Ahhj93/mini-apterros/README.md

# Mini-Apterros
> [!Note]
> Fusée expérimentale du projet Perseus du CNES

## Contributeurs
|  |  |  |  | 
| :---: | :---: | :---: | :---: | :---: |
| [@Ahhj93](https://github.com/Ahhj93) | [@sblikeice](https://github.com/sblikeice) | [@Margaux-Lapl](https://github.com/Margaux-Lapl) | [@julien0305](https://github.com/julien0305) | [@JoaoCerq](https://github.com/JoaoCerq) |
| Bryan-Sowanna ING | Sara BAILLEUL | Margaux LAPLANTE | Julien THOMAS | João Pedro DA SILVA CERQUIERA |
