Ahhj93/mini-apterros/references_composants.md

## Références des composants
* Turbine de poussée : JP Hobby 120 mm
* Brushless moteur : 1413-KV5000 (12 pâles 40 mm)
