Ahhj93/mini-apterros/docs/labview/actionneurs.pdf

Evaluation
Actionneurs.vi
E:\CNES\Documents\Stage été 2024\Stage été 2024\MiniApterros_V1.2.4(12-07)\Code principal\

Last modified on 05/07/2024 at 11:58
Printed on 20/10/2026 at 14:12

Page 1

error in (no error)

error out
Pmax Roulis

Stop

Actionneurs.vi

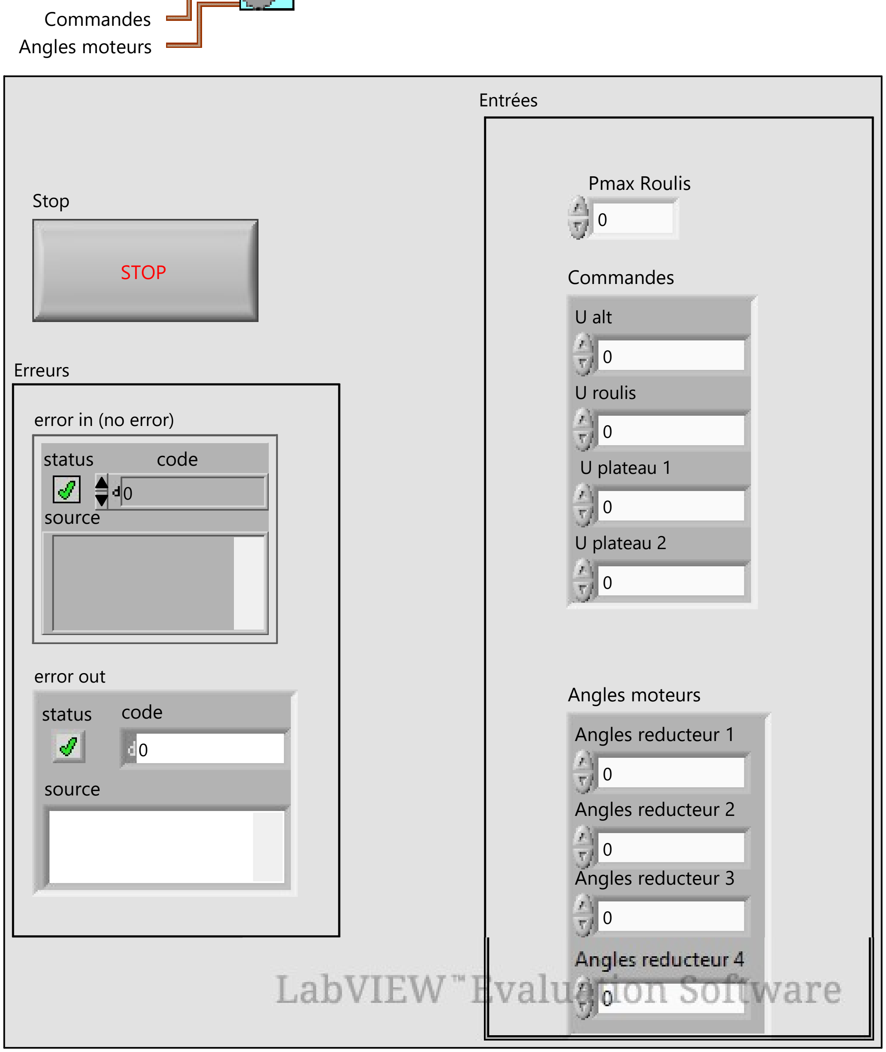
[picture p84: figure]
Angles moteurs; Commandes; STOP; Stop; status; code; source; error in (no error); error out; U alt; U roulis; U plateau 1; U plateau 2; Pmax Roulis; Erreurs; Entrées; Angles reducteur 1; Angles reducteur 2; Angles reducteur 3; Angles reducteur 4

Last modified on 05/07/2024 at 11:58 Printed on 20/10/2026 at 14:12

Page 2

Stop
error in (no error)
<B>error in</B> can accept error information wired from VIs previously called. Use this information to decide if any functionality should be bypassed in the event of errors from other VIs.

Right-click the <B>error in</B> control on the front panel and select <B>Explain Error</B> or <B>Explain Warning</B> from the shortcut menu for more information about the error.
status
<B>status</B> is TRUE (X) if an error occurred or FALSE (checkmark) to indicate a warning or that no error occurred.

Right-click the <B>error in</B> control on the front panel and select <B>Explain Error</B> or <B>Explain Warning</B> from the shortcut menu for more information about the error.
code
<B>code</B> is the error or warning code.

Right-click the <B>error in</B> control on the front panel and select <B>Explain Error</B> or <B>Explain Warning</B> from the shortcut menu for more information about the error. source
<B>source</B> describes the origin of the error or warning.

Right-click the <B>error in</B> control on the front panel and select <B>Explain Error</B> or <B>Explain Warning</B> from the shortcut menu for more information about the error. Commandes
U alt
U roulis
U plateau 1
U plateau 2
Pmax Roulis
Angles moteurs
Angles reducteur 1
Angles reducteur 2
Angles reducteur 3
Angles reducteur 4
error out
<B>error in</B> can accept error information wired from VIs previously called. Use this information to decide if any functionality should be bypassed in the event of errors from other VIs.

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

Last modified on 05/07/2024 at 11:58 Printed on 20/10/2026 at 14:12

Page 3

status
<B>status</B> is TRUE (X) if an error occurred or FALSE (checkmark) to indicate a warning or that no error occurred.

Right-click the <B>error in</B> control on the front panel and select <B>Explain Error</B> or <B>Explain Warning</B> from the shortcut menu for more information about the error.
code
<B>code</B> is the error or warning code.

Right-click the <B>error in</B> control on the front panel and select <B>Explain Error</B> or <B>Explain Warning</B> from the shortcut menu for more information about the error. source
<B>source</B> describes the origin of the error or warning.

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

Stop

error in (no error)

50

0,1

0,05

0,1

0,05

0

error out

0,05

0,05

Commandes

Angle plateau 2.vi

Angle plateau 1.vi

float64 w1=0.05*(1+alpha)+0.05*(1-alpha)*u; float64 w2=0.05*(1+alpha)-0.05*(1-alpha)*u;

w2

w1

alpha

u

Pmax Roulis

100

Angles moteurs

90

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

Page 4

Angle plateau 2.vi
E:\CNES\Documents\Stage été 2024\Stage été 2024\MiniApterros_V1.2.4(12-07)\Code principal\Angle plateau 2.vi
Angle plateau 1.vi
E:\CNES\Documents\Stage été 2024\Stage été 2024\MiniApterros_V1.2.4(12-07)\Code principal\Angle plateau 1.vi
"Actionneurs.vi History"
Current Revision: 121
