Ahhj93/mini-apterros/docs/labview/Angles plateau 1.pdf

Evaluation
Angle plateau 1.vi
E:\CNES\Stage été 2025 v2\Code principal\Angle plateau 1.vi Last modified on 28/03/2025 at 16:16
Printed on 20/10/2026 at 15:02

Page 1

error out

Angle mesuré

Consigne

Angle plateau 1.vi

0 | 0,02 | 0,04 | 0,06 | 0,08 | 0,1

0,02

Proportional Gain (K)

100

-100

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
Consigne

0 0,1 0,2 0,3 0,4 0,5 0,6 0,7 0,8 0,9 1

100

Integral Time (Ti)

0 | 0,02 | 0,04 | 0,06 | 0,08 | 0,1

0,02

Derivative Time (Td)

0

status code 100

-100

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
Angle mesuré

0

Amplitude de sortie

Proportional Gain (K)
<B>Proportional Gain (Kc)</B> represents the proportional gain of the controller.
Consigne
Integral Time (Ti)
<B>Integral Gain (Ki)</B> is the controller parameter that adjusts the effect of the error integral term E(s)/s on the controller output U(s).
Derivative Time (Td)
<B>Integral Gain (Ki)</B> is the controller parameter that adjusts the effect of the error integral term E(s)/s on the controller output U(s).
Angle mesuré
error out
<B>error out</B> passes error or warning information out of a VI to be used by other VIs.

Right-click the <B>error out</B> indicator on the front panel and select <B>Explain Error</B> or <B>Explain Warning</B> from the shortcut menu for more information about the error.
status
code

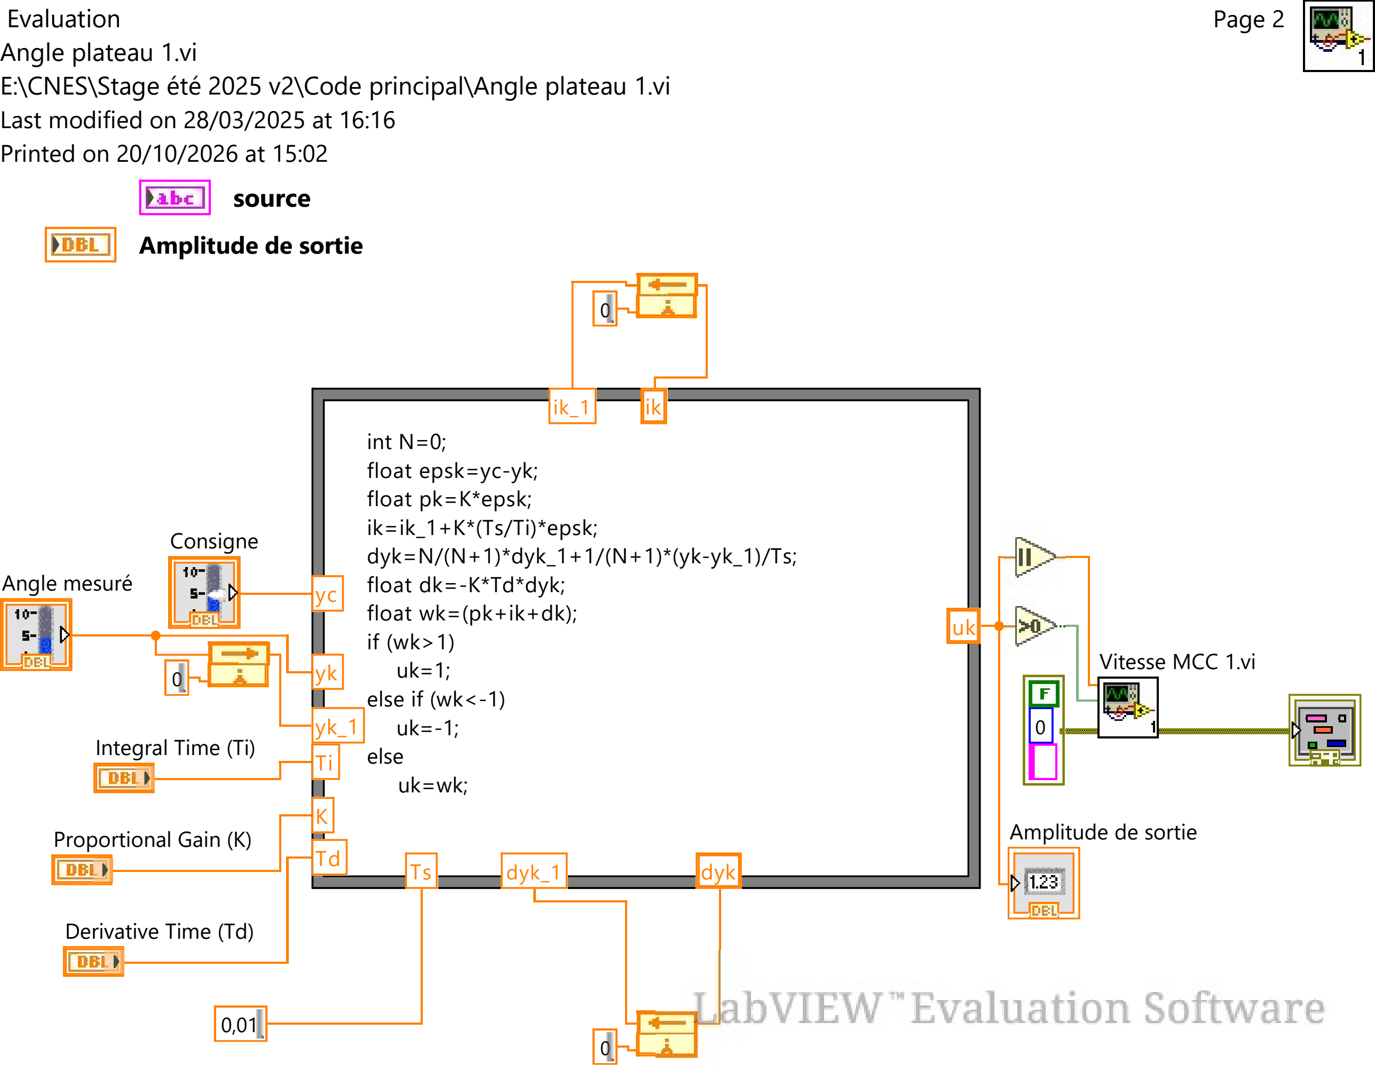
[picture p85: figure]
Evaluation Angle plateau 1.vi; Last modified on 28/03/2025 at 16:16 Printed on 20/10/2026 at 15:02; Page 2; source; Amplitude de sortie; Proportional Gain (K); Consigne; Integral Time (Ti); Derivative Time (Td); int N=0; float epsk=yc-yk; float pk=K*epsk; ik=ik_1+K*(Ts/Ti)*epsk; dyk=N/(N+1)*dyk_1+1/(N+1)*(yk-yk_1)/Ts; float dk=-K*Td*dyk; float wk=(pk+ik+dk); if (wk>1) uk=1; else if (wk<-1) uk=-1; else uk=wk;; dyk_1; dyk; Angle mesuré; Vitesse MCC 1.vi

E:\CNES\Stage été 2025 v2\Code principal\Angle plateau 1.vi
