Ahhj93/mini-apterros/docs/labview/Angles plateau 2.pdf

Evaluation
Angle plateau 2.vi
E:\CNES\Stage été 2025 v2\Code principal\Angle plateau 2.vi Last modified on 28/03/2025 at 16:32
Printed on 20/10/2026 at 15:02

Page 1

Angle plateau 2.vi

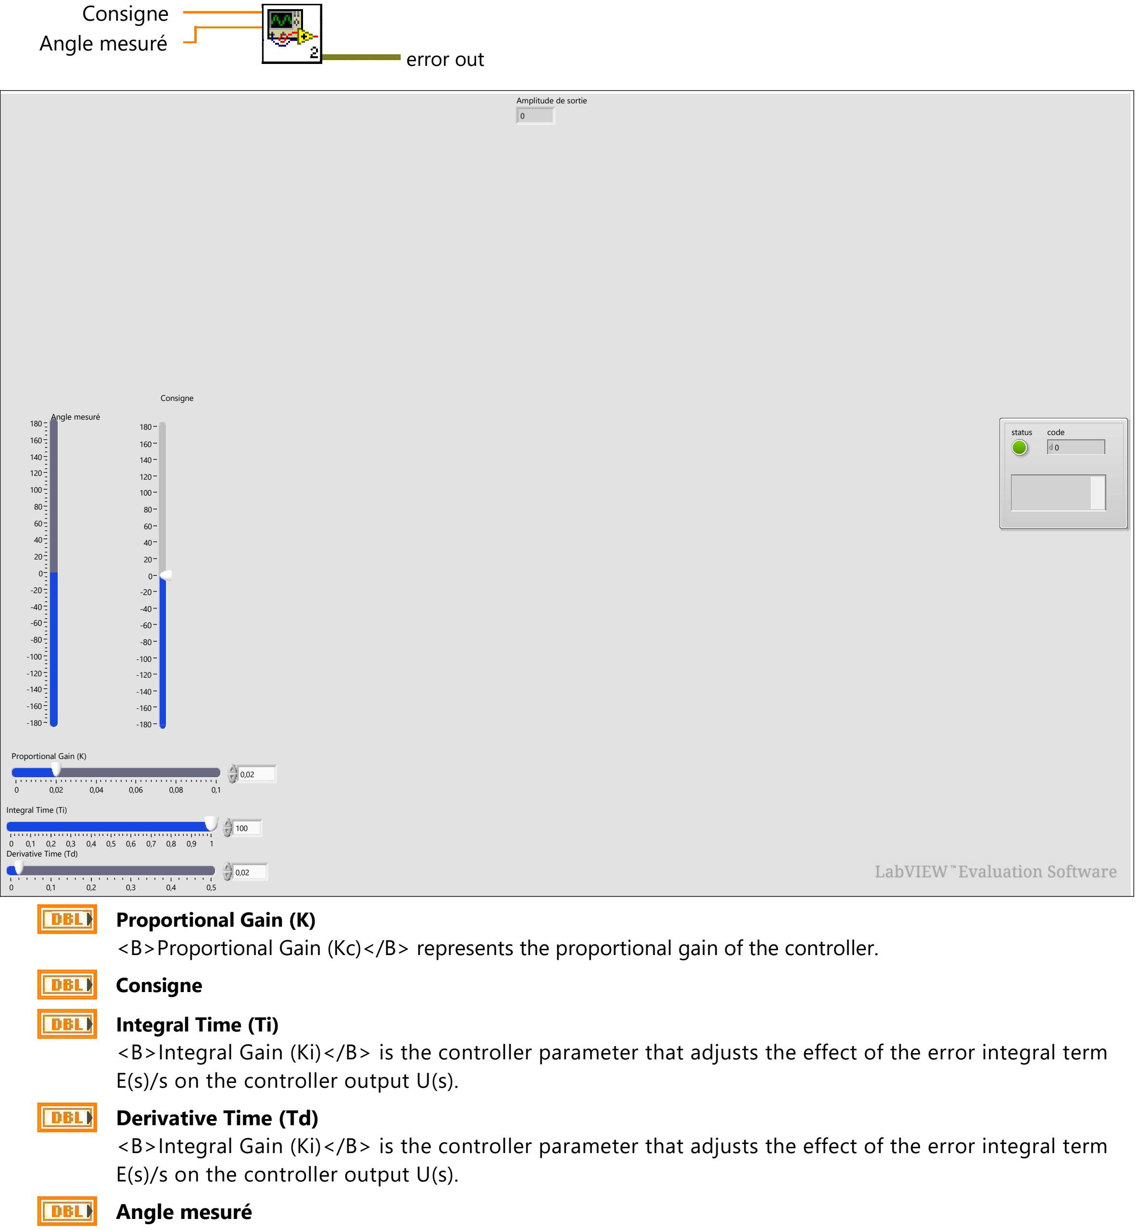
[picture p86: figure]
error out; Angle mesuré; Consigne; Proportional Gain (K); Integral Time (Ti); Derivative Time (Td); status; code; Amplitude de sortie; E(s)/s on the controller output U(s). Derivative Time (Td); E(s)/s on the controller output U(s). Angle mesuré

<B>Proportional Gain (Kc)</B> represents the proportional gain of the controller.

<B>Integral Gain (Ki)</B> is the controller parameter that adjusts the effect of the error integral term

<B>Integral Gain (Ki)</B> is the controller parameter that adjusts the effect of the error integral term

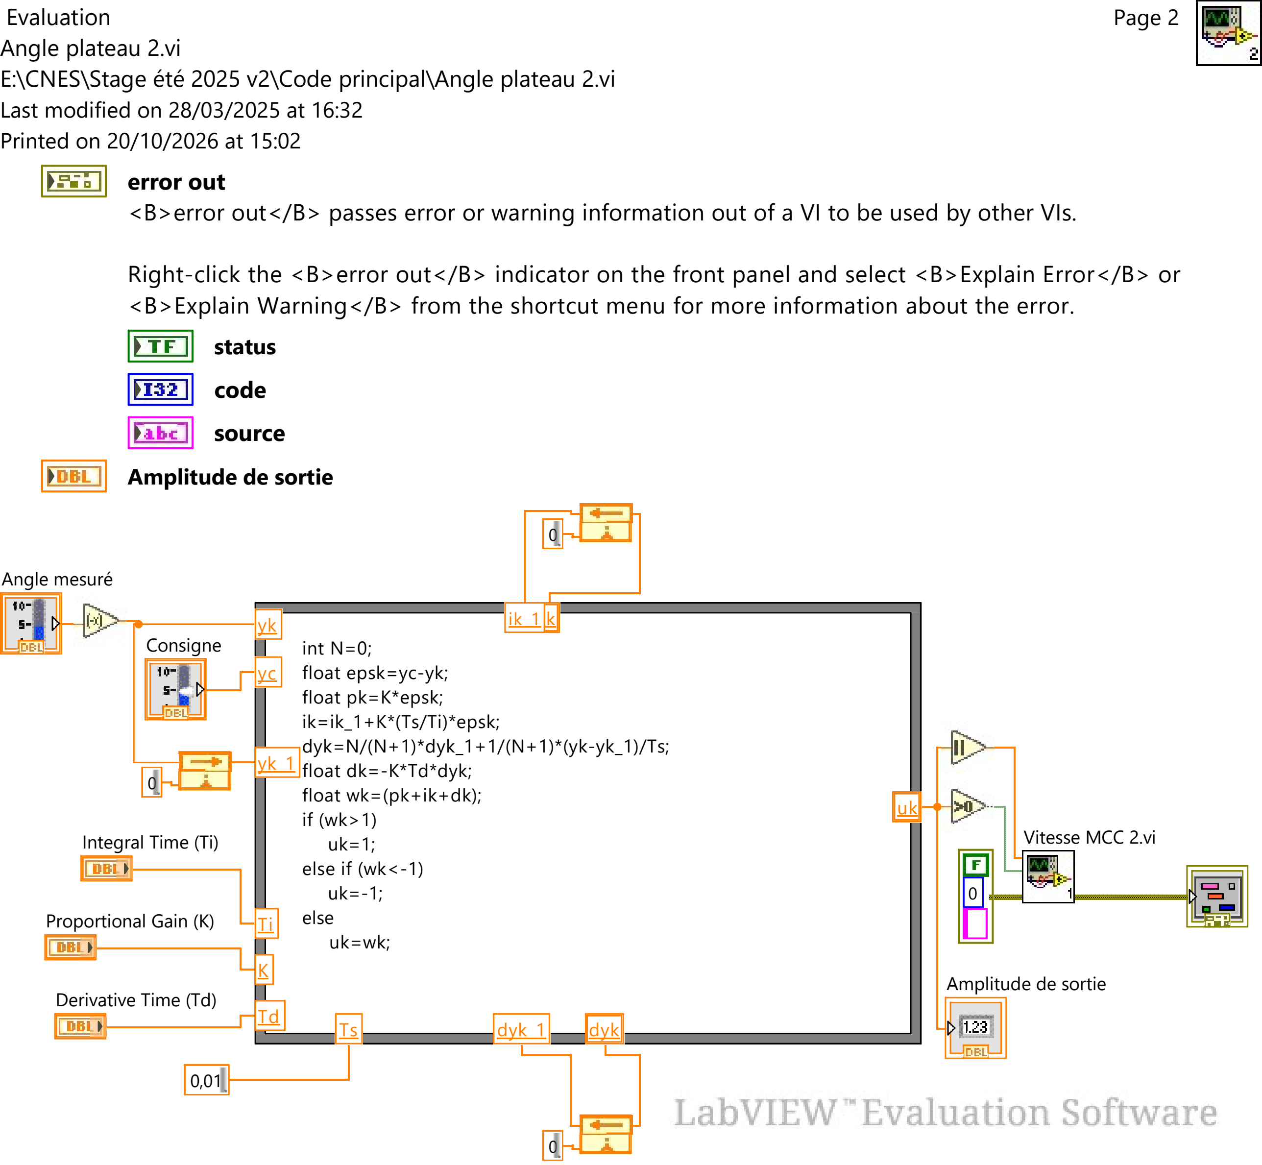
[picture p87: figure]
Evaluation Angle plateau 2.vi; Last modified on 28/03/2025 at 16:32 Printed on 20/10/2026 at 15:02; Page 2; error out; status code source; Amplitude de sortie; Proportional Gain (K); Consigne; Integral Time (Ti); Derivative Time (Td); int N=0; float epsk=yc-yk; float pk=K*epsk; ik=ik_1+K*(Ts/Ti)*epsk; dyk=N/(N+1)*dyk_1+1/(N+1)*(yk-yk_1)/Ts; float dk=-K*Td*dyk; float wk=(pk+ik+dk); if (wk>1) uk=1; else if (wk<-1) uk=-1; else uk=wk;; dyk_1; dyk; Angle mesuré; Vitesse MCC 2.vi

E:\CNES\Stage été 2025 v2\Code principal\Angle plateau 2.vi

<B>error out</B> passes error or warning information out of a VI to be used by other VIs.

Right-click the <B>error out</B> indicator on the front panel and select <B>Explain Error</B> or <B>Explain Warning</B> from the shortcut menu for more information about the error.
