Ahhj93/mini-apterros/docs/labview/Capteurs Angles.pdf

Evaluation
Capteurs Angles.vi
E:\CNES\Stage été 2025 v2\Code principal\Capteurs Angles.vi Last modified on 28/03/2025 at 16:59
Printed on 20/10/2026 at 15:01

Page 1

Angles Hall en degré

error in (no error) | error out

Arrêt

Capteurs Angles.vi

Arrêt | Angles Hall en degré

status
0

code

source

error in (no error)

status
0

code

source

error out

Arrêt
error in (no error)
<B>error in</B> can accept error information wired from VIs previously called. Use this information to decide if any functionality should be bypassed in the event of errors from other VIs.

Right-click the <B>error in</B> control on the front panel and select <B>Explain Error</B> or <B>Explain Warning</B> from the shortcut menu for more information about the error.
status
<B>status</B> is TRUE (X) if an error occurred or FALSE (checkmark) to indicate a warning or that no error occurred.

Right-click the <B>error in</B> control on the front panel and select <B>Explain Error</B> or <B>Explain Warning</B> from the shortcut menu for more information about the error.
code
<B>code</B> is the error or warning code.

Right-click the <B>error in</B> control on the front panel and select <B>Explain Error</B> or <B>Explain Warning</B> from the shortcut menu for more information about the error. source
<B>source</B> describes the origin of the error or warning.

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

Evaluation
Capteurs Angles.vi
E:\CNES\Stage été 2025 v2\Code principal\Capteurs Angles.vi Last modified on 28/03/2025 at 16:59
Printed on 20/10/2026 at 15:01

Page 2

Angles Hall en degré
error out
<B>error in</B> can accept error information wired from VIs previously called. Use this information to decide if any functionality should be bypassed in the event of errors from other VIs.

Right-click the <B>error in</B> control on the front panel and select <B>Explain Error</B> or <B>Explain Warning</B> from the shortcut menu for more information about the error.
status
<B>status</B> is TRUE (X) if an error occurred or FALSE (checkmark) to indicate a warning or that no error occurred.

Right-click the <B>error in</B> control on the front panel and select <B>Explain Error</B> or <B>Explain Warning</B> from the shortcut menu for more information about the error.
code
<B>code</B> is the error or warning code.

Right-click the <B>error in</B> control on the front panel and select <B>Explain Error</B> or <B>Explain Warning</B> from the shortcut menu for more information about the error. source
<B>source</B> describes the origin of the error or warning.

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

Arrêt

Angles Hall en degré

error in (no error)

Valeur n-1 Angle hall 1

Valeur n-1 Anglel hall 2

error out
Lecture angle MCC1.vi

Lecture angle MCC2.vi

Angle hall 1

Angle hall 2

Valeur n-1 Anglel hall 2

Valeur n-1 Angle hall 1
