Ahhj93/mini-apterros/docs/labview/changement adresse Lidar.pdf

Evaluation
Changement adresse Lidar.vi
E:\CNES\Stage été 2025 v2\Code principal\Changement adresse Lidar.vi Last modified on 21/10/2025 at 17:24
Printed on 20/10/2026 at 15:01

Page 1

error in (no error) | error out

Changement adresse Lidar.vi

status
0

code

source

error in (no error)
status
0

code

source

error out

error in (no error)
<B>error in</B> can accept error information wired from VIs previously called. Use this information to decide if any functionality should be bypassed in the event of errors from other VIs.

Right-click the <B>error in</B> control on the front panel and select <B>Explain Error</B> or <B>Explain Warning</B> from the shortcut menu for more information about the error.
status
<B>status</B> is TRUE (X) if an error occurred or FALSE (checkmark) to indicate a warning or that no error occurred.

Right-click the <B>error in</B> control on the front panel and select <B>Explain Error</B> or <B>Explain Warning</B> from the shortcut menu for more information about the error.
code
<B>code</B> is the error or warning code.

Right-click the <B>error in</B> control on the front panel and select <B>Explain Error</B> or <B>Explain Warning</B> from the shortcut menu for more information about the error. source
<B>source</B> describes the origin of the error or warning.

Right-click the <B>error in</B> control on the front panel and select <B>Explain Error</B> or <B>Explain Warning</B> from the shortcut menu for more information about the error. error out
<B>error in</B> can accept error information wired from VIs previously called. Use this information to decide if any functionality should be bypassed in the event of errors from other VIs.

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

Evaluation
Changement adresse Lidar.vi
E:\CNES\Stage été 2025 v2\Code principal\Changement adresse Lidar.vi Last modified on 21/10/2025 at 17:24
Printed on 20/10/2026 at 15:01

Page 2

status
<B>status</B> is TRUE (X) if an error occurred or FALSE (checkmark) to indicate a warning or that no error occurred.

Right-click the <B>error in</B> control on the front panel and select <B>Explain Error</B> or <B>Explain Warning</B> from the shortcut menu for more information about the error.
code
<B>code</B> is the error or warning code.

Right-click the <B>error in</B> control on the front panel and select <B>Explain Error</B> or <B>Explain Warning</B> from the shortcut menu for more information about the error. source
<B>source</B> describes the origin of the error or warning.

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

error in (no error)

62

0 | 18 | 30
0 | 1A | 64
0 | 1E | 8
0 | 19 | 52

error out

True

64

0 1
| 1

Test de lecture de donnée dans un registre LISIBLE pour savoir si l'adresse du lidar est déjà changée. Si c'est le cas, alors on ne peut plus faire le changement

False
