Ahhj93/mini-apterros/docs/labview/Globalvi.pdf

Evaluation
Globalvi.vi
E:\CNES\Stage été 2025 v2\Code principal\Globalvi.vi Last modified on 28/03/2025 at 16:59
Printed on 20/10/2026 at 14:58

Page 1

Globalvi.vi

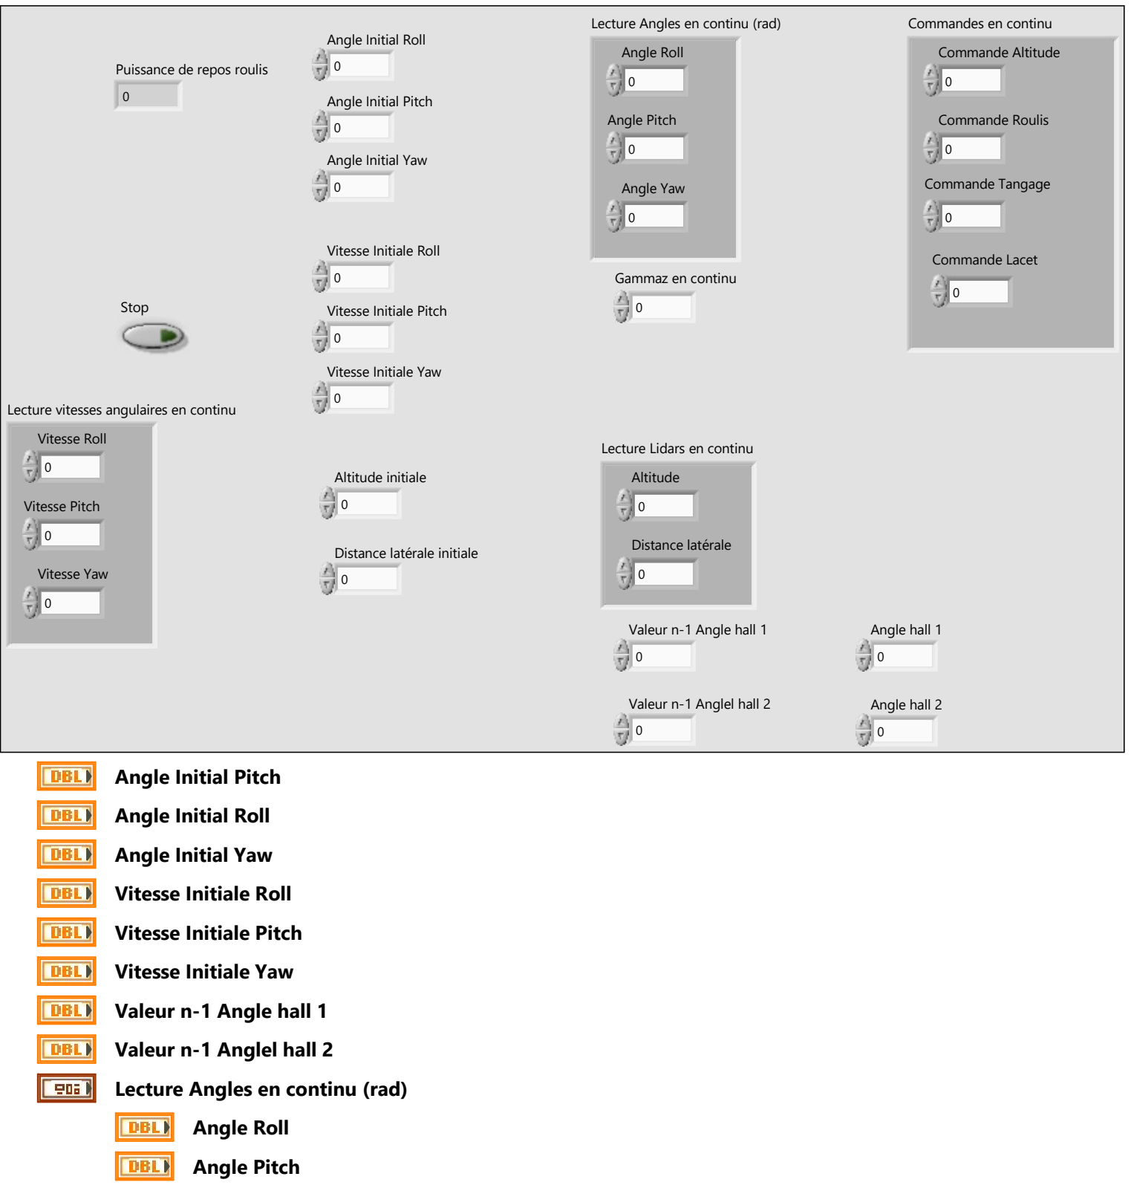
[picture p88: figure]
Angle Initial Pitch; Angle Initial Roll; Angle Initial Yaw; Vitesse Initiale Roll; Vitesse Initiale Pitch; Vitesse Initiale Yaw; Valeur n-1 Angle hall 1; Valeur n-1 Anglel hall 2; Angle Roll; Angle Pitch; Angle Yaw; Lecture Angles en continu (rad); Altitude; Distance latérale; Lecture Lidars en continu; Commande Altitude; Commande Roulis; Commande Tangage; Commande Lacet; Commandes en continu; Stop; Altitude initiale; Distance latérale initiale; Gammaz en continu; Puissance de repos roulis; Angle hall 1; Angle hall 2; Vitesse Roll; Vitesse Pitch; Vitesse Yaw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

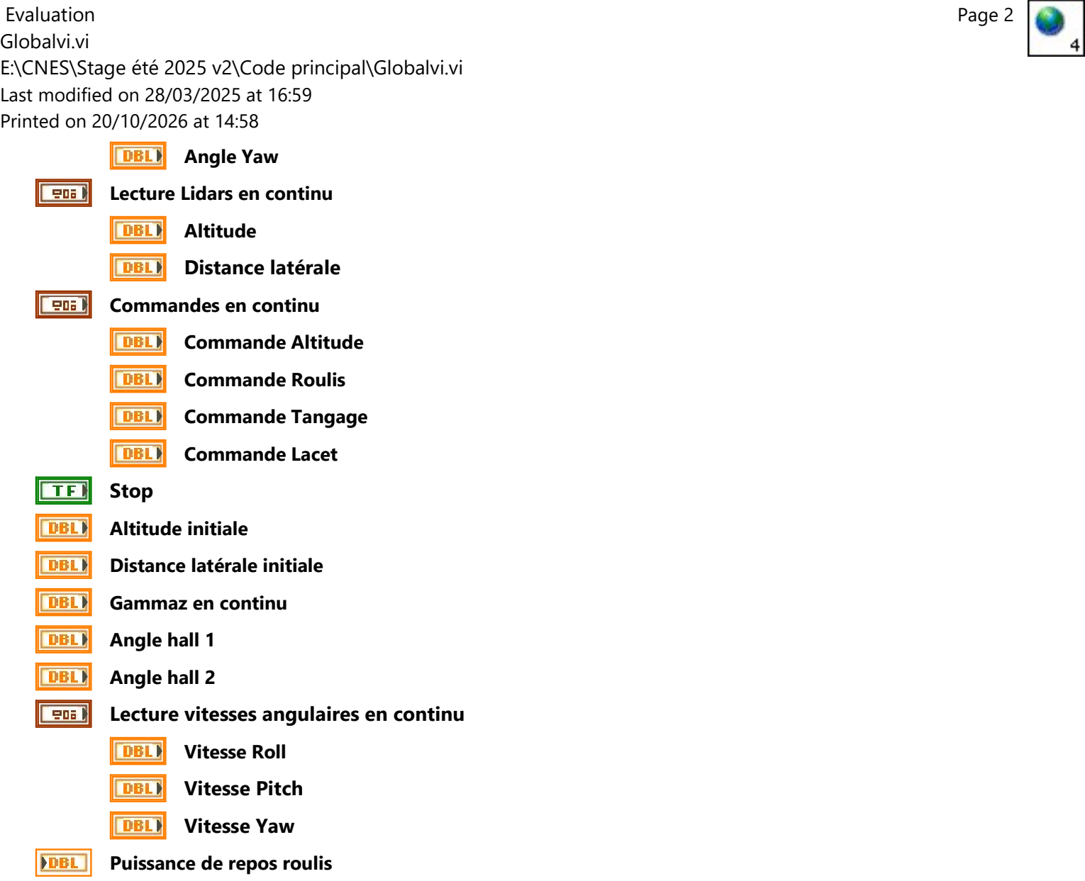
[picture p89: figure]
Evaluation Globalvi.vi E:\CNES\Stage été 2025 v2\Code principal\Globalvi.vi Last modified on 28/03/2025 at 16:59 Printed on 20/10/2026 at 14:58; Page 2; Angle Yaw; Lecture Lidars en continu; Altitude Distance latérale; Commandes en continu; Commande Altitude; Commande Roulis; Commande Tangage; Commande Lacet; Stop; Altitude initiale; Distance latérale initiale; Gammaz en continu; Angle hall 1; Angle hall 2 Lecture vitesses angulaires en continu; Vitesse Roll Vitesse Pitch Vitesse Yaw; Puissance de repos roulis
