Ahhj93/mini-apterros/docs/labview/IMU v2.pdf

Evaluation
IMU v2.vi
E:\CNES\Stage été 2025 v2\Code principal\IMU v2.vi Last modified on 28/03/2025 at 16:59
Printed on 20/10/2026 at 14:57

Page 1

IMU v2.vi

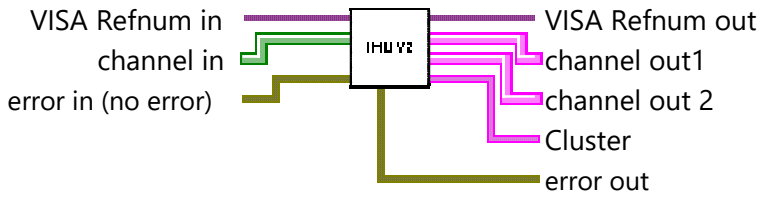
[picture p90: figure]
VISA Refnum out channel out1 channel out 2 Cluster error out; error in (no error); channel in; VISA Refnum in
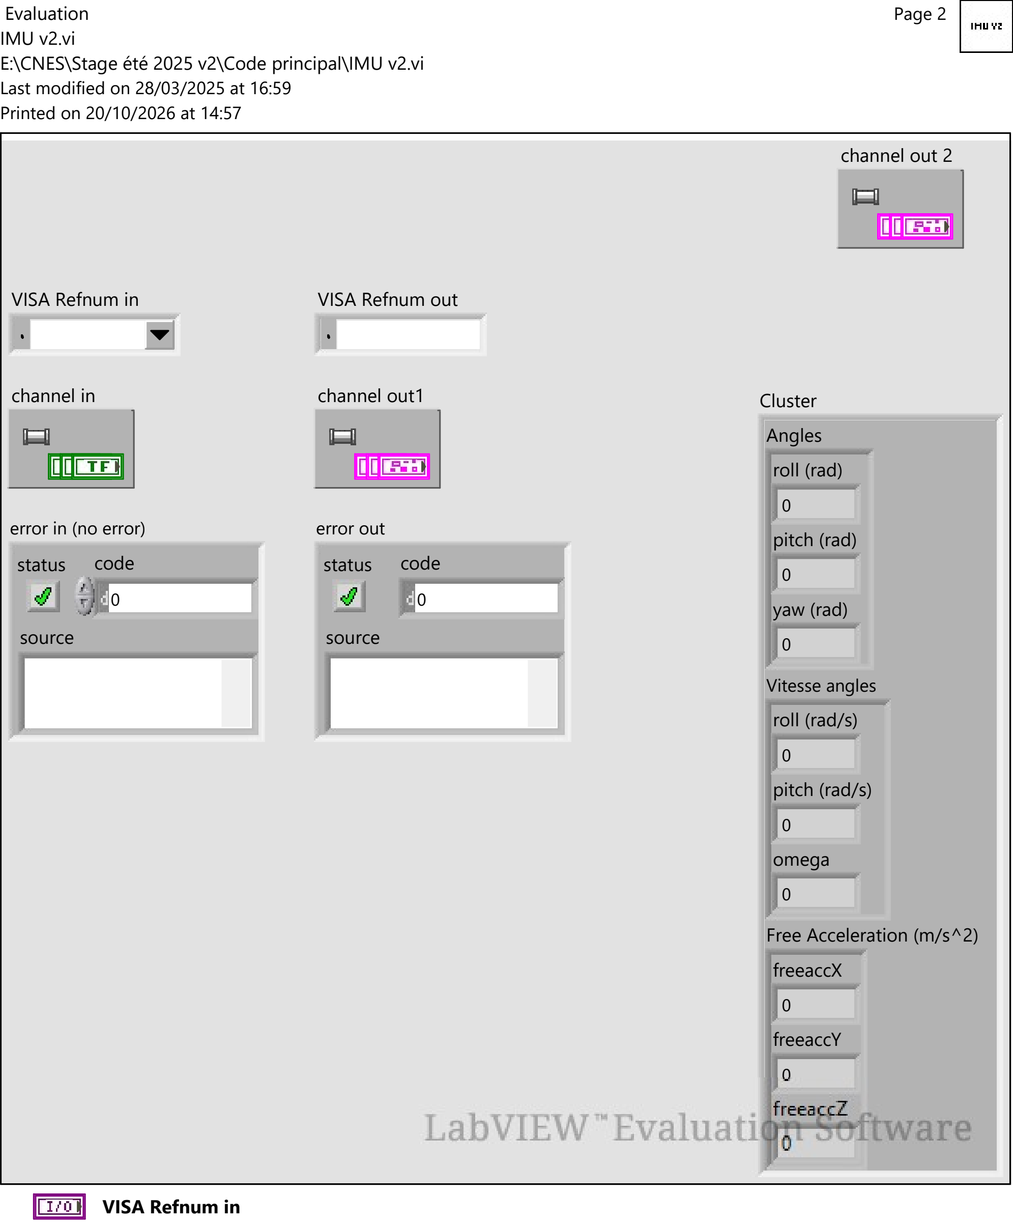
[picture p91: page 2]

Printed on 20/10/2026 at 14:57

Page 2

status
0

code

source

error out

VISA Refnum in | VISA Refnum out

status
0

code

source

error in (no error)

channel in | channel out1

0

freeaccZ

0

freeaccY

0

freeaccX

Free Acceleration (m/s^2)

0

omega

0

pitch (rad/s)

0

roll (rad/s)

Vitesse angles

0

yaw (rad)

0

pitch (rad)

0

roll (rad)

Angles

Cluster

channel out 2

VISA Refnum in

Printed on 20/10/2026 at 14:57

Page 3

error in (no error)
<B>error in</B> can accept error information wired from VIs previously called. Use this information to decide if any functionality should be bypassed in the event of errors from other VIs.

Right-click the <B>error in</B> control on the front panel and select <B>Explain Error</B> or <B>Explain Warning</B> from the shortcut menu for more information about the error.
status
<B>status</B> is TRUE (X) if an error occurred or FALSE (checkmark) to indicate a warning or that no error occurred.

Right-click the <B>error in</B> control on the front panel and select <B>Explain Error</B> or <B>Explain Warning</B> from the shortcut menu for more information about the error.
code
<B>code</B> is the error or warning code.

Right-click the <B>error in</B> control on the front panel and select <B>Explain Error</B> or <B>Explain Warning</B> from the shortcut menu for more information about the error. source
<B>source</B> describes the origin of the error or warning.

Right-click the <B>error in</B> control on the front panel and select <B>Explain Error</B> or <B>Explain Warning</B> from the shortcut menu for more information about the error. channel in
error out
<B>error in</B> can accept error information wired from VIs previously called. Use this information to decide if any functionality should be bypassed in the event of errors from other VIs.

Right-click the <B>error in</B> control on the front panel and select <B>Explain Error</B> or <B>Explain Warning</B> from the shortcut menu for more information about the error.
status
<B>status</B> is TRUE (X) if an error occurred or FALSE (checkmark) to indicate a warning or that no error occurred.

Right-click the <B>error in</B> control on the front panel and select <B>Explain Error</B> or <B>Explain Warning</B> from the shortcut menu for more information about the error.
code
<B>code</B> is the error or warning code.

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

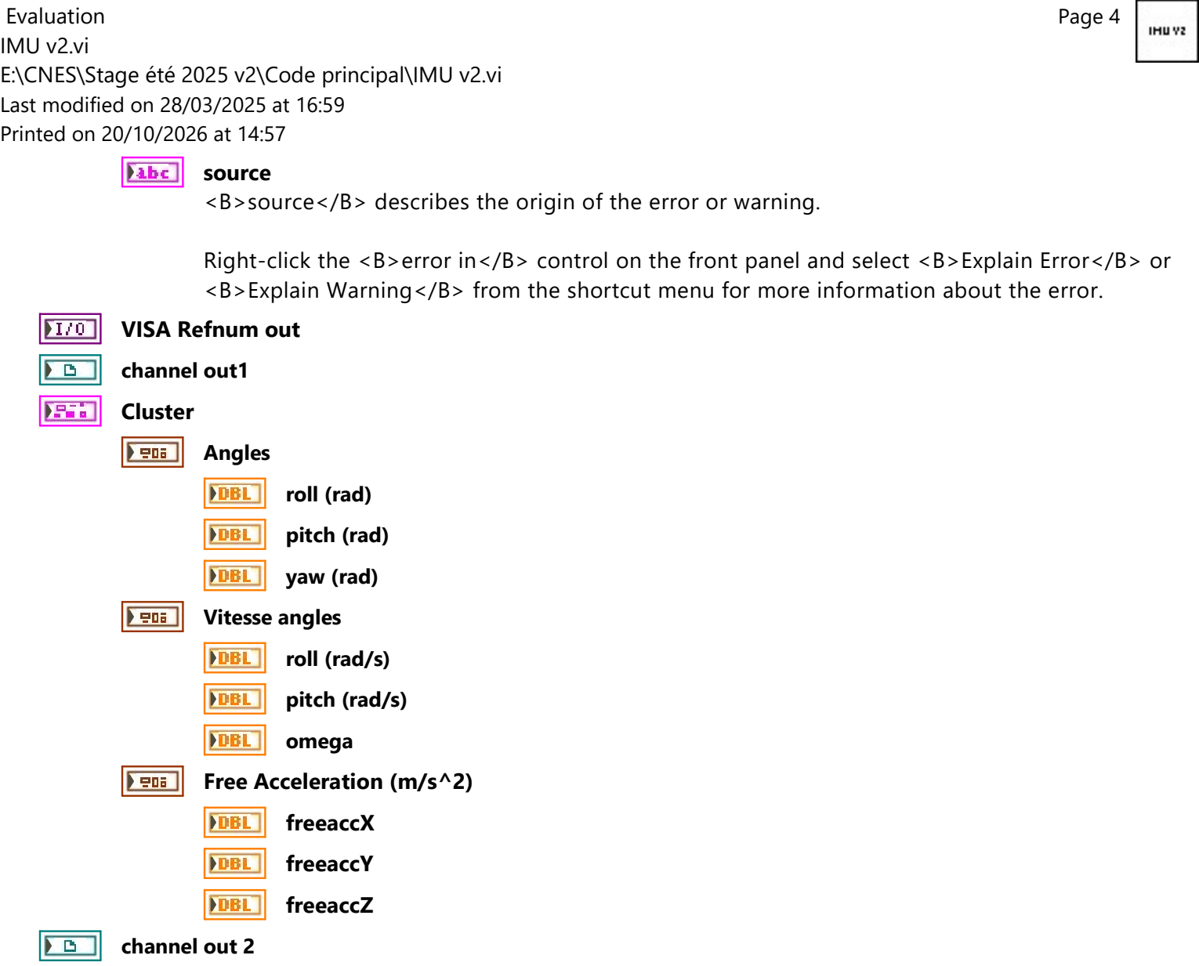
[picture p92: figure]
Printed on 20/10/2026 at 14:57; Page 4; source; VISA Refnum out; channel out1 Cluster; Angles; roll (rad); pitch (rad); yaw (rad); Vitesse angles; roll (rad/s); pitch (rad/s); omega Free Acceleration (m/s^2) freeaccX freeaccY freeaccZ; channel out 2

<B>source</B> describes the origin of the error or warning.

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

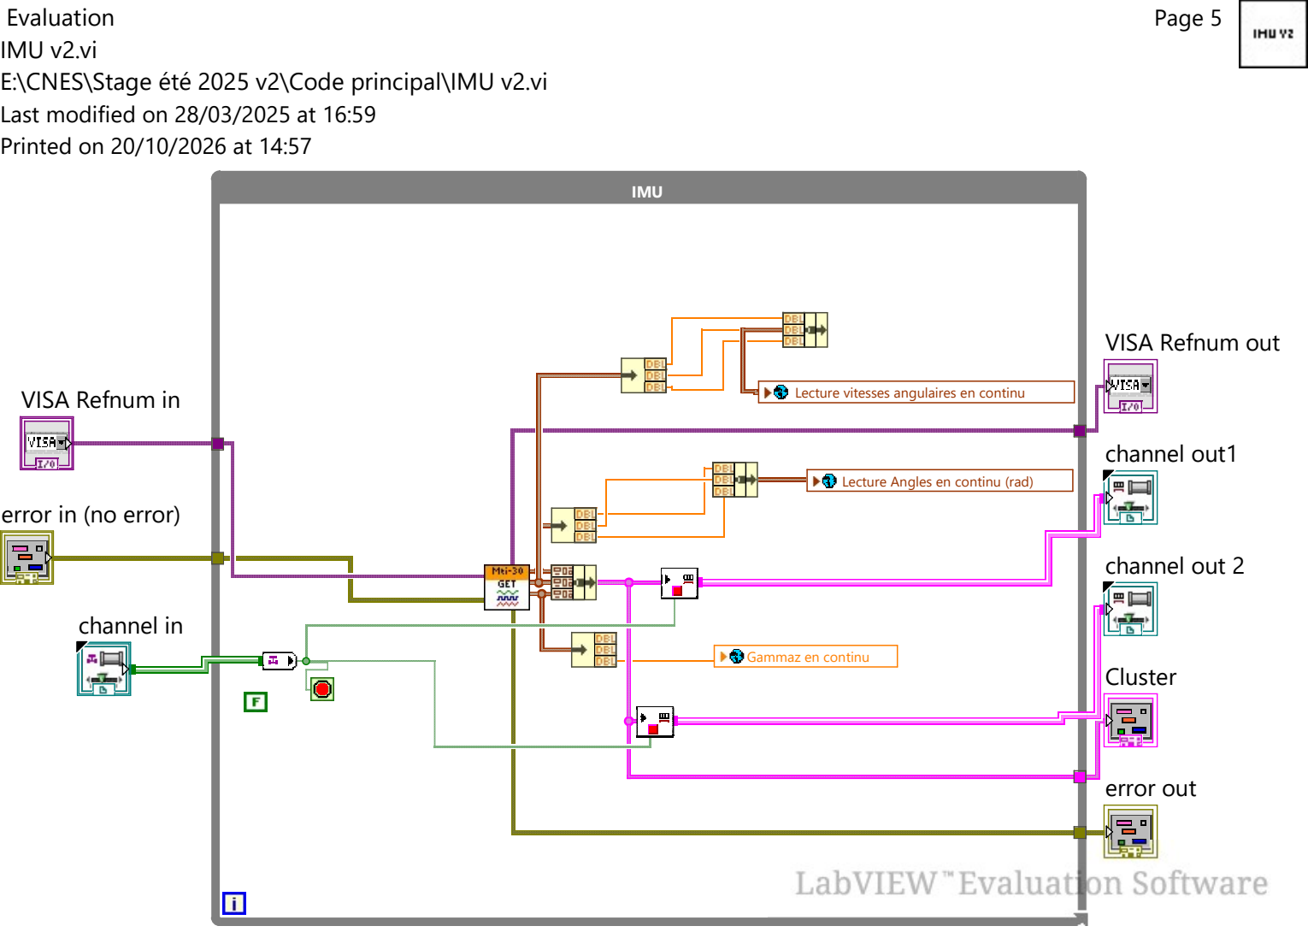
[picture p93: figure]
Printed on 20/10/2026 at 14:57; Page 5; IMU; Lecture Angles en continu (rad); Gammaz en continu; Lecture vitesses angulaires en continu; error out; VISA Refnum out; VISA Refnum in; error in (no error); channel in; channel out1; Cluster; channel out 2
