Ahhj93/mini-apterros/docs/labview/Initialisation Lidar.pdf

Evaluation
Initialisation Lidar.vi
E:\CNES\Stage été 2025 v2\Code principal\Initialisation Lidar.vi Last modified on 21/10/2025 at 17:24
Printed on 20/10/2026 at 14:56

Page 1

error out
error in (no error)

Slave Address (7-bit)

Initialisation Lidar.vi

status
0

code

source

error out

status
0

code

source

error in (no error)

0

Slave Address (7-bit)

error in (no error)
<B>error in</B> can accept error information wired from VIs previously called. Use this information to decide if any functionality should be bypassed in the event of errors from other VIs.

Right-click the <B>error in</B> control on the front panel and select <B>Explain Error</B> or <B>Explain Warning</B> from the shortcut menu for more information about the error.
status
<B>status</B> is TRUE (X) if an error occurred or FALSE (checkmark) to indicate a warning or that no error occurred.

Right-click the <B>error in</B> control on the front panel and select <B>Explain Error</B> or <B>Explain Warning</B> from the shortcut menu for more information about the error.

Printed on 20/10/2026 at 14:56

Page 2

code
<B>code</B> is the error or warning code.

Right-click the <B>error in</B> control on the front panel and select <B>Explain Error</B> or <B>Explain Warning</B> from the shortcut menu for more information about the error. source
<B>source</B> describes the origin of the error or warning.

Right-click the <B>error in</B> control on the front panel and select <B>Explain Error</B> or <B>Explain Warning</B> from the shortcut menu for more information about the error. Slave Address (7-bit)
error out
<B>error out</B> passes error or warning information out of a VI to be used by other VIs.

Right-click the <B>error out</B> indicator on the front panel and select <B>Explain Error</B> or <B>Explain Warning</B> from the shortcut menu for more information about the error.
status
<B>status</B> is TRUE (X) if an error occurred or FALSE (checkmark) to indicate a warning or that no error occurred.

Right-click the <B>error out</B> indicator on the front panel and select <B>Explain Error</B> or <B>Explain Warning</B> from the shortcut menu for more information about the error. code
<B>code</B> is the error or warning code.

Right-click the <B>error out</B> indicator on the front panel and select <B>Explain Error</B> or <B>Explain Warning</B> from the shortcut menu for more information about the error. source
<B>source</B> string describes the origin of the error or warning.

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

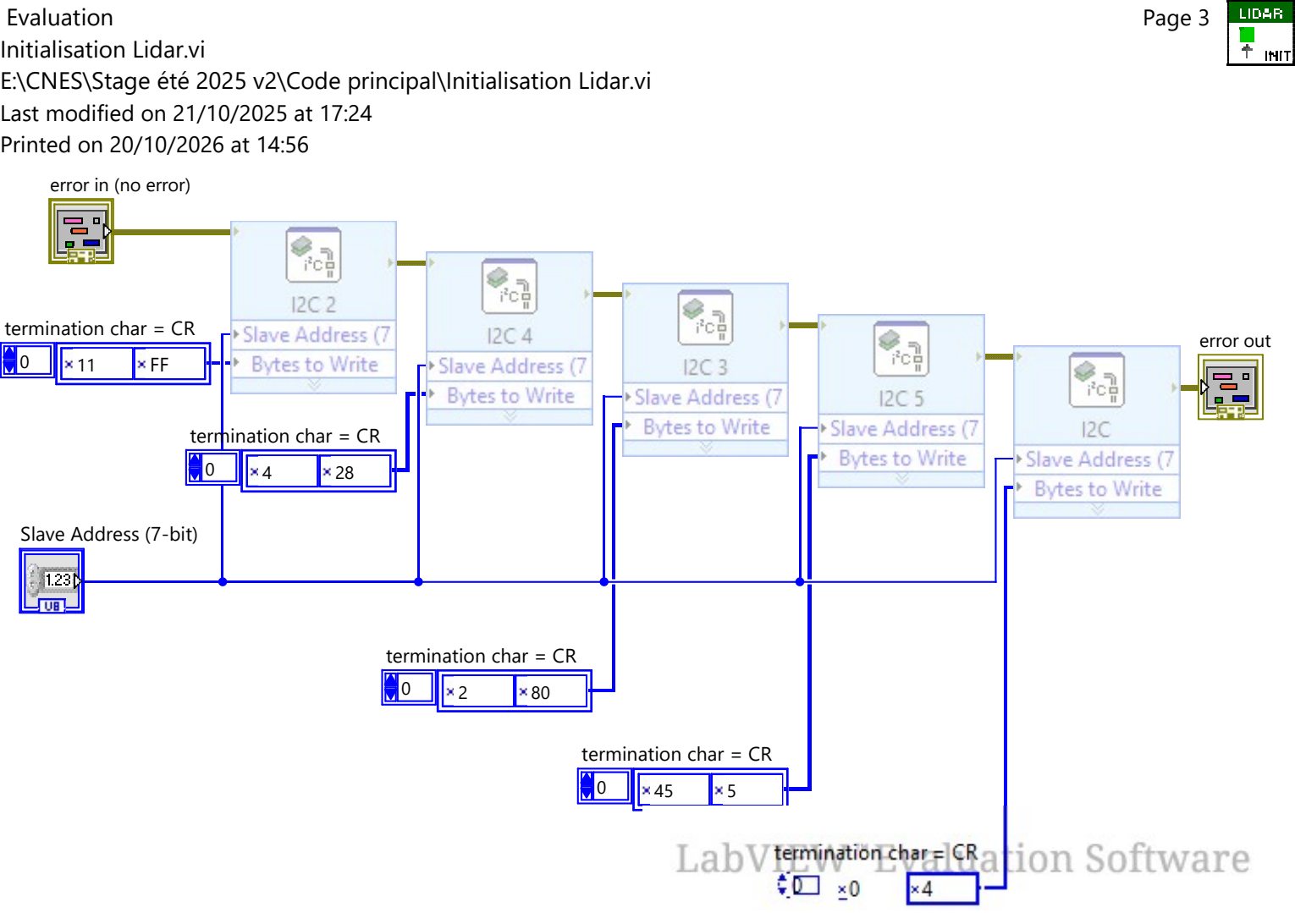
[picture p94: figure]
Printed on 20/10/2026 at 14:56; Page 3; termination char = CR; error out; error in (no error); Slave Address (7-bit)
