Ahhj93/mini-apterros/docs/labview/Initialisation Xsens.pdf

Evaluation
Initialisation Xsens.vi
E:\CNES\Stage été 2025 v2\Code principal\Initialisation Xsens.vi Last modified on 05/07/2024 at 10:37
Printed on 20/10/2026 at 14:56

Page 1

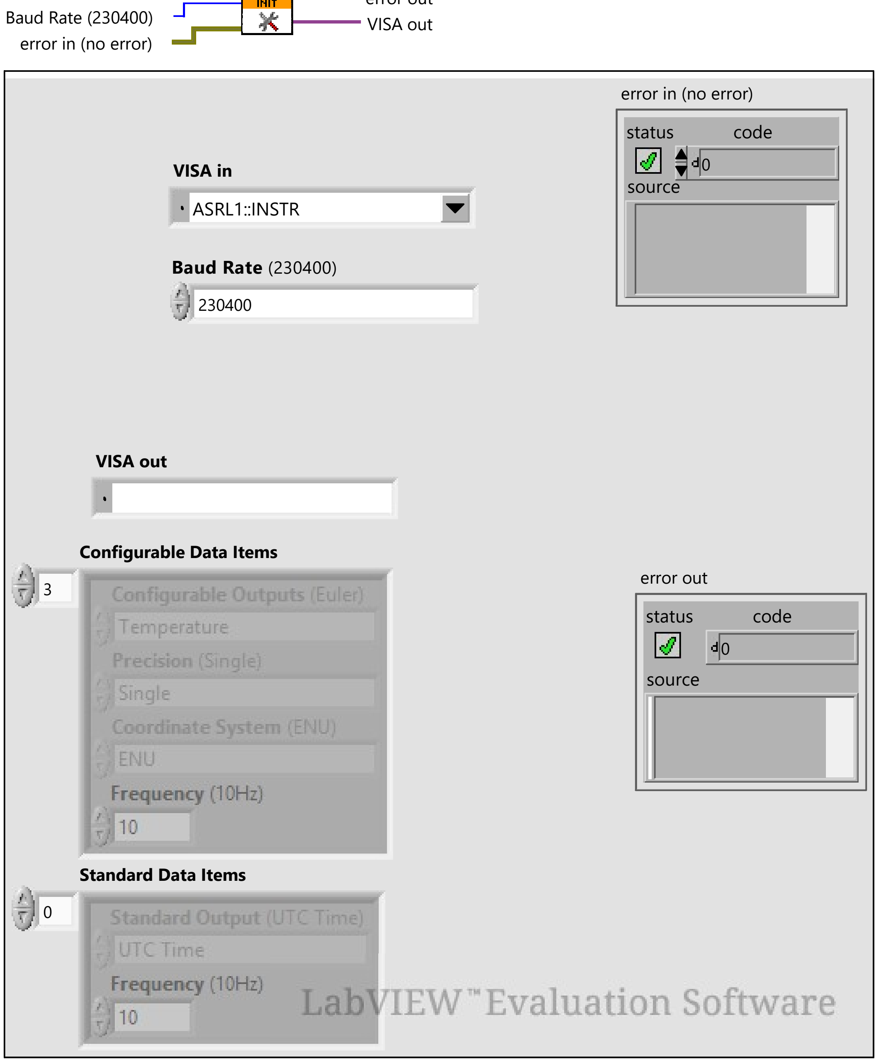
[picture p95: figure]
VISA out; error in (no error); Baud Rate (230400); status; code; source; error out; ASRL1::INSTR; VISA in; Temperature; Configurable Outputs (Euler); Single; Precision (Single); ENU; Coordinate System (ENU); Frequency (10Hz); Configurable Data Items; UTC Time; Standard Output (UTC Time); Standard Data Items

error out

VISA in

Initialisation Xsens.vi

Printed on 20/10/2026 at 14:56

Page 2

error in (no error)
<B>error in</B> can accept error information wired from VIs previously called. Use this information to decide if any functionality should be bypassed in the event of errors from other VIs.

Right-click the <B>error in</B> control on the front panel and select <B>Explain Error</B> or <B>Explain Warning</B> from the shortcut menu for more information about the error.
status
<B>status</B> is TRUE (X) if an error occurred or FALSE (checkmark) to indicate a warning or that no error occurred.

Right-click the <B>error in</B> control on the front panel and select <B>Explain Error</B> or <B>Explain Warning</B> from the shortcut menu for more information about the error.
code
<B>code</B> is the error or warning code.

Right-click the <B>error in</B> control on the front panel and select <B>Explain Error</B> or <B>Explain Warning</B> from the shortcut menu for more information about the error. source
<B>source</B> describes the origin of the error or warning.

Right-click the <B>error in</B> control on the front panel and select <B>Explain Error</B> or <B>Explain Warning</B> from the shortcut menu for more information about the error.
VISA in
Specifies which instrument to use. Instruments that are powered on and connected to your computer are visible in the <B>VISA resource name</B> pull-down menu. Select the resource name from the <B>VISA resource name</B> pull-down menu. If your instrument does not appear in this list, enter the instrument descriptor using the following format:
Interface Type[board index]::Address::INSTR.

<B>Examples:</B>
<B>GPIB:</B> GPIB::22::INSTR, GPIB board 0, primary address 22 <B>Serial:</B> COM1
<B>TCP/IP Instr:</B> TCPIP::10.0.32.48::INSTR
<B>TCP/IP Socket:</B> TCPIP::10.0.32.45::3800::SOCKET
<B>USB Instr:</B> Selectable from VISA Resource Name pull-down menu
<B>USB Raw:</B> You must first link VISA to non-USBTMC instruments by using the VISA Driver Development Wizard
<B>VISA Alias:</B> "SampleInstr" - Alias names are configured in MAX

Refer to the LabVIEW Help for more information about specifying a VISA resource name.

Printed on 20/10/2026 at 14:56

Page 3

Baud Rate (230400)
Specifies the rate at which data is transmitted across the serial interface.

<b>Valid Values: </b>
921600
460800
230400
115200
57600
38400
28800
19200
14400
9600
4800

Default Value:
115200

Configurable Data Items
An array of the configurable data items to be streamed by the MTi.

Data Item
A data packet that can be returned from the MT

Printed on 20/10/2026 at 14:56

Page 4

Configurable Outputs (Euler)
The output that will be streamed from the MTi when in measurement mode.

<b>Valid Values:</b>
Temperature
Quaternion
Rotation Matrix
Euler Angles
Delta V
Acceleration
Free Acceleration
Rate Of Turn
Magnetic Field
Delta Q
Baro Pressure
Altitude Ellipsoid
Position ECEF
Lat & Lon
Velocity

Default Value:
Euler Anlgles
Precision (Single)
The output format of the MTi.

<b>Valid Values:</b>
Single
12.20
16.32
Double

Default Value:
Single
Coordinate System (ENU)
ENU - East-North-Up coordinate system NED - North-East-Down coordinate system NWU - North-West-Up

<b>Valid Values:</b>
ENU
NED
NWU

Default Value:
ENU

Printed on 20/10/2026 at 14:56

Page 5

Frequency (10Hz)
The rate at which data is sent from the MTi.

<b>Valid Range:</b>
Min: 1Hz
Max: 65535Hz

Default Value:
10
Standard Data Items
An array of the standard data items to be streamed by the MTi.

Standard Data Item
A data item that can't be configured. Standard Output (UTC Time)
The output that will be streamed from the MTi when in measurement mode.

<b>Valid Values:</b>
UTC Time
Packet Counter
Sample Time Fine
Sample Time Coarse
Status Byte
Status Word

Default Value:
UTC Time
Frequency (10Hz)
The rate at which data is sent from the MTi.

<b>Valid Range:</b>
Min: 1Hz
Max: 65535Hz

Default Value:
10
error out
<B>error out</B> passes error or warning information out of a VI to be used by other VIs.

Right-click the <B>error out</B> indicator on the front panel and select <B>Explain Error</B> or <B>Explain Warning</B> from the shortcut menu for more information about the error.

Printed on 20/10/2026 at 14:56

Page 6

status
<B>status</B> is TRUE (X) if an error occurred or FALSE (checkmark) to indicate a warning or that no error occurred.

Right-click the <B>error out</B> indicator on the front panel and select <B>Explain Error</B> or <B>Explain Warning</B> from the shortcut menu for more information about the error. code
<B>code</B> is the error or warning code.

Right-click the <B>error out</B> indicator on the front panel and select <B>Explain Error</B> or <B>Explain Warning</B> from the shortcut menu for more information about the error. source
<B>source</B> string describes the origin of the error or warning.

Right-click the <B>error out</B> indicator on the front panel and select <B>Explain Error</B> or <B>Explain Warning</B> from the shortcut menu for more information about the error. VISA out
Specifies which instrument to use. Instruments that are powered on and connected to your computer are visible in the <B>VISA resource name</B> pull-down menu. Select the resource name from the <B>VISA resource name</B> pull-down menu. If your instrument does not appear in this list, enter the instrument descriptor using the following format:
Interface Type[board index]::Address::INSTR.

<B>Examples:</B>
<B>GPIB:</B> GPIB::22::INSTR, GPIB board 0, primary address 22 <B>Serial:</B> COM1
<B>TCP/IP Instr:</B> TCPIP::10.0.32.48::INSTR
<B>TCP/IP Socket:</B> TCPIP::10.0.32.45::3800::SOCKET
<B>USB Instr:</B> Selectable from VISA Resource Name pull-down menu
<B>USB Raw:</B> You must first link VISA to non-USBTMC instruments by using the VISA Driver Development Wizard
<B>VISA Alias:</B> "SampleInstr" - Alias names are configured in MAX

Refer to the LabVIEW Help for more information about specifying a VISA resource name.

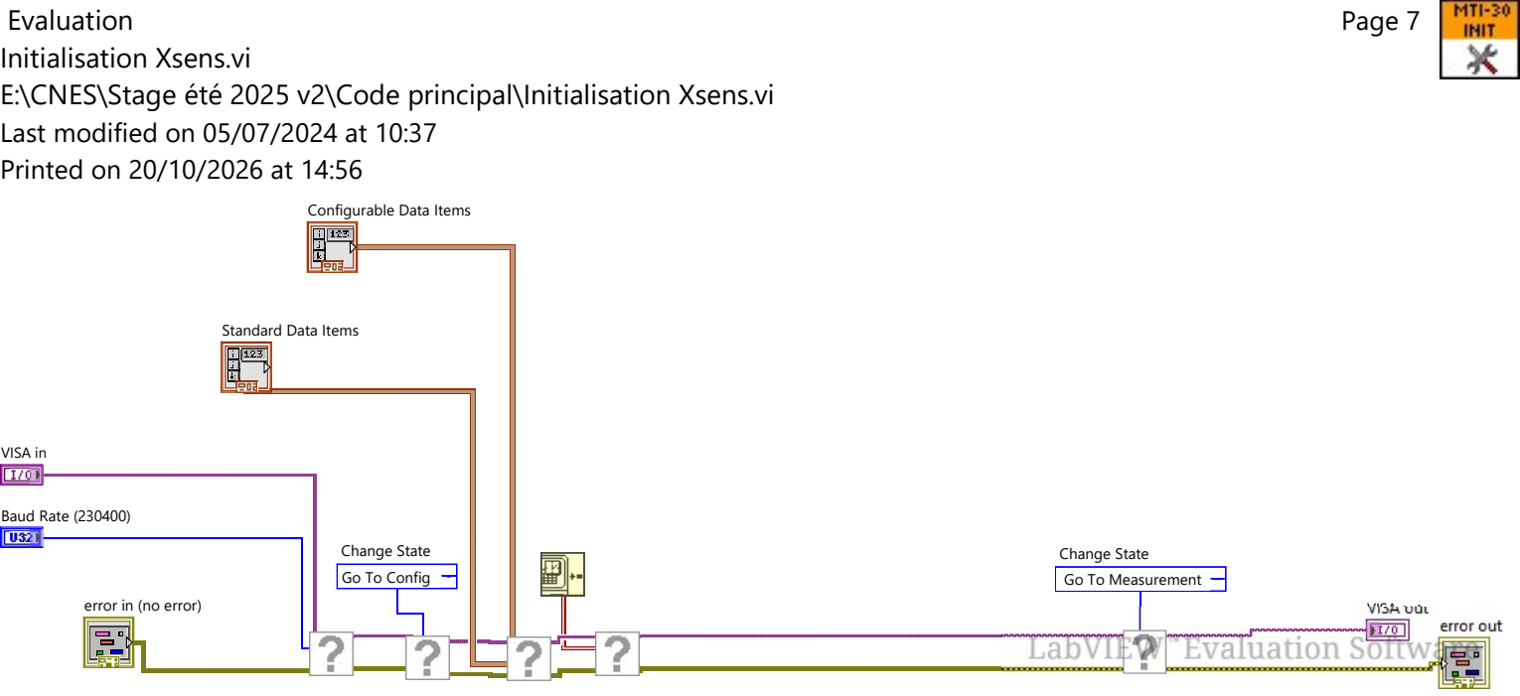
[picture p96: figure]
Printed on 20/10/2026 at 14:56; Page 7; Go To Config; Change State; error in (no error); error out; VISA in; Baud Rate (230400); VISA out; Go To Measurement; Configurable Data Items; Standard Data Items
