Ahhj93/mini-apterros/docs/labview/Lecture Xsens.pdf

Evaluation
Lecture Xsens.vi
E:\CNES\Stage été 2025 v2\Code principal\Lecture Xsens.vi Last modified on 31/01/2025 at 14:21
Printed on 20/10/2026 at 14:54

Page 1

VISA Xsens Out
Angles
Vitesse angles
Free Acceleration (m/s^2)
error out

error in (no error)

VISA Xsens In

Lecture Xsens.vi

ASRL1:

VISA Xsens In

status
0

code

source

error out

ASRL1::INSTR

VISA Xsens Out

0

v.x

0

v.y

0

v.z

Delta V (m/s)

0

accX

0

accY

0

accZ

Acceleration (m/s^2)

0

freeaccX

0

freeaccY

0

freeaccZ

Free Acceleration (m/s^2)

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
Delta Q

0

roll (rad/s)

0

pitch (rad/s)

0

omega

Vitesse angles

0

roll (rad)

0

pitch (rad)

0

yaw (rad)

Angles

status
0

code

source

error in (no error)

Erreurs

VISA Xsens In
error in (no error)
<B>error in</B> can accept error information wired from VIs previously called. Use this information to decide if any functionality should be bypassed in the event of errors from other VIs.

Right-click the <B>error in</B> control on the front panel and select <B>Explain Error</B> or <B>Explain Warning</B> from the shortcut menu for more information about the error.
status
<B>status</B> is TRUE (X) if an error occurred or FALSE (checkmark) to indicate a warning or that no error occurred.

Right-click the <B>error in</B> control on the front panel and select <B>Explain Error</B> or <B>Explain Warning</B> from the shortcut menu for more information about the error.

Printed on 20/10/2026 at 14:54

Page 2

code
<B>code</B> is the error or warning code.

Right-click the <B>error in</B> control on the front panel and select <B>Explain Error</B> or <B>Explain Warning</B> from the shortcut menu for more information about the error. source
<B>source</B> describes the origin of the error or warning.

Right-click the <B>error in</B> control on the front panel and select <B>Explain Error</B> or <B>Explain Warning</B> from the shortcut menu for more information about the error. error out
<B>error out</B> passes error or warning information out of a VI to be used by other VIs.

Right-click the <B>error out</B> indicator on the front panel and select <B>Explain Error</B> or <B>Explain Warning</B> from the shortcut menu for more information about the error.
status
<B>status</B> is TRUE (X) if an error occurred or FALSE (checkmark) to indicate a warning or that no error occurred.

Right-click the <B>error out</B> indicator on the front panel and select <B>Explain Error</B> or <B>Explain Warning</B> from the shortcut menu for more information about the error. code
<B>code</B> is the error or warning code.

Right-click the <B>error out</B> indicator on the front panel and select <B>Explain Error</B> or <B>Explain Warning</B> from the shortcut menu for more information about the error. source
<B>source</B> string describes the origin of the error or warning.

Right-click the <B>error out</B> indicator on the front panel and select <B>Explain Error</B> or <B>Explain Warning</B> from the shortcut menu for more information about the error. VISA Xsens Out
Delta V (m/s)
Contains the delta velocity value of the SDI output v.x
Delta velocity in X
v.y
Delta velocity in Y
v.z
Delta velocity in Z
Acceleration (m/s^2)
The calibrated acceleration vector in X, Y, and Z axes

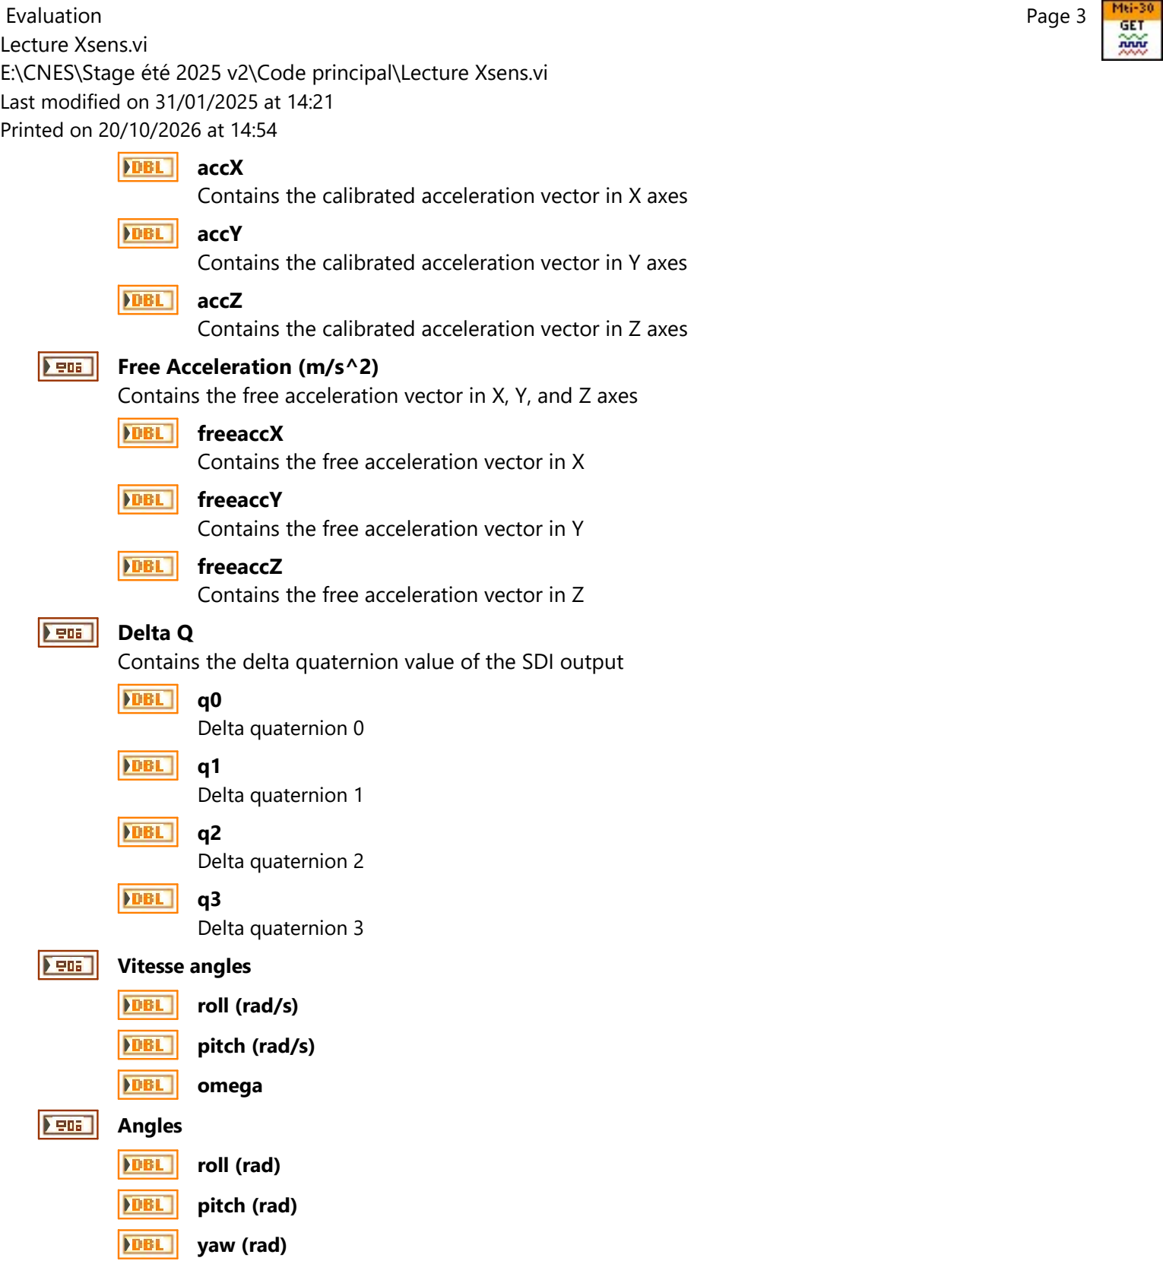
[picture p97: figure]
Printed on 20/10/2026 at 14:54; Page 3; accX; accY; accZ; Free Acceleration (m/s^2); freeaccX; freeaccY; freeaccZ; Delta Q; q0 Delta quaternion 0 q1 Delta quaternion 1 q2 Delta quaternion 2 q3 Delta quaternion 3 Vitesse angles; roll (rad/s); pitch (rad/s); omega; Angles; roll (rad); pitch (rad); yaw (rad)

Contains the calibrated acceleration vector in X axes

Contains the calibrated acceleration vector in Y axes

Contains the calibrated acceleration vector in Z axes

Contains the free acceleration vector in X, Y, and Z axes

Contains the free acceleration vector in X

Contains the free acceleration vector in Y

Contains the free acceleration vector in Z

Contains the delta quaternion value of the SDI output

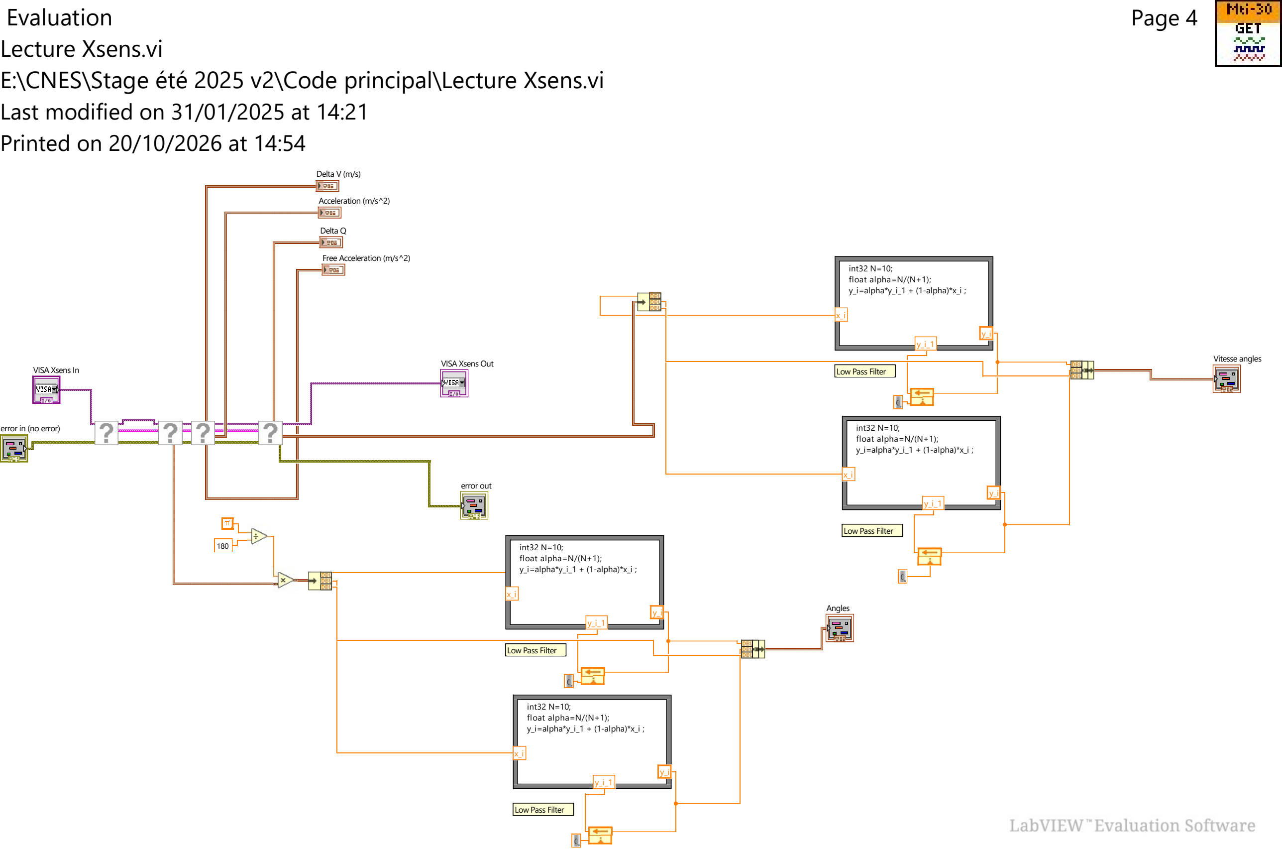
[picture p98: figure]
Printed on 20/10/2026 at 14:54; Page 4; VISA Xsens In; error out; VISA Xsens Out; Delta V (m/s); Acceleration (m/s^2); Free Acceleration (m/s^2); Delta Q; Vitesse angles; Angles; error in (no error); Low Pass Filter; int32 N=10; float alpha=N/(N+1); y_i=alpha*y_i_1 + (1-alpha)*x_i ;
