Ahhj93/mini-apterros/docs/labview/Lidar v2.pdf

Evaluation
Lidars v2.vi
E:\CNES\Stage été 2025 v2\Code principal\Lidars v2.vi Last modified on 01/07/2025 at 11:04
Printed on 20/10/2026 at 14:53

Page 1

channel
Cluster
error out

error in (no error)

Channel in

Lidars v2.vi

Channel in

status
0

code

source

error out
status
0

code

source

error in (no error)

0

0

Cluster | channel

Channel in
error in (no error)
<B>error in</B> can accept error information wired from VIs previously called. Use this information to decide if any functionality should be bypassed in the event of errors from other VIs.

Right-click the <B>error in</B> control on the front panel and select <B>Explain Error</B> or <B>Explain Warning</B> from the shortcut menu for more information about the error.
status
<B>status</B> is TRUE (X) if an error occurred or FALSE (checkmark) to indicate a warning or that no error occurred.

Right-click the <B>error in</B> control on the front panel and select <B>Explain Error</B> or <B>Explain Warning</B> from the shortcut menu for more information about the error.
code
<B>code</B> is the error or warning code.

Right-click the <B>error in</B> control on the front panel and select <B>Explain Error</B> or <B>Explain Warning</B> from the shortcut menu for more information about the error. source
<B>source</B> describes the origin of the error or warning.

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

Evaluation
Lidars v2.vi
E:\CNES\Stage été 2025 v2\Code principal\Lidars v2.vi Last modified on 01/07/2025 at 11:04
Printed on 20/10/2026 at 14:53

Page 2

error out
<B>error in</B> can accept error information wired from VIs previously called. Use this information to decide if any functionality should be bypassed in the event of errors from other VIs.

Right-click the <B>error in</B> control on the front panel and select <B>Explain Error</B> or <B>Explain Warning</B> from the shortcut menu for more information about the error.
status
<B>status</B> is TRUE (X) if an error occurred or FALSE (checkmark) to indicate a warning or that no error occurred.

Right-click the <B>error in</B> control on the front panel and select <B>Explain Error</B> or <B>Explain Warning</B> from the shortcut menu for more information about the error.
code
<B>code</B> is the error or warning code.

Right-click the <B>error in</B> control on the front panel and select <B>Explain Error</B> or <B>Explain Warning</B> from the shortcut menu for more information about the error. source
<B>source</B> describes the origin of the error or warning.

Right-click the <B>error in</B> control on the front panel and select <B>Explain Error</B> or <B>Explain Warning</B> from the shortcut menu for more information about the error. Cluster

channel
Lidars

Lecture Lidars en continu
Lecture des valeurs réelles, pour les envoyer directement aux correcteurs

Channel in

error out
error in (no error)

Cluster

channel
