Ahhj93/mini-apterros/docs/labview/Mesure Lidar Latéral.pdf

Evaluation
Mesure Lidar Latéral.vi
E:\CNES\Stage été 2025 v2\Code principal\Mesure Lidar Latéral.vi Last modified on 15/11/2024 at 15:34
Printed on 20/10/2026 at 14:53

Page 1

error out
error in (no error) | Altitude (m)

Slave Address (7-bit)

Mesure Lidar Latéral.vi

status
0

code

source

error in (no error)

0

Altitude (m)

0

code

source

status

error out

0

0

Bytes Read

0

element

0

x << y
0

element 2
0

Slave Address (7-bit)

error in (no error)
<B>error in</B> can accept error information wired from VIs previously called. Use this information to decide if any functionality should be bypassed in the event of errors from other VIs.

Right-click the <B>error in</B> control on the front panel and select <B>Explain Error</B> or <B>Explain Warning</B> from the shortcut menu for more information about the error.
status
<B>status</B> is TRUE (X) if an error occurred or FALSE (checkmark) to indicate a warning or that no error occurred.

Right-click the <B>error in</B> control on the front panel and select <B>Explain Error</B> or <B>Explain Warning</B> from the shortcut menu for more information about the error.
code
<B>code</B> is the error or warning code.

Right-click the <B>error in</B> control on the front panel and select <B>Explain Error</B> or <B>Explain Warning</B> from the shortcut menu for more information about the error.

Evaluation
Mesure Lidar Latéral.vi
E:\CNES\Stage été 2025 v2\Code principal\Mesure Lidar Latéral.vi Last modified on 15/11/2024 at 15:34
Printed on 20/10/2026 at 14:53

Page 2

source
<B>source</B> describes the origin of the error or warning.

Right-click the <B>error in</B> control on the front panel and select <B>Explain Error</B> or <B>Explain Warning</B> from the shortcut menu for more information about the error. Slave Address (7-bit)
Altitude (m)
error out
<B>error in</B> can accept error information wired from VIs previously called. Use this information to decide if any functionality should be bypassed in the event of errors from other VIs.

Right-click the <B>error in</B> control on the front panel and select <B>Explain Error</B> or <B>Explain Warning</B> from the shortcut menu for more information about the error.
status
code
source
Bytes Read

element
x << y
element 2

error in (no error)

2

0 8F

termination char = CR

1

100

Get new distance (cm)

distance (m)

0,1

Processing of illogical data (<10cm)

0

0

Low Pass Filter

Altitude (m)

error out

float alpha=0.99;
y_i=alpha*y_i_1 + (1-alpha)*x_i ;

x_i

y_i_1

y_i

Bytes Read

element

0

x << y

element 2

8

Slave Address (7-bit)
