Ahhj93/mini-apterros/docs/labview/PID Altitude.pdf

# Evaluation PID Altitude.vi E:\CNES\Stage été 2025 v2\Code principal\PID Altitude.vi

## Last modified on 03/07/2025 at 15:47 Printed on 20/10/2026 at 14:50

## Page 1

# Commande altitude

## Discrete Step Size (s)

# Accéleration Verticale

h

# Consigne h

## PID Altitude.vi

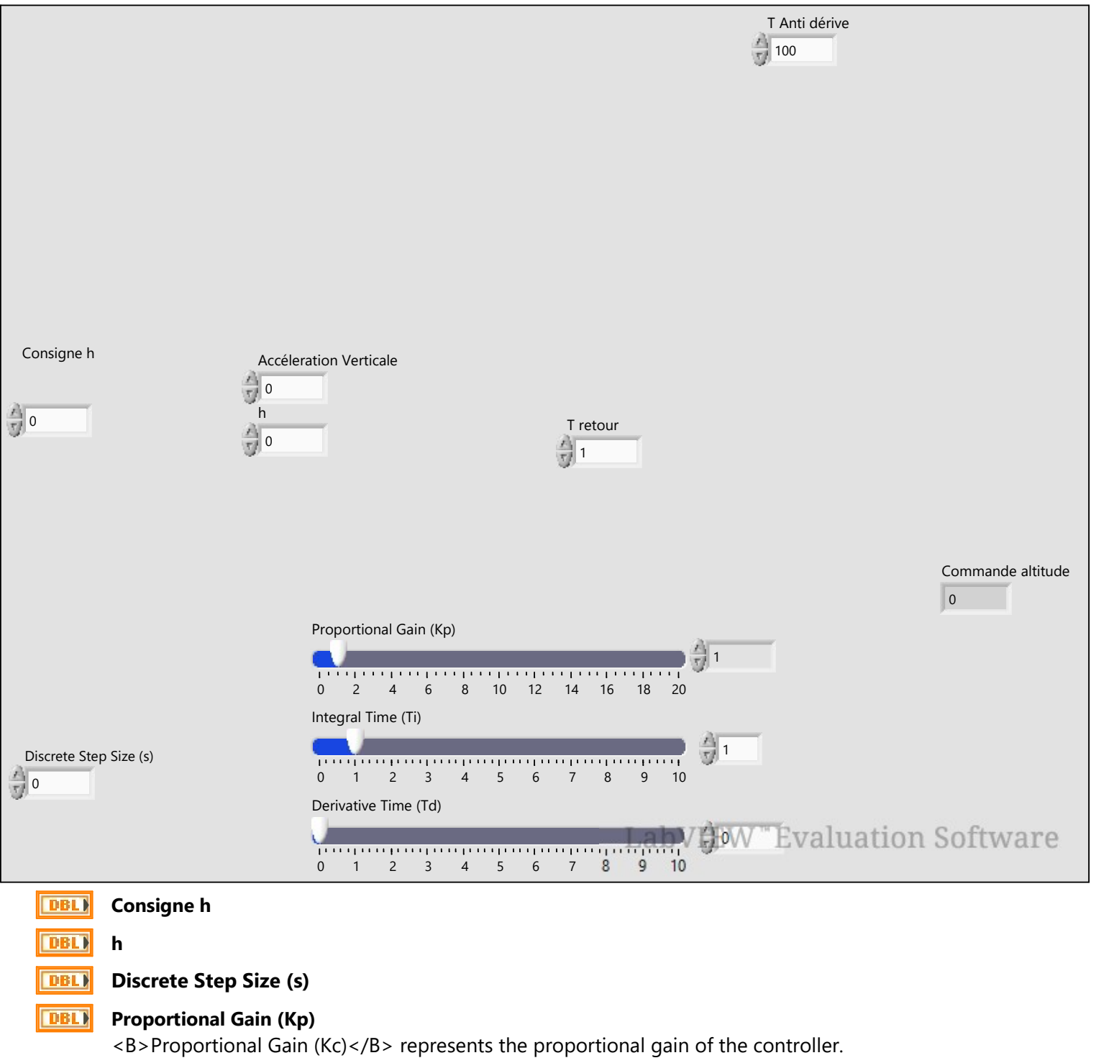
[picture p99: figure]
Consigne h; Discrete Step Size (s); Commande altitude; Proportional Gain (Kp); Integral Time (Ti); Derivative Time (Td); T retour; T Anti dérive; Accéleration Verticale; h Discrete Step Size (s)

<B>Proportional Gain (Kc)</B> represents the proportional gain of the controller.

# Evaluation PID Altitude.vi E:\CNES\Stage été 2025 v2\Code principal\PID Altitude.vi

## Last modified on 03/07/2025 at 15:47 Printed on 20/10/2026 at 14:50

## Page 2

## Integral Time (Ti)

<B>Integral Gain (Ki)</B> is the controller parameter that adjusts the effect of the error integral term E(s)/s on the controller output U(s).

# Derivative Time (Td)

<B>Derivative Gain (Kd)</B> is the controller parameter that adjusts the effect of the error derivative term sE(s) on the controller output U(s).

# T retour[] T retour T Anti dérive Accéleration Verticale

## Commande altitude

Consigne h

h

Discrete Step Size (s)

Commande altitude
Proportional Gain (Kp)

Integral Time (Ti)

Derivative Time (Td)

T Anti dérive

float64 alpha =1; // alpha = 0 si accelerometre non utilise. Sinon alpha =0.95 parametre OK int32 N=10; // Si bruit faible, prendre N = 5
// Utiliser en partie l'altitude pour calculer la vitesse permet d'arreter les turbines a l'atterrissage float64 vk=alpha*(vk_1+Ts*gk)+(1-alpha)*((N/(N+1)*vk_1+1/(N+1)*(zk-zk_1)/Ts));
float64 epsk=(zc-zk)-vk*Tr;
float64 ik=ik_1+Kp*Ts/Ti*epsk+Kp*Ts/Tad*(uk_1-wk_1);
float64 pk=Kp*epsk;
0 | zk | // gk=N/(N+1)*gk_1+1/(N+1)*(vk-vk_1)/Ts // ligne a supprimer si accelerometre OK float64 dk=-Kp*Td*(vk+Tr*gk); float64 wk=dk+ik+pk; {if (wk>1) {uk=1;} } | zc if (wk<0) {uk=0;} else {uk=wk;} | ik_1 | ik | vk_1 | vk

else {

}

uk

wk

Ts | Tad | gk | wk_1

Tr

Td

Ti

Kp

uk_1

zk_1

0

Accéleration Verticale

0

0

0
