Ahhj93/mini-apterros/docs/labview/PID Pitch.pdf

Evaluation
PID Pitch.vi
E:\CNES\Stage été 2025 v2\Code principal\PID Pitch.vi Last modified on 21/10/2025 at 17:24
Printed on 20/10/2026 at 14:50

Page 1

Commande Pitch
pitch

Consigne pitch

PID Pitch.vi

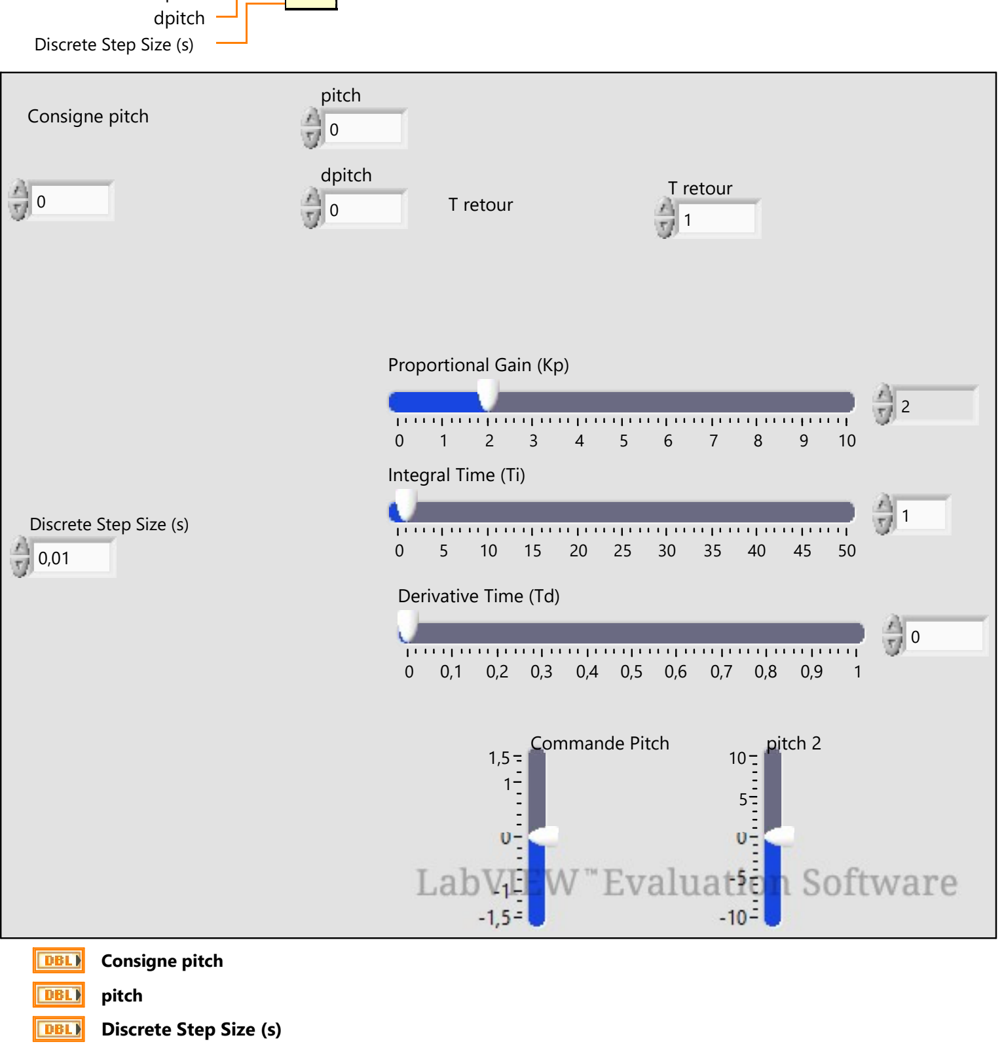
[picture p100: figure]
Discrete Step Size (s); dpitch; Consigne pitch; pitch; Commande Pitch; Proportional Gain (Kp); Integral Time (Ti); Derivative Time (Td); T retour; pitch 2; Consigne pitch pitch Discrete Step Size (s)

Evaluation
PID Pitch.vi
E:\CNES\Stage été 2025 v2\Code principal\PID Pitch.vi Last modified on 21/10/2025 at 17:24
Printed on 20/10/2026 at 14:50

Page 2

dpitch
Proportional Gain (Kp)
<B>Proportional Gain (Kc)</B> represents the proportional gain of the controller.
Integral Time (Ti)
<B>Integral Gain (Ki)</B> is the controller parameter that adjusts the effect of the error integral term E(s)/s on the controller output U(s).
Derivative Time (Td)
<B>Derivative Gain (Kd)</B> is the controller parameter that adjusts the effect of the error derivative term sE(s) on the controller output U(s).
T retour[T retour]
T retour
Commande Pitch
pitch 2

Consigne pitch

pitch

Discrete Step Size (s)

dpitch

Commande Pitch

Proportional Gain (Kp)

Integral Time (Ti)

Derivative Time (Td)

T retour

int32 N=10;
float64 epsk=(yc-yk)-Omega_k*Tr;
float64 ik=ik_1+Kp*Ts/Ti*epsk;
float64 pk=Kp*epsk;
float64 dOmega_k=N/(N+1)*dOmega_k_1+1/(N+1)*(Omega_k-Omega_k_1)/Ts; float64 dk=-Kp*Td*(Omega_k+Tr*dOmega_k);
float64 wk=dk+ik+pk;
if (wk>1)
uk=1;
else {
if (wk<-1)
uk=-1;
else
uk=wk;
}

Omega_kOmega_k_1

uk

ik_1 | ik | dOmega_k_1dOmega_k

Ts

Tr

Td

Ti

Kp

yk_1

yk

yc

0

0 0

0

pitch 2

radians to degrees
(x/pi)*180.0
