Ahhj93/mini-apterros/docs/labview/PID Roll.pdf

Evaluation
PID Roll.vi
E:\CNES\Stage été 2025 v2\Code principal\PID Roll.vi Last modified on 08/07/2025 at 14:51
Printed on 20/10/2026 at 14:49

Page 1

Commande Roll
roll

Consigne roll

PID Roll.vi

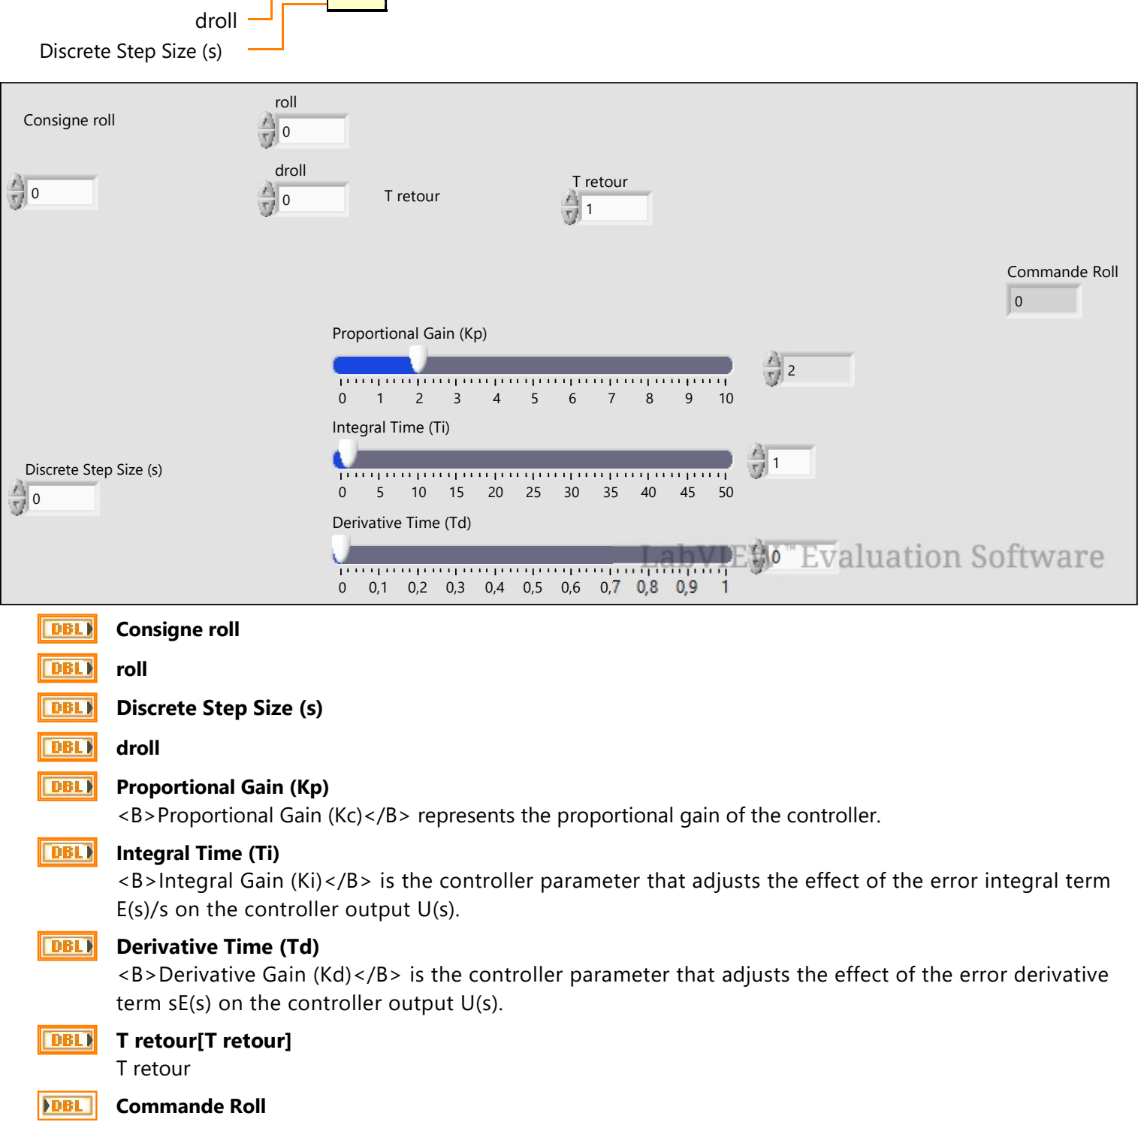
[picture p101: figure]
Discrete Step Size (s); droll; Consigne roll; roll; Commande Roll; Proportional Gain (Kp); Integral Time (Ti); Derivative Time (Td); T retour; roll Discrete Step Size (s); E(s)/s on the controller output U(s). Derivative Time (Td); T retour[T retour] T retour Commande Roll

<B>Proportional Gain (Kc)</B> represents the proportional gain of the controller.

<B>Integral Gain (Ki)</B> is the controller parameter that adjusts the effect of the error integral term

<B>Derivative Gain (Kd)</B> is the controller parameter that adjusts the effect of the error derivative term sE(s) on the controller output U(s).

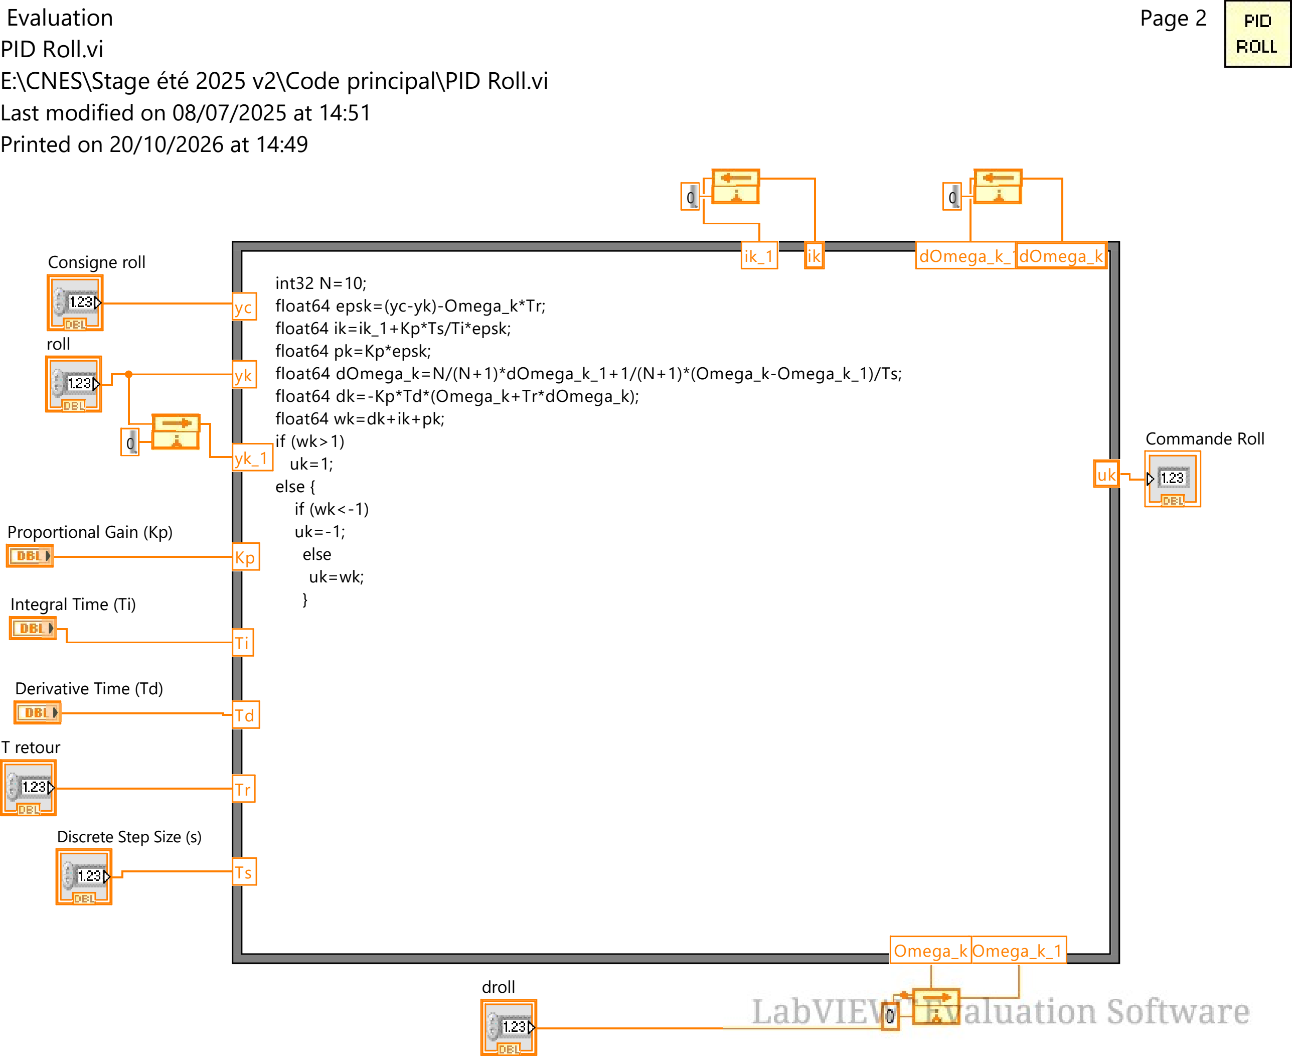
[picture p102: figure]
Evaluation PID Roll.vi; Last modified on 08/07/2025 at 14:51 Printed on 20/10/2026 at 14:49; Page 2; Consigne roll; roll; Discrete Step Size (s); droll; Commande Roll; Proportional Gain (Kp); Integral Time (Ti); Derivative Time (Td); T retour; int32 N=10; float64 epsk=(yc-yk)-Omega_k*Tr; float64 ik=ik_1+Kp*Ts/Ti*epsk; float64 pk=Kp*epsk; float64 dOmega_k=N/(N+1)*dOmega_k_1+1/(N+1)*(Omega_k-Omega_k_1)/Ts; float64 dk=-Kp*Td*(Omega_k+Tr*dOmega_k); float64 wk=dk+ik+pk; if (wk>1) uk=1; else { if (wk<-1) uk=-1; else uk=wk;; Omega_k Omega_k_1; dOmega_k_1dOmega_k

E:\CNES\Stage été 2025 v2\Code principal\PID Roll.vi
