Ahhj93/mini-apterros/docs/labview/Remise à zero moteurs.pdf

Evaluation
Remise a zero moteurs.vi
E:\CNES\Stage été 2025 v2\Code principal\Remise a zero moteurs.vi Last modified on 21/10/2025 at 17:24
Printed on 20/10/2026 at 14:47

Page 1

Error In | Error Out

Remise a zero moteurs.vi

0

code

source

status

Error In

0

code

source

status

Error Out

Error In
<B>error in</B> can accept error information wired from VIs previously called. Use this information to decide if any functionality should be bypassed in the event of errors from other VIs.

Right-click the <B>error in</B> control on the front panel and select <B>Explain Error</B> or <B>Explain Warning</B> from the shortcut menu for more information about the error.
status
code
source
Error Out
<B>error out</B> passes error or warning information out of a VI to be used by other VIs.

Right-click the <B>error out</B> indicator on the front panel and select <B>Explain Error</B> or <B>Explain Warning</B> from the shortcut menu for more information about the error.
status
code
source

0,05
50 0,05
50 0,05
50 0,05
50 0,05
50

Error In

Error Out
