Ahhj93/mini-apterros/docs/labview/Reset MyRio.pdf

Evaluation
Reset MyRio.vi
E:\CNES\Stage été 2025 v2\Code principal\Reset MyRio.vi Last modified on 28/03/2025 at 16:15
Printed on 20/10/2026 at 14:46

Page 1

Reset MyRio.vi

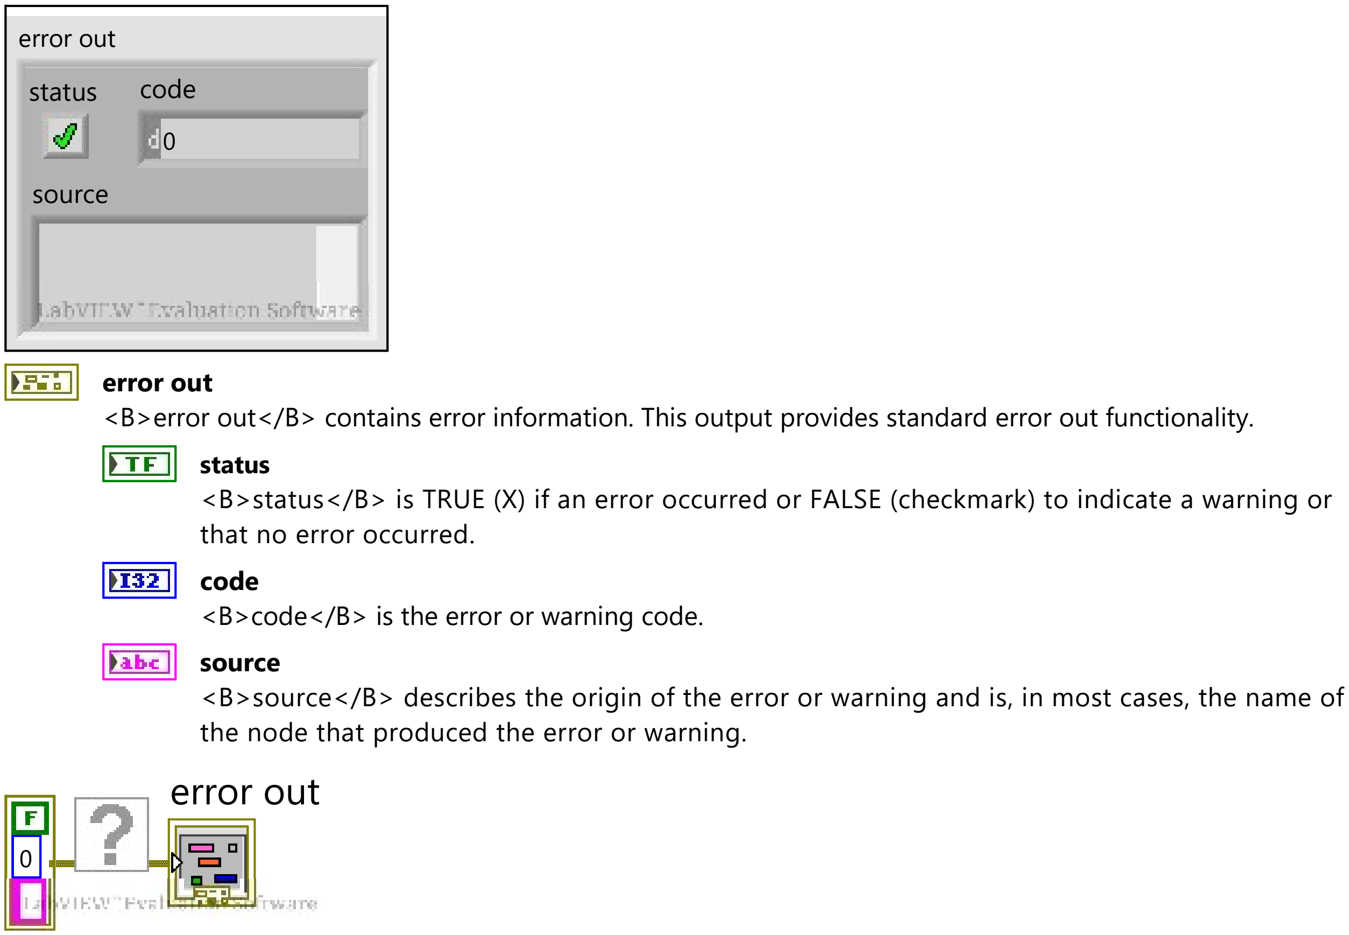
[picture p105: figure]
status; code; source; error out; that no error occurred. code

<B>error out</B> contains error information. This output provides standard error out functionality.

<B>status</B> is TRUE (X) if an error occurred or FALSE (checkmark) to indicate a warning or

<B>code</B> is the error or warning code.

<B>source</B> describes the origin of the error or warning and is, in most cases, the name of the node that produced the error or warning.
