Ahhj93/mini-apterros/docs/labview/table contrôle.pdf

Evaluation | Page 1
Table controle - Copie.vi
E:\CNES\Stage été 2025 v2\Code principal\Table controle - Copie.vi
Last modified on 01/04/2025 at 14:10
Printed on 20/10/2026 at 15:03
Table controle - Copie.vi

Printed on 20/10/2026 at 15:03

Page 2

Printed on 20/10/2026 at 15:03

Page 3

Printed on 20/10/2026 at 15:03

Page 4

Printed on 20/10/2026 at 15:03

Page 5

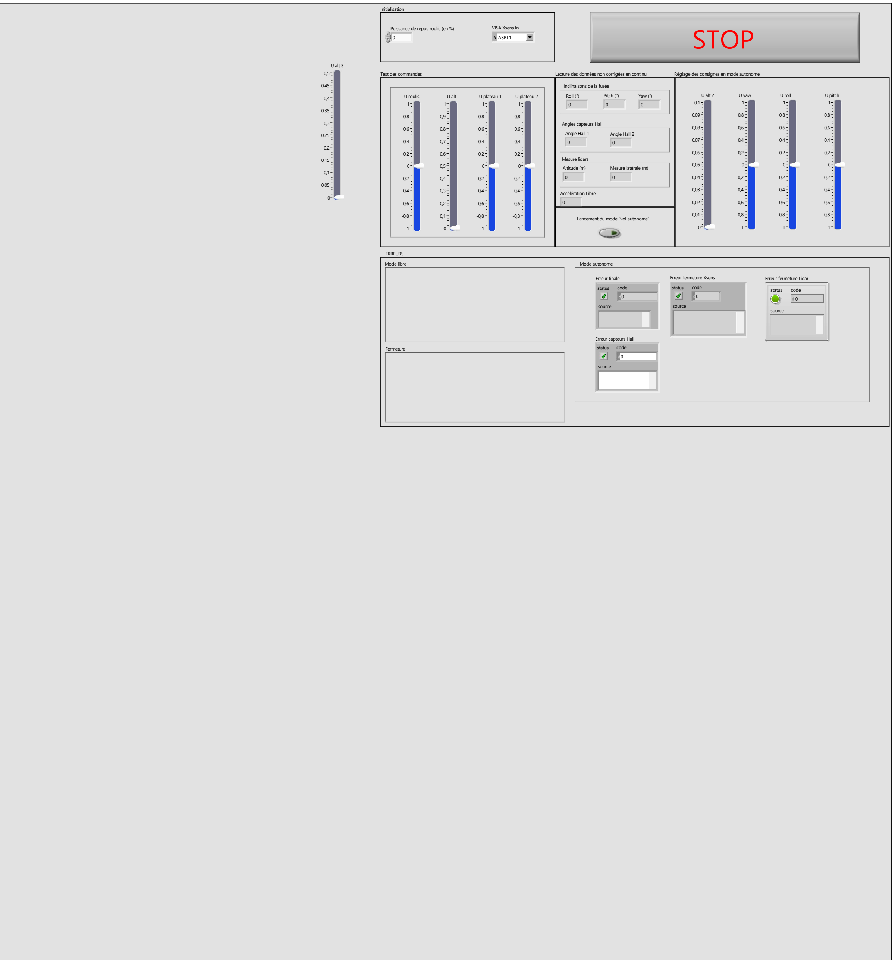
[picture p106: figure]
ASRL1:; VISA Xsens In; Roll (°); Pitch (°); Yaw (°); Puissance de repos roulis (en %); Initialisation; Test des commandes; U plateau 1; U alt; U roulis; U plateau 2; Inclinaisons de la fusée; Angles capteurs Hall; Lancement du mode "vol autonome"; Réglage des consignes en mode autonome; status; code; source; Erreur finale; Altitude (m); Mesure latérale (m); Mesure lidars; ERREURS; Mode libre; Mode autonome; Fermeture; STOP; Angle Hall 1; Angle Hall 2; Erreur fermeture Xsens; Erreur fermeture Lidar; U pitch; U yaw; U alt 2; U roll; Erreur capteurs Hall; Accélération Libre; U alt 3

Lecture des données non corrigées en continu

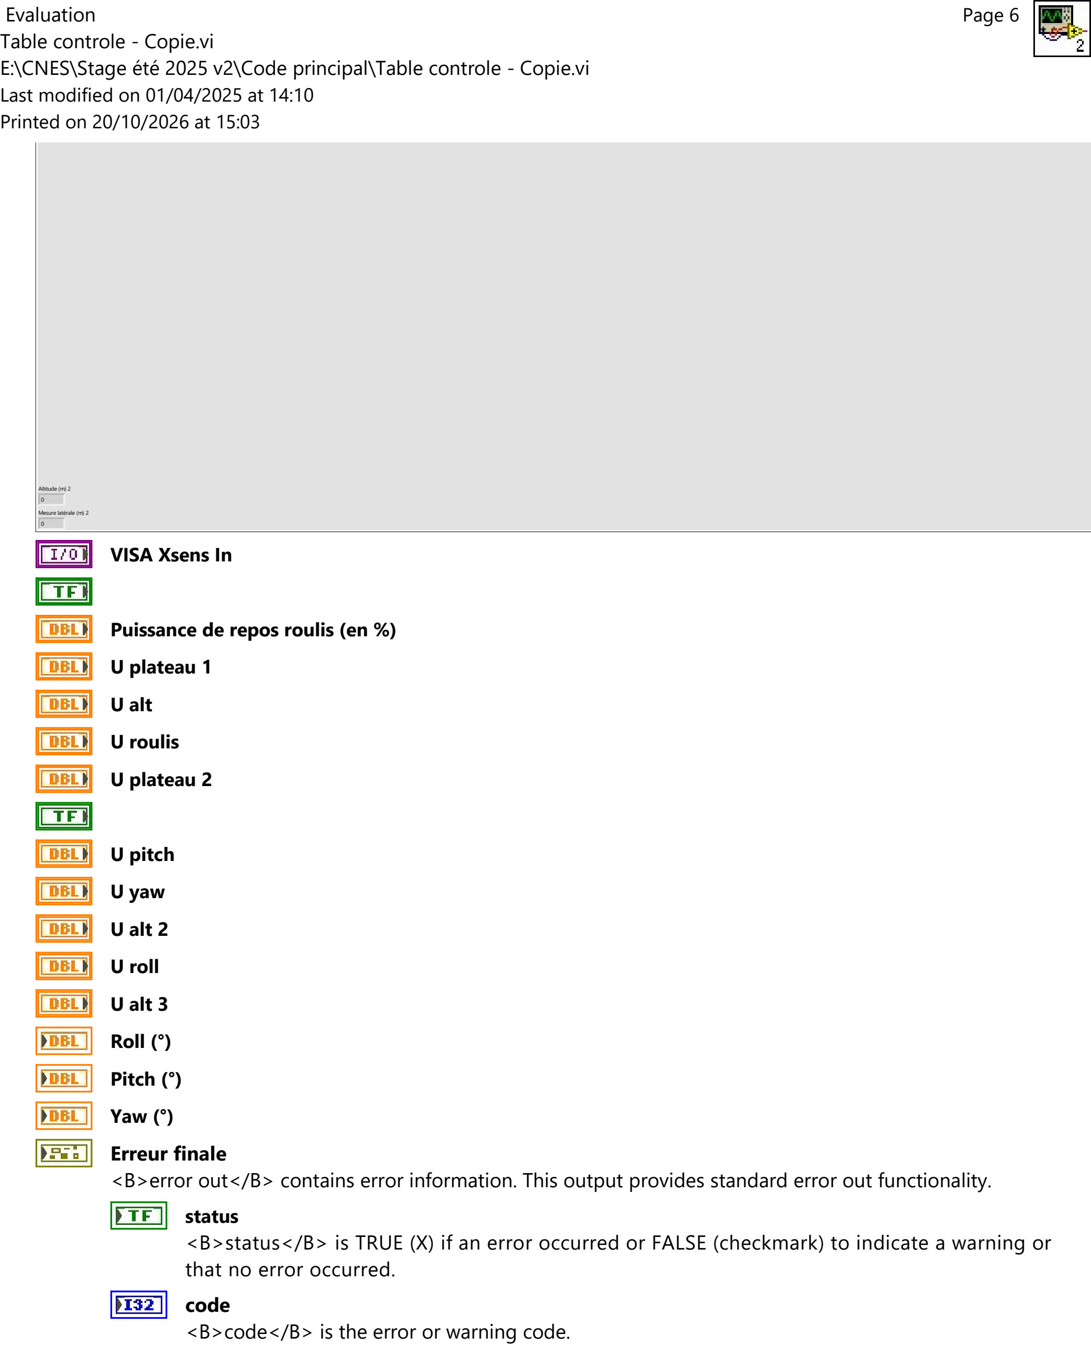
[picture p107: figure]
Printed on 20/10/2026 at 15:03; Page 6; Mesure latérale (m) 2; Altitude (m) 2; VISA Xsens In; Puissance de repos roulis (en %); U plateau 1; U alt; U roulis; U plateau 2; U pitch; U yaw; U alt 2; U roll; U alt 3; Roll (°); Pitch (°); Yaw (°) Erreur finale; status; that no error occurred. code

<B>error out</B> contains error information. This output provides standard error out functionality.

<B>status</B> is TRUE (X) if an error occurred or FALSE (checkmark) to indicate a warning or

<B>code</B> is the error or warning code.

Printed on 20/10/2026 at 15:03

Page 7

Printed on 20/10/2026 at 15:03

Page 8

Printed on 20/10/2026 at 15:03

Page 9

Printed on 20/10/2026 at 15:03

Page 10

Printed on 20/10/2026 at 15:03

Page 11

source
<B>source</B> describes the origin of the error or warning and is, in most cases, the name of the node that produced the error or warning.
Altitude (m)
Mesure latérale (m)
Angle Hall 1
Angle Hall 2
Erreur fermeture Xsens
<B>error out</B> passes error or warning information out of a VI to be used by other VIs.

Right-click the <B>error out</B> control on the front panel and select <B>Explain Error</B> or <B>Explain Warning</B> from the shortcut menu for more information about the error. status
<B>status</B> is TRUE (X) if an error occurred or FALSE (checkmark) to indicate a warning or that no error occurred.

Right-click the <B>error out</B> control on the front panel and select <B>Explain Error</B> or <B>Explain Warning</B> from the shortcut menu for more information about the error.

code
<B>code</B> is the error or warning code.

Right-click the <B>error out</B> control on the front panel and select <B>Explain Error</B> or <B>Explain Warning</B> from the shortcut menu for more information about the error.

source
<B>source</B> describes the origin of the error or warning.

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

error out[Erreur fermeture Lidar]
<B>error out</B> passes error or warning information out of a VI to be used by other VIs.

Right-click the <B>error out</B> indicator on the front panel and select <B>Explain Error</B> or <B>Explain Warning</B> from the shortcut menu for more information about the error.
status
code
source

Printed on 20/10/2026 at 15:03

Page 12

Erreur capteurs Hall
<B>error in</B> can accept error information wired from VIs previously called. Use this information to decide if any functionality should be bypassed in the event of errors from other VIs.

Right-click the <B>error in</B> control on the front panel and select <B>Explain Error</B> or <B>Explain Warning</B> from the shortcut menu for more information about the error.
status
<B>status</B> is TRUE (X) if an error occurred or FALSE (checkmark) to indicate a warning or that no error occurred.

Right-click the <B>error in</B> control on the front panel and select <B>Explain Error</B> or <B>Explain Warning</B> from the shortcut menu for more information about the error.
code
<B>code</B> is the error or warning code.

Right-click the <B>error in</B> control on the front panel and select <B>Explain Error</B> or <B>Explain Warning</B> from the shortcut menu for more information about the error. source
<B>source</B> describes the origin of the error or warning.

Right-click the <B>error in</B> control on the front panel and select <B>Explain Error</B> or <B>Explain Warning</B> from the shortcut menu for more information about the error. Accélération Libre
Mesure latérale (m) 2
Altitude (m) 2

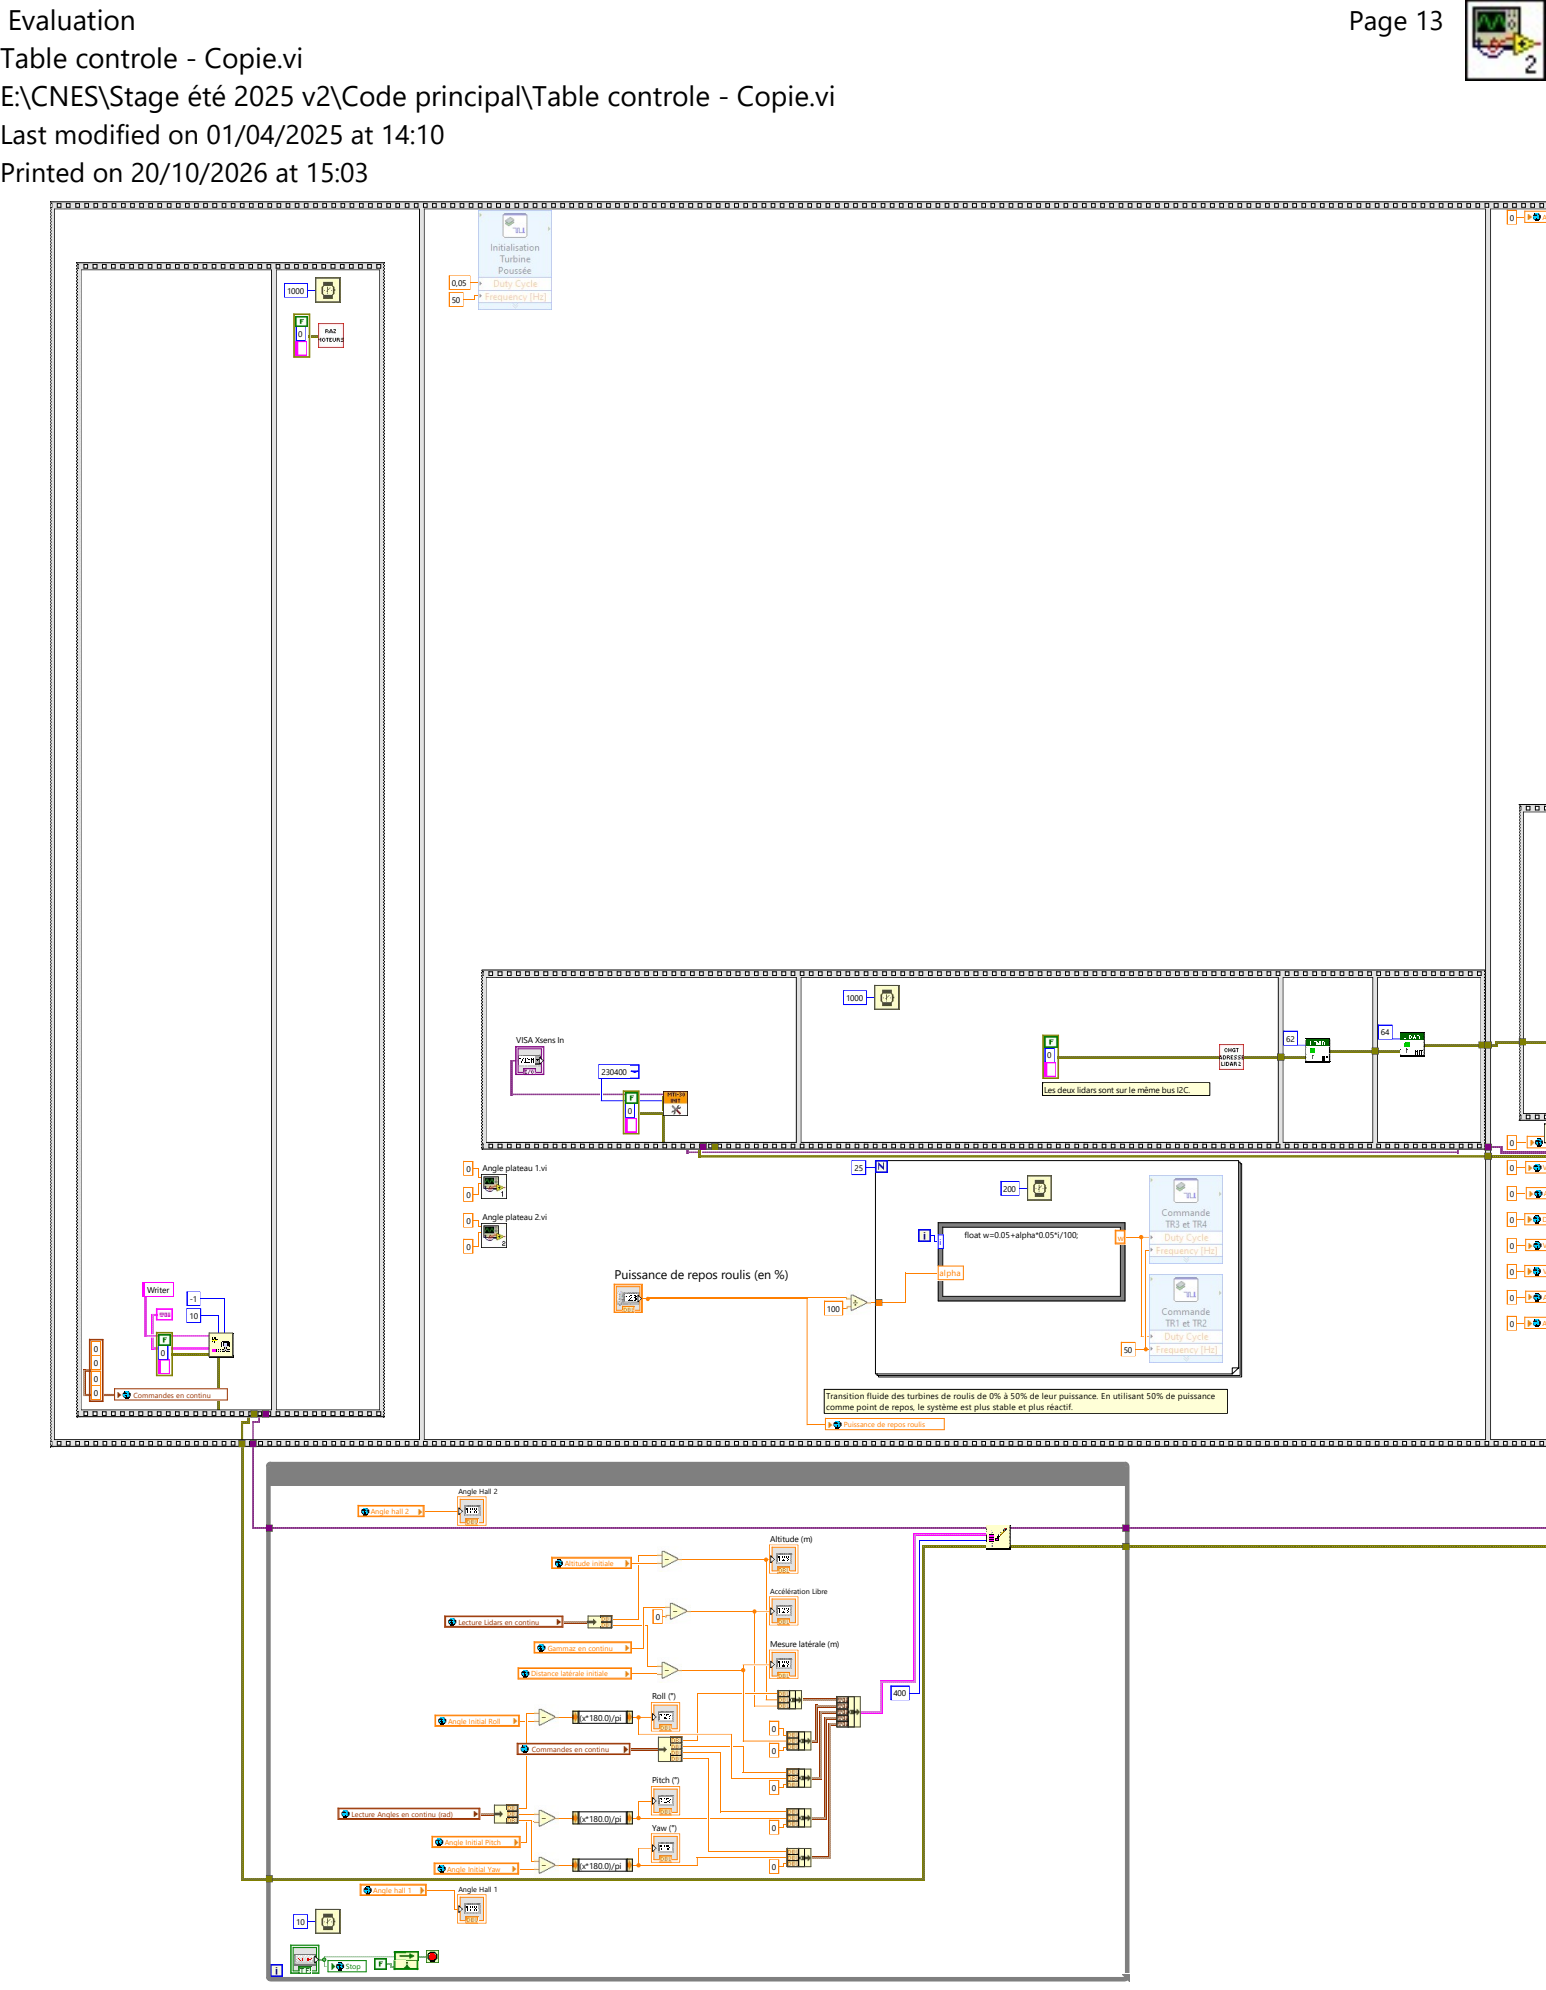
[picture p108: page 13]
Page 13; Writer; 0 Commandes en continu; float w=0.05+alpha*0.05*i/100;; alpha; Altitude initiale; Roll (°); Pitch (°); Yaw (°); Altitude (m); Mesure latérale (m); Stop; Angle hall 1; Angle hall 2; Angle Hall 1; Angle Hall 2; Accélération Libre

Printed on 20/10/2026 at 15:03

VISA Xsens In

Les deux lidars sont sur le même bus I2C.

Gammaz en continu

Angle plateau 1.vi

Vitesse Initiale Pitch

Angle Initial Pitch

Angle plateau 2.vi

Distance latérale initiale

Vitesse Initiale Yaw

Puissance de repos roulis (en %)

Vitesse Initiale Roll

Angle Initial Yaw

Angle Initial Roll

Transition fluide des turbines de roulis de 0% à 50% de leur puissance. En utilisant 50% de puissance
comme point de repos, le système est plus stable et plus réactif.
Puissance de repos roulis

Lecture Lidars en continu

Commandes en continu

Lecture Angles en continu (rad)

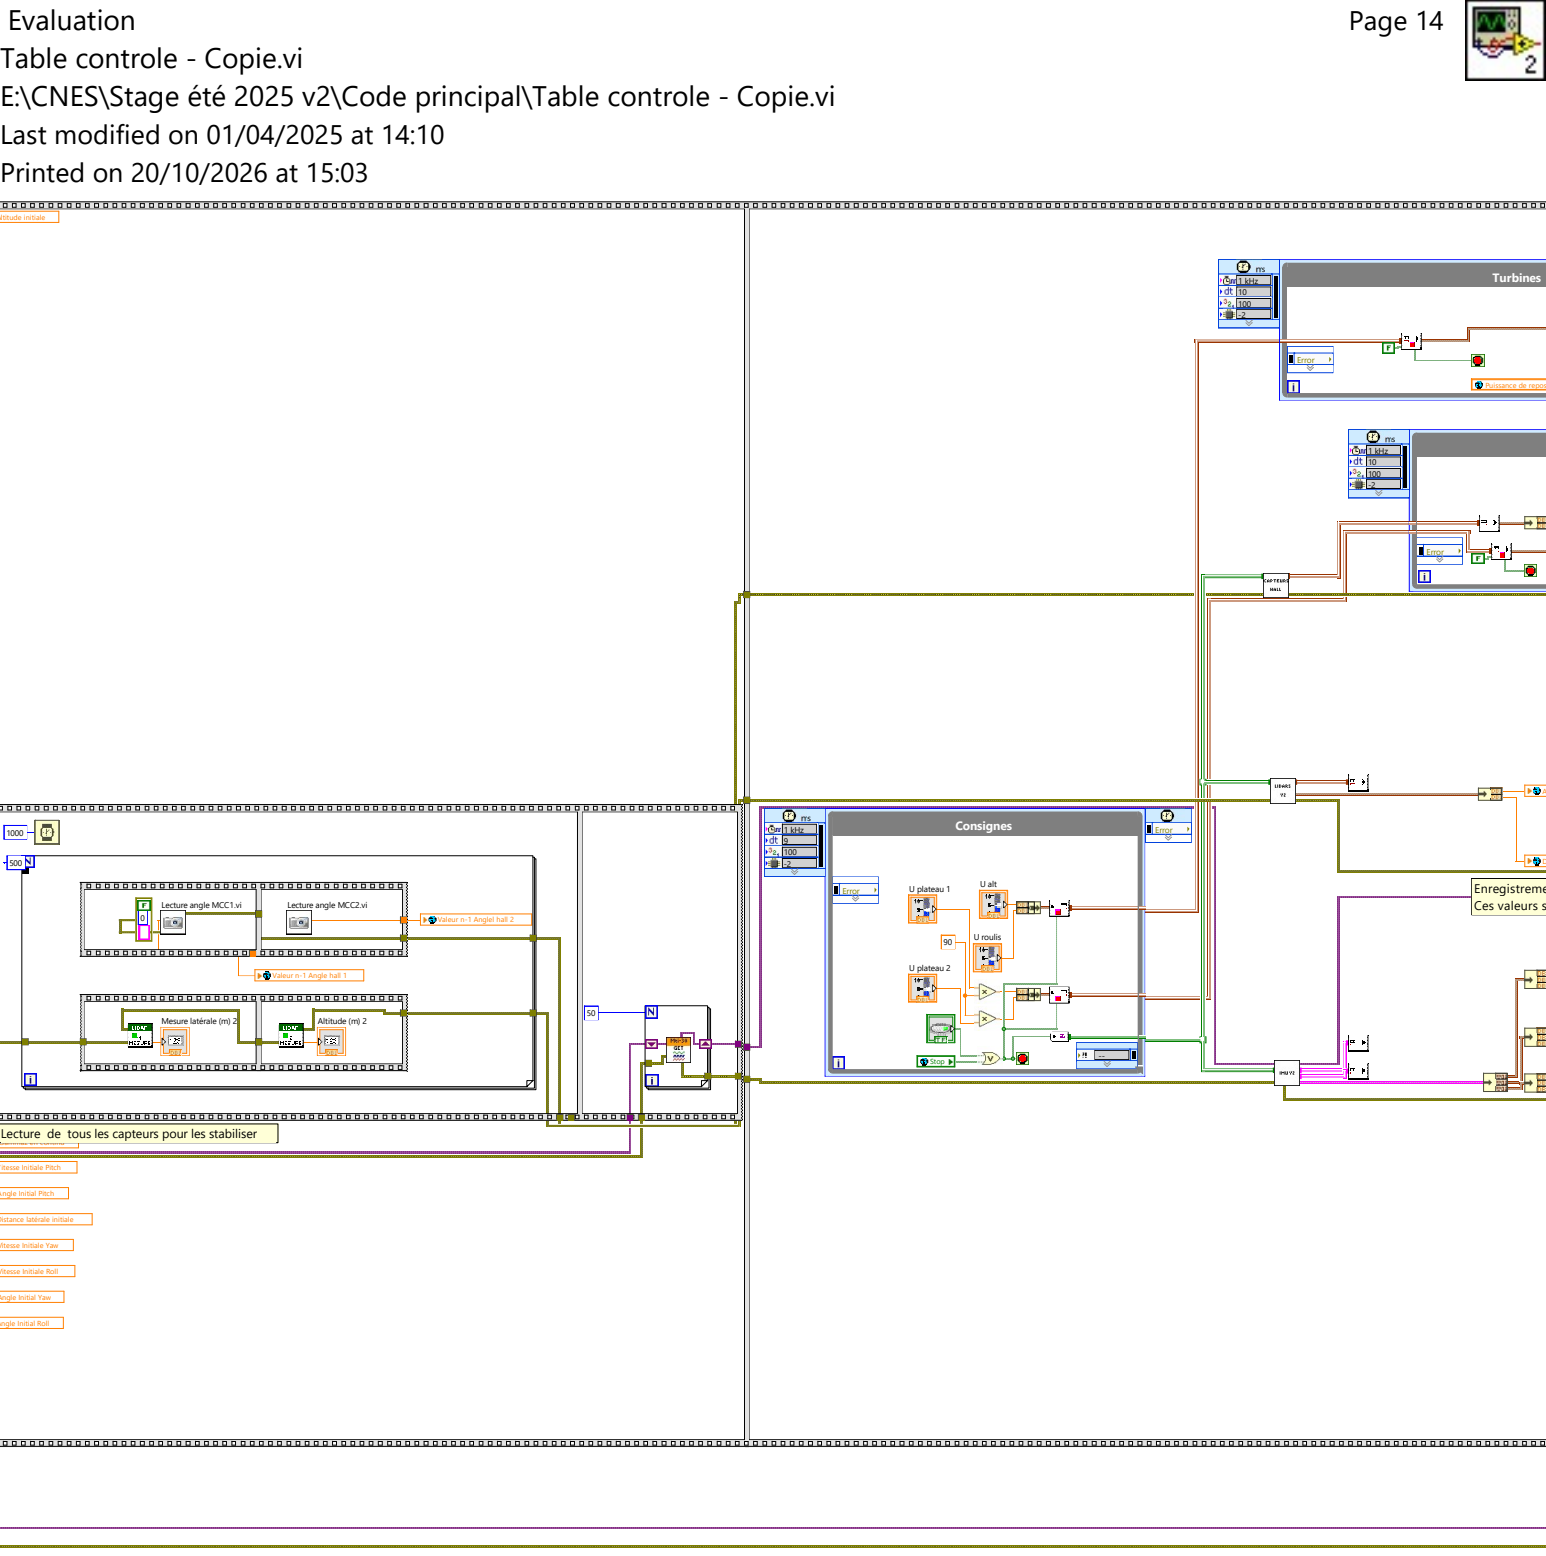
[picture p109: page 14]
Page 14; Mesure latérale (m) 2; Altitude (m) 2; Altitude initiale; ms 1 kHz 10 100 -2; Error; Turbines; ms 1 kHz 9 100 -2; Consignes; U plateau 1; U alt; U roulis; U plateau 2; Stop

Printed on 20/10/2026 at 15:03

Puissance de repos roulis

Distance latérale initiale

Lecture angle MCC1.vi

Lecture angle MCC2.vi

Enregistrement de toutes les valeurs au repos juste avant de quitter cette "frame"
Ces valeurs sont stockées dans des variables globales accessibles partout

Valeur n-1 Anglel hall 2

Valeur n-1 Angle hall 1

Lecture de tous les capteurs pour les stabiliser
Gammaz en continu

Vitesse Initiale Pitch

Angle Initial Pitch

Vitesse Initiale Yaw

Vitesse Initiale Roll

Angle Initial Yaw

Angle Initial Roll

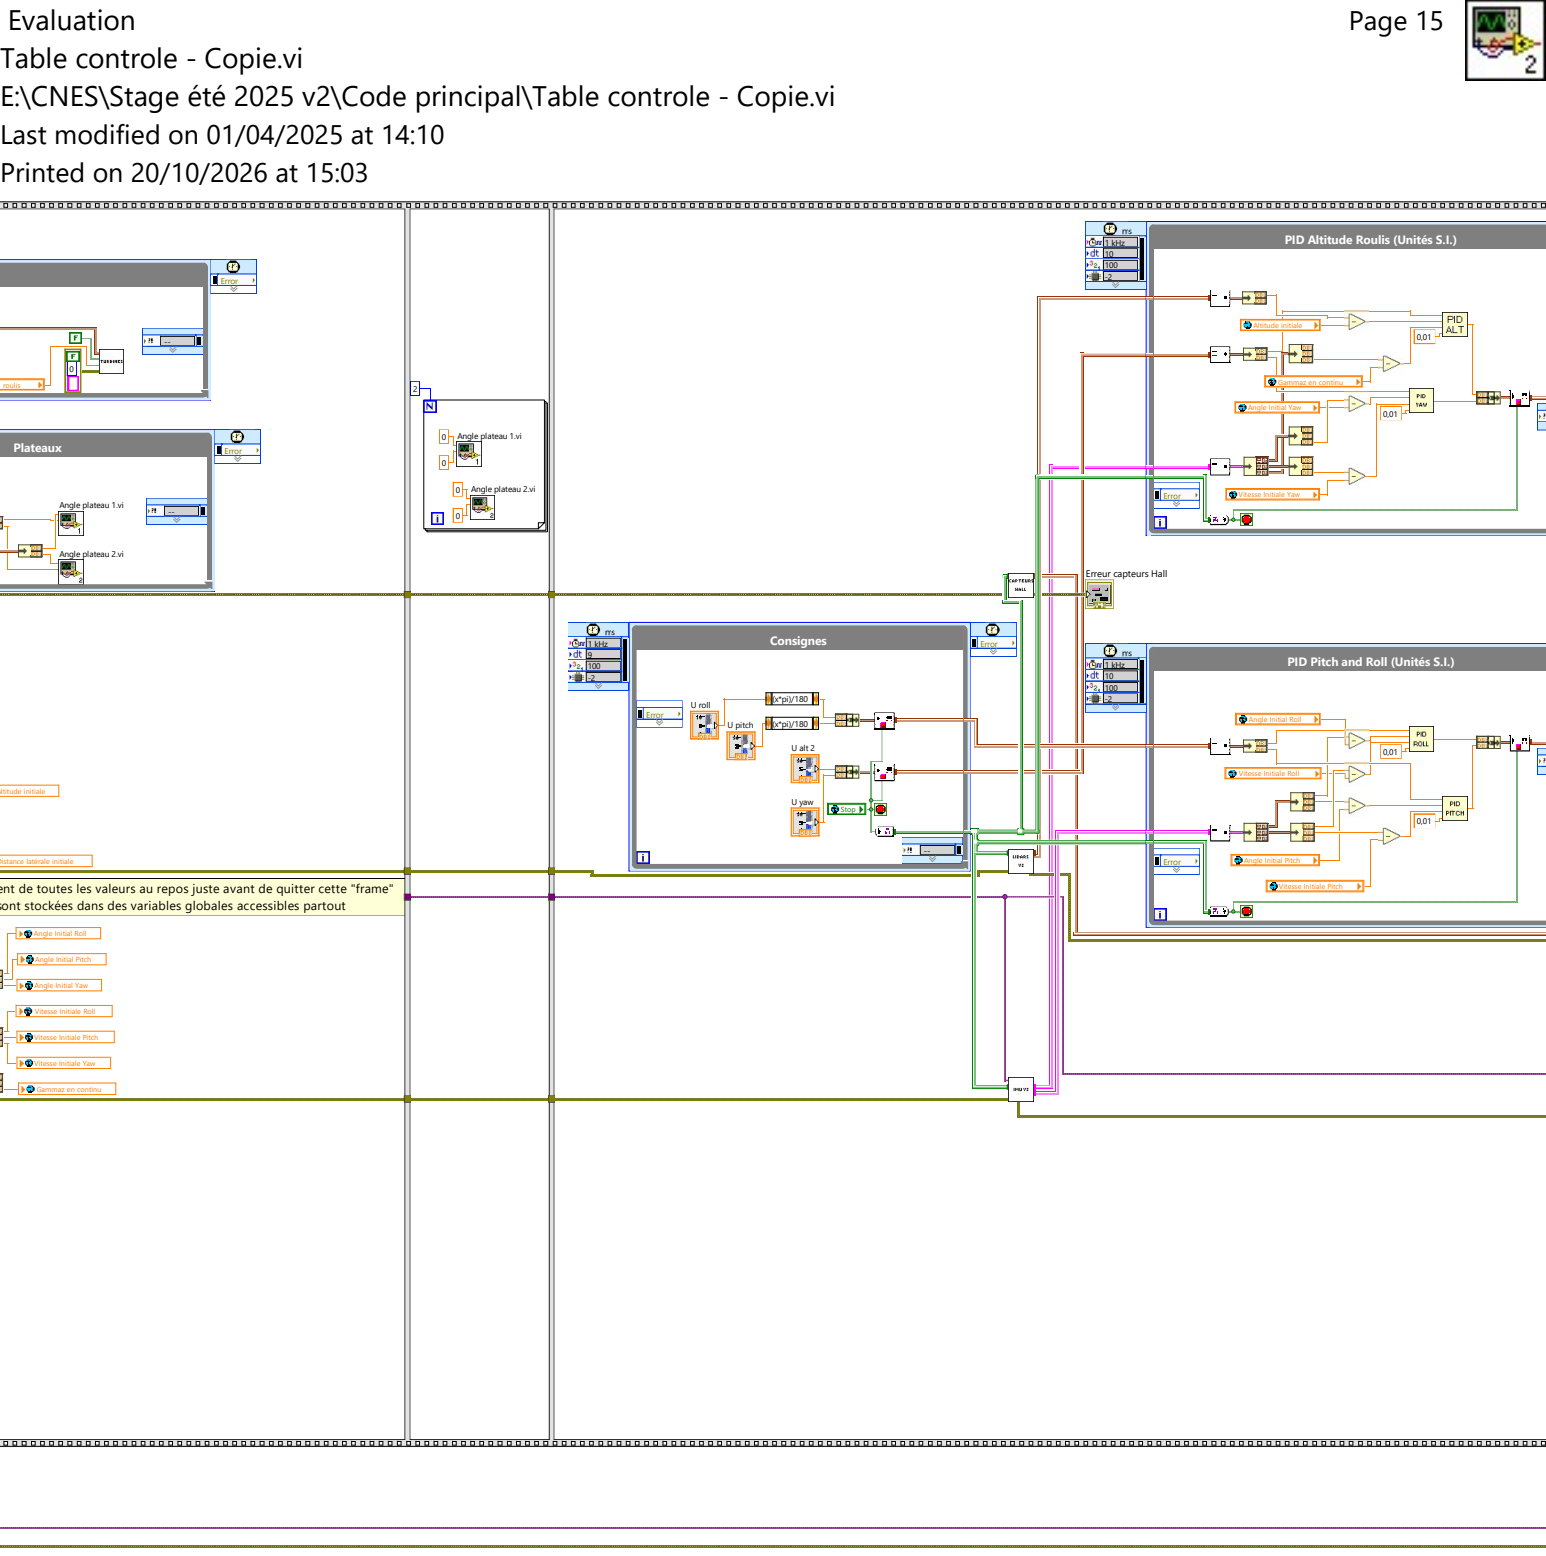
[picture p110: page 15]
Page 15; Altitude initiale; Plateaux; Error; ms 1 kHz 9 100 -2; Consignes; U roll; U alt 2; U yaw; U pitch; Stop; ms 1 kHz 10 100 -2

Printed on 20/10/2026 at 15:03

PID Altitude Roulis (Unités S.I.)

Gammaz en continu

Angle Initial Yaw | 0,01

0 Angle plateau 1.vi

0 Angle plateau 2.vi

Vitesse Initiale Yaw

Angle plateau 1.vi

Angle plateau 2.vi

Erreur capteurs Hall

PID Pitch and Roll (Unités S.I.)

Angle Initial Roll

Vitesse Initiale Roll

Distance latérale initiale

Angle Initial Pitch

Enregistrement de toutes les valeurs au repos juste avant de quitter cette "frame"
Ces valeurs sont stockées dans des variables globales accessibles partout

Vitesse Initiale Pitch

Angle Initial Yaw

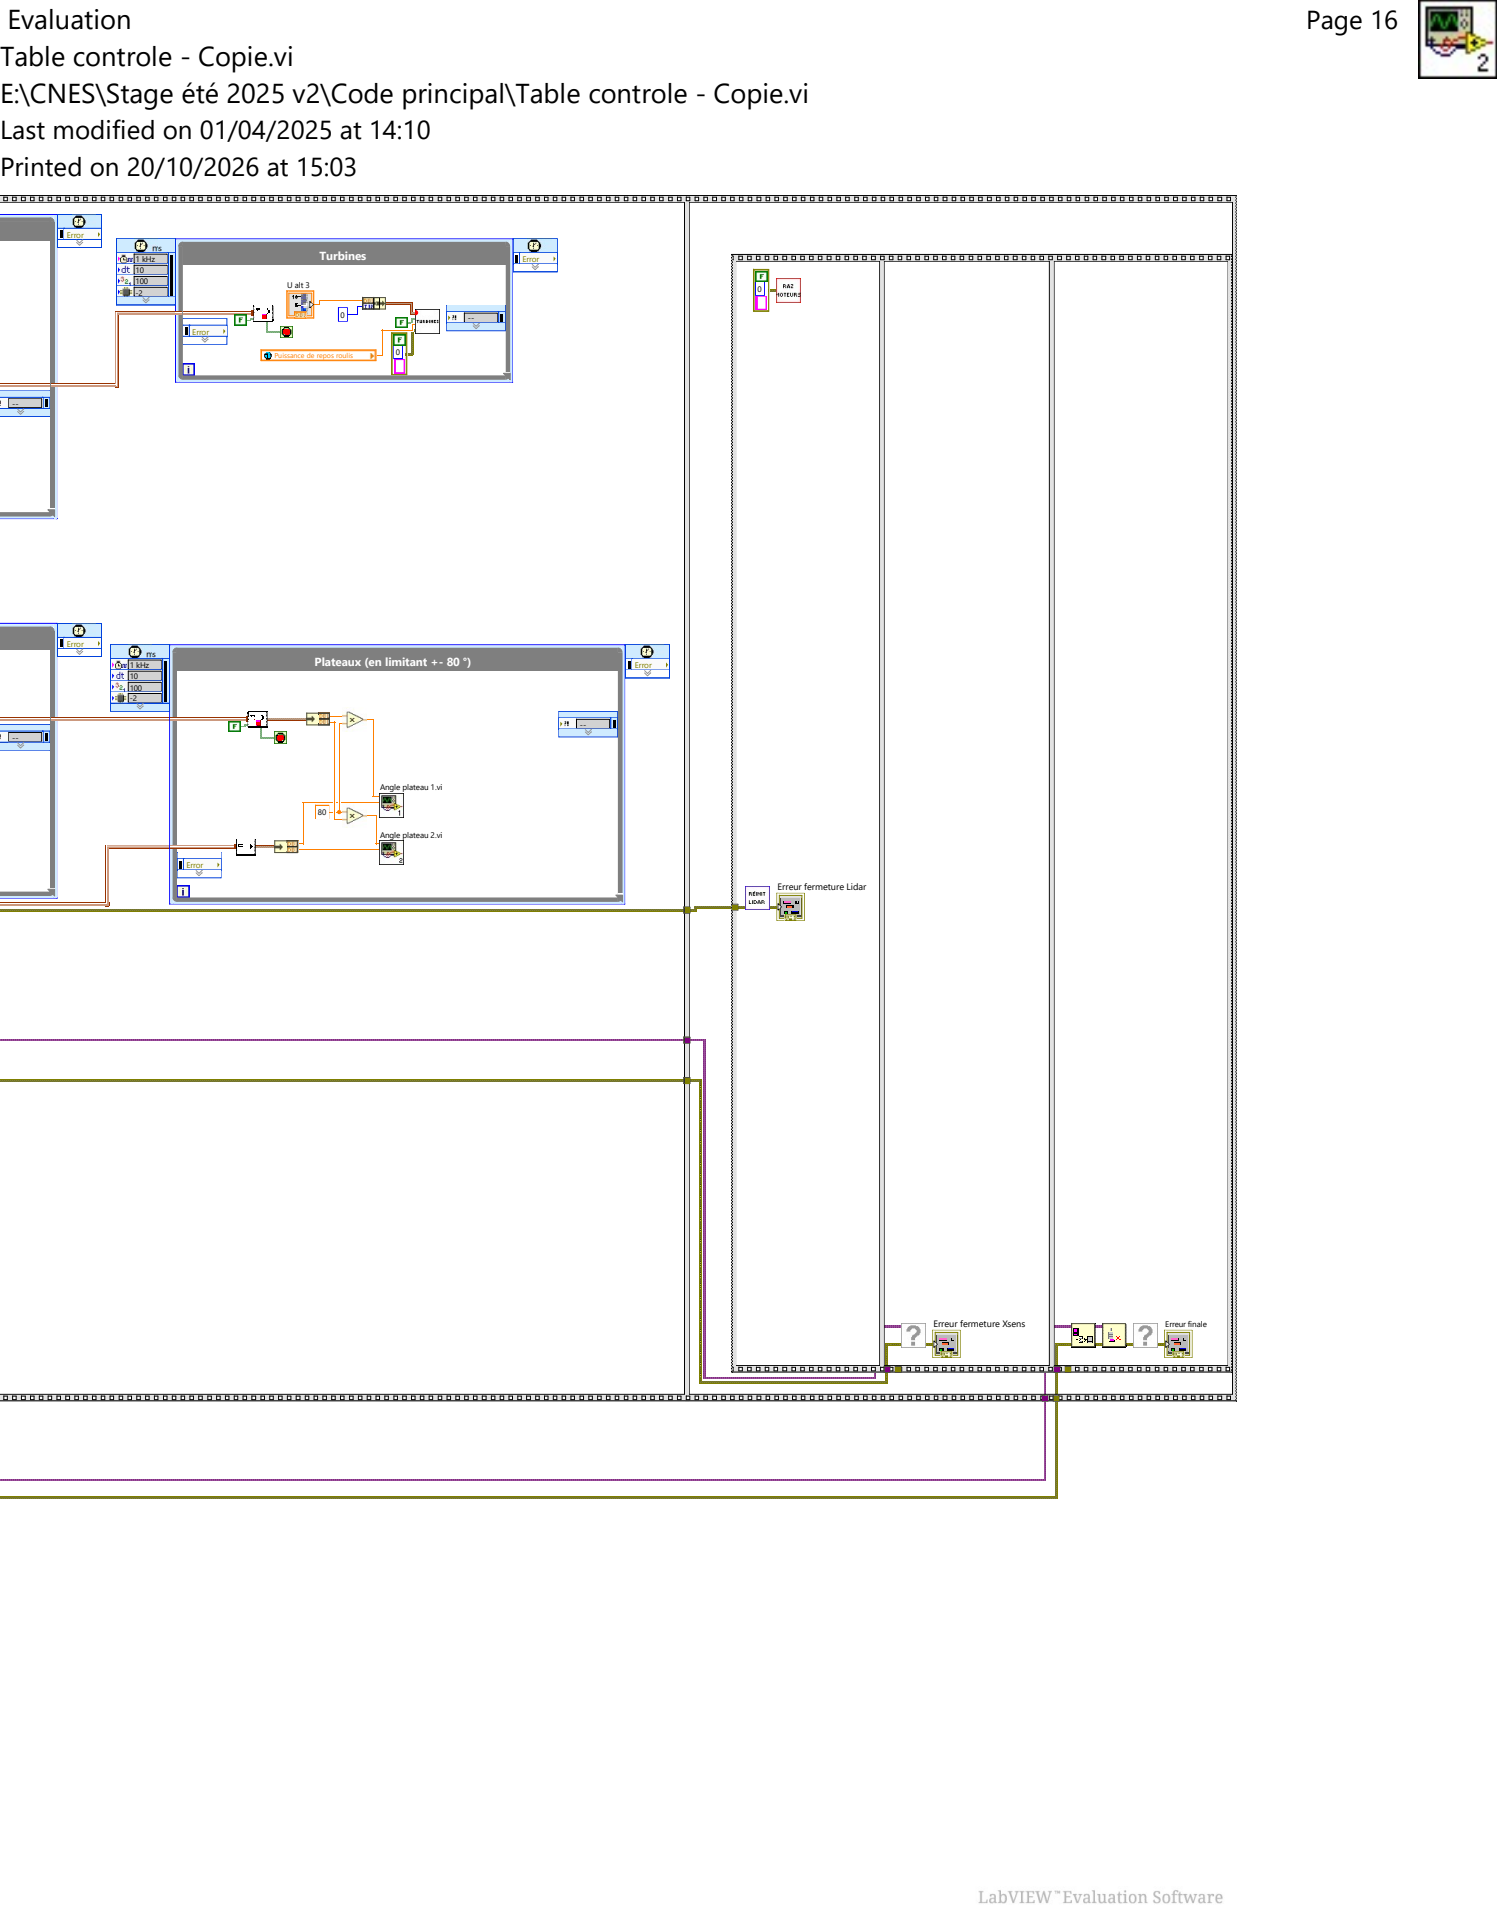
[picture p111: page 16]
Page 16; Error; Erreur fermeture Xsens; Erreur finale

Printed on 20/10/2026 at 15:03

ms ms
1 kHz | Turbines U alt 3 | Error

0 Puissance de repos roulis

1 kHz | Plateaux (en limitant +- 80 °) | Error

Angle plateau 1.vi

Angle plateau 2.vi

Erreur fermeture Lidar

Printed on 20/10/2026 at 15:03

Page 17
