Ahhj93/mini-apterros/docs/labview/Table observation.pdf

Evaluation
Table observation.vi
E:\CNES\Stage été 2025 v2\Code principal\Table observation.vi Last modified on 18/06/2025 at 10:51
Printed on 20/10/2026 at 14:44

Page 1

Table observation.vi

0

code

source

status

error out

2

-2

-1

0

1

Time

0 1000

Altitude Correction

Yaw Correction

Roll

0,5

-0,01

0,1

0,2

0,3

0,4

Time

-1 | 1

Consigne
Altitude
Accélération verticale
Altitude (commande, mesure, accélération)

0

code

source

status

Error Initialisation

1,2

-1,2

-1

-0,75

-0,5

-0,25

0

0,25

0,5

0,75

1

Time

0 1000

Altitude Correction

Yaw Correction

Distance latérale

2

-2

-1

0

1

Time

0 1000

Altitude Correction

Yaw Correction

Pitch

20

-20

-10

0

10

Time

0 1000

Yaw Correction
Altitude Correction Yaw

error out
<B>error out</B> passes error or warning information out of a VI to be used by other VIs.

Right-click the <B>error out</B> indicator on the front panel and select <B>Explain Error</B> or <B>Explain Warning</B> from the shortcut menu for more information about the error.
status
code
source
Roll
Altitude (commande, mesure, accélération)
Error Initialisation
<B>error out</B> passes error or warning information out of a VI to be used by other VIs.

Right-click the <B>error out</B> indicator on the front panel and select <B>Explain Error</B> or <B>Explain Warning</B> from the shortcut menu for more information about the error.

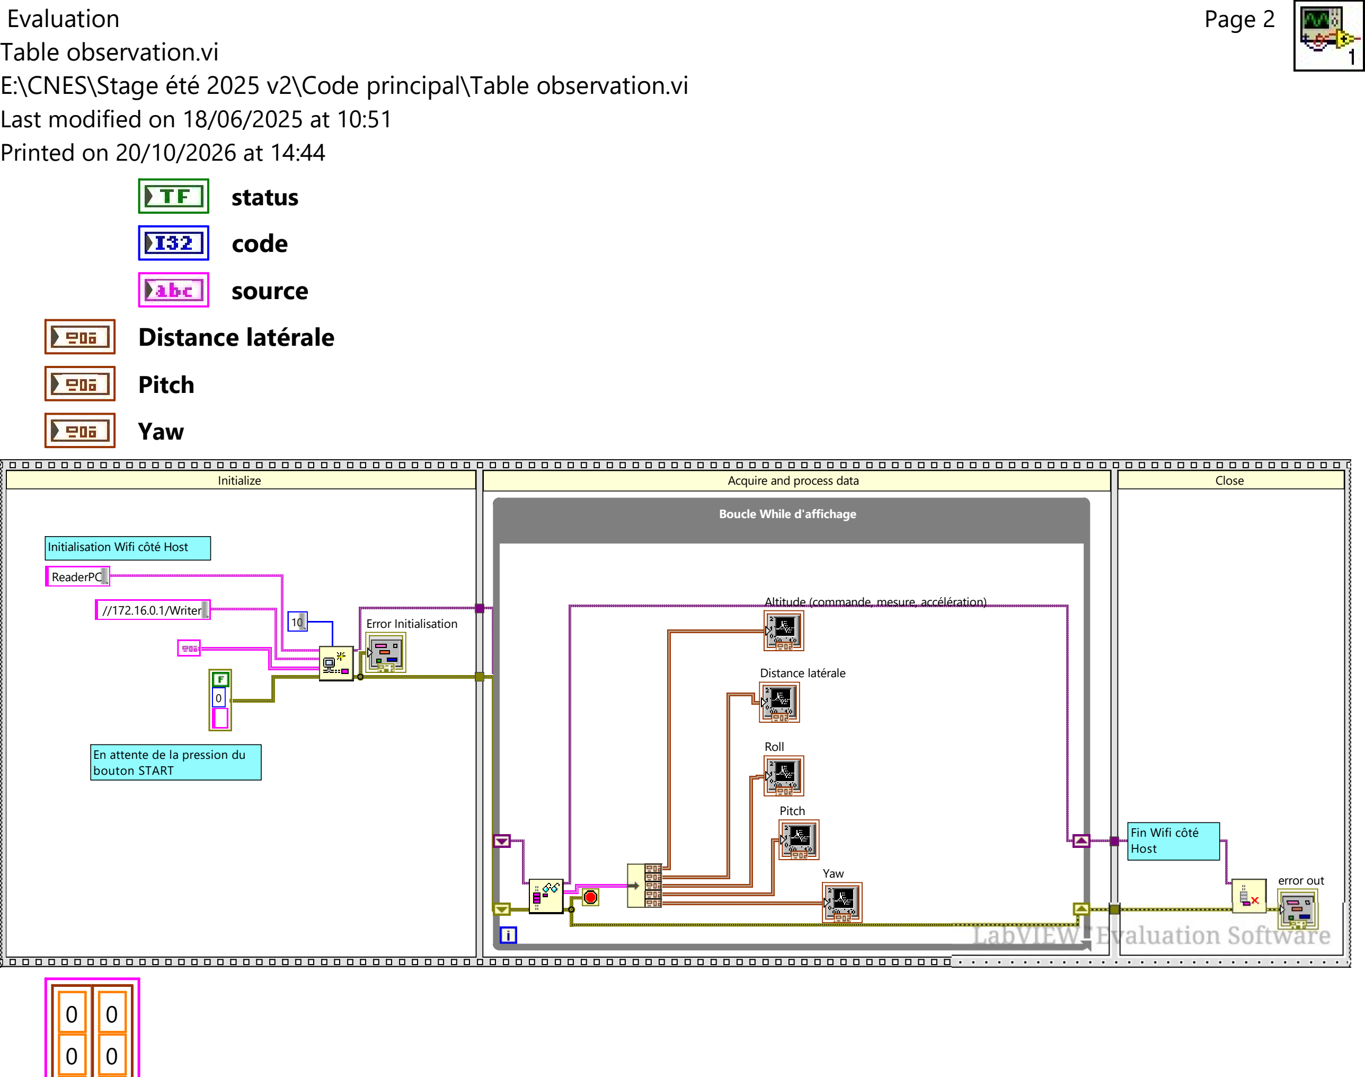
[picture p112: figure]
Evaluation Table observation.vi; Last modified on 18/06/2025 at 10:51 Printed on 20/10/2026 at 14:44; Page 2; status code source Distance latérale; Pitch; Yaw; Initialize; Initialisation Wifi côté Host; En attente de la pression du bouton START; ReaderPC; //172.16.0.1/Writer; 10 Error Initialisation; Acquire and process data; Boucle While d'affichage; Roll; Altitude (commande, mesure, accélération); Distance latérale; Close; error out; Fin Wifi côté Host

E:\CNES\Stage été 2025 v2\Code principal\Table observation.vi

0 | 0
0 | 0
0 | 0
0 | 0

0

0

0
