Ahhj93/mini-apterros/docs/labview/VI Moteur CC v2.pdf

# Evaluation VI Moteur CC v2.vi E:\CNES\Stage été 2025 v2\Code principal\VI Moteur CC v2.vi

# Last modified on 13/06/2025 at 09:03 Printed on 20/10/2026 at 14:29

# Page 1

# Angle de rotation en degrÃ©

Vitessee de rotation en deg...

# Correction Discrete Step Size (s)

# Theta Plateau (rd)

# Consigne

# VI Moteur CC v2.vi

0,03

# Constante de temps moteur 2

0

# Angle de rotation en degrÃ©

60

-60

-25

0

25

# Consigne

0 | 0,05 | 0,1 | 0,15 | 0,2

0,02

# Derivative Time (Td)

0 | 2 | 4 | 6 | 8 | 10 12 14 16 18 20

50000

# Integral Time (Ti)

0 | 0,02 | 0,04 | 0,06 | 0,08 | 0,1

0,02

# Proportional Gain (Kp)

0

# Correction

0,01

# Discrete Step Size (s)

# Kp doit être inférieur à 0,05 sinon le PID sature en sortie (Essayer 0,01 ou O,025 dans l'asservissement de tangage) soit 2x plus ou 2x moins

0

# Vitessee de rotation en degrÃ© par seconde

0

# Theta Plateau (rd)

# Constante de temps moteur 2

# Consigne

# Derivative Time (Td)

<B>Derivative Gain (Kd)</B> is the controller parameter that adjusts the effect of the error derivative term sE(s) on the controller output U(s).

# Integral Time (Ti)

<B>Integral Gain (Ki)</B> is the controller parameter that adjusts the effect of the error integral term E(s)/s on the controller output U(s).

# Proportional Gain (Kp)

<B>Proportional Gain (Kc)</B> represents the proportional gain of the controller.

# Discrete Step Size (s)

# Theta Plateau (rd)

# Evaluation VI Moteur CC v2.vi E:\CNES\Stage été 2025 v2\Code principal\VI Moteur CC v2.vi

# Last modified on 13/06/2025 at 09:03 Printed on 20/10/2026 at 14:29

# Page 2

# Angle de rotation en degrÃ©

# Correction

# Vitessee de rotation en degrÃ© par seconde

Discrete Step Size (s)

Correction

Proportional Gain (Kp)

Integral Time (Ti)

Derivative Time (Td)

Consigne

Angle de rotation en degrÃ©

Constante de temps moteur 2

1
0,001

Bruit
0

// K1 : vitesse max en degrÃ© par seconde pour u = 1
// K1 = 340 avec le moteur 2023
// K1 = 660 colle avec 400Â°/s en B.F. colle avec mesure B.F. FÃ©vrier 2025
// Cette vitesse est selon le constructeur entre 340 et 660 selon le couple
// La limitation du courant et du couple max entrainent une limitation de la dÃ©rivÃ©e seconde de Omega // En fait le couple rÃ©sistant augment avec l'angle du plateau omegai=(T/Ts)/(1+T/Ts)*omegai_1+K1/(1+T/Ts)*ui_1*(1-0.08*sin(thetaP)/sin(3.3*pi/180)); thetai=thetai_1+Ts*omegai;

thetaP

T

thetai

omegai

ui_1

K1
Ts

omegai_1

thetai_1

660

0

0 | 0

Vitessee de rotation en degrÃ© par seconde

0

0

int N=0;
float epsk=yc-yk;
float pk=K*epsk;
ik=ik_1+K*(Ts/Ti)*epsk;
dyk=N/(N+1)*dyk_1+1/(N+1)*(yk-yk_1)/Ts; float dk=-K*Td*dyk;
float wk=(pk+ik+dk);
if (wk>1)
uk=1;
else if (wk<-1)
uk=-1;
else
uk=wk;

yc

yk

yk_1
Ti

K
Td | Ts | dyk_1 | dyk

uk

ik_1 ik

Theta Plateau (rd)
