Ahhj93/mini-apterros/docs/labview/Vitesse MCC 1.pdf

Evaluation
Vitesse MCC 1.vi
E:\CNES\Stage été 2025 v2\Code principal\Vitesse MCC 1.vi Last modified on 21/10/2025 at 17:24
Printed on 20/10/2026 at 14:29

Page 1

Vitesse MCC 1.vi

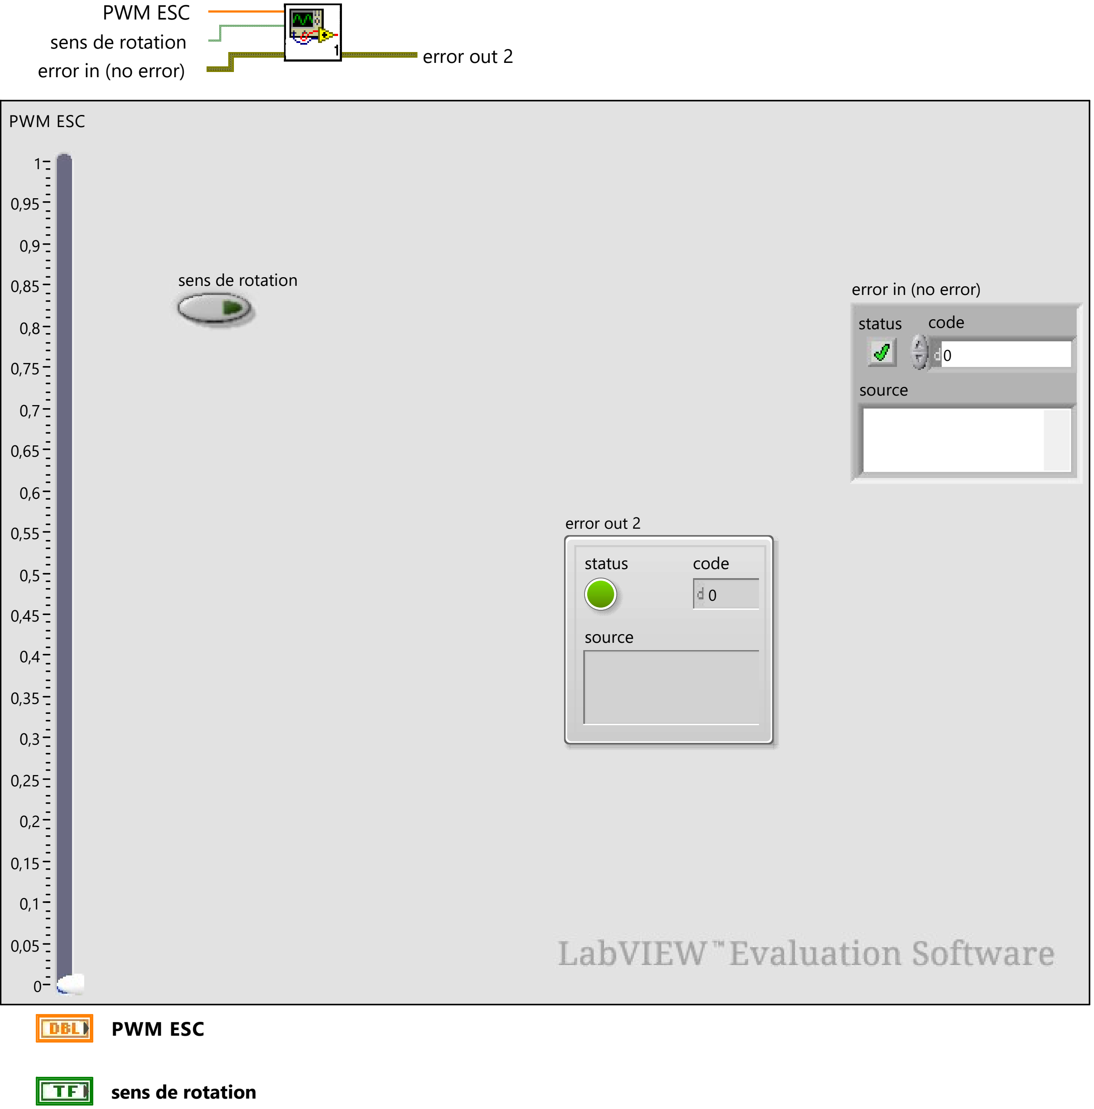
[picture p113: figure]
error out 2; error in (no error); sens de rotation; PWM ESC; code; source; status

Evaluation
Vitesse MCC 1.vi
E:\CNES\Stage été 2025 v2\Code principal\Vitesse MCC 1.vi Last modified on 21/10/2025 at 17:24
Printed on 20/10/2026 at 14:29

Page 2

error in (no error)
<B>error in</B> can accept error information wired from VIs previously called. Use this information to decide if any functionality should be bypassed in the event of errors from other VIs.

Right-click the <B>error in</B> control on the front panel and select <B>Explain Error</B> or <B>Explain Warning</B> from the shortcut menu for more information about the error.
status
<B>status</B> is TRUE (X) if an error occurred or FALSE (checkmark) to indicate a warning or that no error occurred.

Right-click the <B>error in</B> control on the front panel and select <B>Explain Error</B> or <B>Explain Warning</B> from the shortcut menu for more information about the error.
code
<B>code</B> is the error or warning code.

Right-click the <B>error in</B> control on the front panel and select <B>Explain Error</B> or <B>Explain Warning</B> from the shortcut menu for more information about the error. source
<B>source</B> describes the origin of the error or warning.

Right-click the <B>error in</B> control on the front panel and select <B>Explain Error</B> or <B>Explain Warning</B> from the shortcut menu for more information about the error. error out 2
<B>error in</B> can accept error information wired from VIs previously called. Use this information to decide if any functionality should be bypassed in the event of errors from other VIs.

Right-click the <B>error in</B> control on the front panel and select <B>Explain Error</B> or <B>Explain Warning</B> from the shortcut menu for more information about the error.
status
code
source

PWM ESC

error out 2

sens de rotation

error in (no error)

0

if (abs(commande)<0.025)
float64 pwm=0;
else
pwm=alpha+abs(commande)*(1-alpha); | pwm

commande

alpha

0,6
15000
