Ahhj93/mini-apterros/src/README.md

Ce dossier contient les fichiers sources du projet Mini-Apterros.
