Ahhj93/mini-apterros/docs/labview/Lecture angle MCC 1.pdf

Evaluation
Lecture angle MCC1.vi
E:\CNES\Stage été 2025 v2\Code principal\Lecture angle MCC1.vi Last modified on 21/10/2025 at 17:23
Printed on 20/10/2026 at 14:55

Page 1

error out
Angle en degrés en sortie d... Angle en tours aimant error in (no error)

Lecture angle MCC1.vi

0

status code

0

Angle sur 14 bits (/16384)

0

Angle en tours aimant

0

0xFE

0

0xFF

0

Angle en degrés en sortie du réducteur

status
0

code

source

error in (no error)

0

Angle mesure entre 0 et 16384

error in (no error)
<B>error in</B> can accept error information wired from VIs previously called. Use this information to decide if any functionality should be bypassed in the event of errors from other VIs.

Right-click the <B>error in</B> control on the front panel and select <B>Explain Error</B> or <B>Explain Warning</B> from the shortcut menu for more information about the error.
status
<B>status</B> is TRUE (X) if an error occurred or FALSE (checkmark) to indicate a warning or that no error occurred.

Right-click the <B>error in</B> control on the front panel and select <B>Explain Error</B> or <B>Explain Warning</B> from the shortcut menu for more information about the error.
code
<B>code</B> is the error or warning code.

Right-click the <B>error in</B> control on the front panel and select <B>Explain Error</B> or <B>Explain Warning</B> from the shortcut menu for more information about the error.

Evaluation
Lecture angle MCC1.vi
E:\CNES\Stage été 2025 v2\Code principal\Lecture angle MCC1.vi Last modified on 21/10/2025 at 17:23
Printed on 20/10/2026 at 14:55

Page 2

source
<B>source</B> describes the origin of the error or warning.

Right-click the <B>error in</B> control on the front panel and select <B>Explain Error</B> or <B>Explain Warning</B> from the shortcut menu for more information about the error. error out
<B>error out</B> passes error or warning information out of a VI to be used by other VIs.

Right-click the <B>error out</B> indicator on the front panel and select <B>Explain Error</B> or <B>Explain Warning</B> from the shortcut menu for more information about the error.
status
code
source
Angle sur 14 bits (/16384) Boolean
Angle en tours aimant
0xFE
Boolean
0xFF
Boolean
Angle en degrés en sortie du réducteur Angle mesure entre 0 et 16384

L'adresse de l'esclave est 0b1000000 (on met A2 et A1 à la masse: les deux derniers bits de l'adresse sont paramétrés en hardware). Les adresses des registres à lire sont 0xFE et 0xFF.
Sur les 16 bits renvoyés, on ne s'intéresse qu'à 14 d'entre eux, car les bits de poids foirt (numéro 7 et 6) lus à l'adress 0xFF sont ignorés.
Pour convertir cette information binaire en degrés, on prend simplement le nombre obtenu, on le divise par 16384 (2^14), avant de multiplier par 360 (pour avoir la mesure en degrés), ou 2*pi (pour avoir la mesure en radians), ou autre pour d'autres unités de mesure d'angle (gradian etc...). Il est à noter qu'on obtient seulement l'angle au niveau du capteur, et qu'il faut opérer à un traitement de cette information pour pouvoir obtenir une mesurer de l'angle en sortie du réducteur (il ne suffit pas de diviser par 5!).

1000001

### 0 FE

Bytes Read[1]

Bytes Read[0]

6

2

Angle sur 14 bits (/16384)

Angle en tours aimant

0xFE

0xFF

Angle en degrés en sortie du réducteur

360

Angle mesure entre 0 et 16384

error in (no error)

57,8

2

16384 16384
