Ahhj93/mini-apterros/docs/labview/Turbines.pdf

Evaluation
Turbines.vi
E:\CNES\Stage été 2025 v2\Code principal\Turbines.vi Last modified on 21/10/2025 at 17:24
Printed on 20/10/2026 at 14:33

Page 1

error out
error in (no error)

Puissance de repos roulis (...

last element?

Entrées turbines

Turbines.vi

status
0

code

source

error in (no error)
status
0

code

source

error out

last element?

0

Puissance de repos roulis (en %)

0

Roulis

0

Poussée

Entrées turbines

error in (no error)
<B>error in</B> can accept error information wired from VIs previously called. Use this information to decide if any functionality should be bypassed in the event of errors from other VIs.

Right-click the <B>error in</B> control on the front panel and select <B>Explain Error</B> or <B>Explain Warning</B> from the shortcut menu for more information about the error.
status
<B>status</B> is TRUE (X) if an error occurred or FALSE (checkmark) to indicate a warning or that no error occurred.

Right-click the <B>error in</B> control on the front panel and select <B>Explain Error</B> or <B>Explain Warning</B> from the shortcut menu for more information about the error.

Printed on 20/10/2026 at 14:33

Page 2

code
<B>code</B> is the error or warning code.

Right-click the <B>error in</B> control on the front panel and select <B>Explain Error</B> or <B>Explain Warning</B> from the shortcut menu for more information about the error. source
<B>source</B> describes the origin of the error or warning.

Right-click the <B>error in</B> control on the front panel and select <B>Explain Error</B> or <B>Explain Warning</B> from the shortcut menu for more information about the error.
last element?
Puissance de repos roulis (en %) Entrées turbines
Poussée
Roulis
error out
<B>error in</B> can accept error information wired from VIs previously called. Use this information to decide if any functionality should be bypassed in the event of errors from other VIs.

Right-click the <B>error in</B> control on the front panel and select <B>Explain Error</B> or <B>Explain Warning</B> from the shortcut menu for more information about the error.
status
<B>status</B> is TRUE (X) if an error occurred or FALSE (checkmark) to indicate a warning or that no error occurred.

Right-click the <B>error in</B> control on the front panel and select <B>Explain Error</B> or <B>Explain Warning</B> from the shortcut menu for more information about the error.
code
<B>code</B> is the error or warning code.

Right-click the <B>error in</B> control on the front panel and select <B>Explain Error</B> or <B>Explain Warning</B> from the shortcut menu for more information about the error. source
<B>source</B> describes the origin of the error or warning.

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

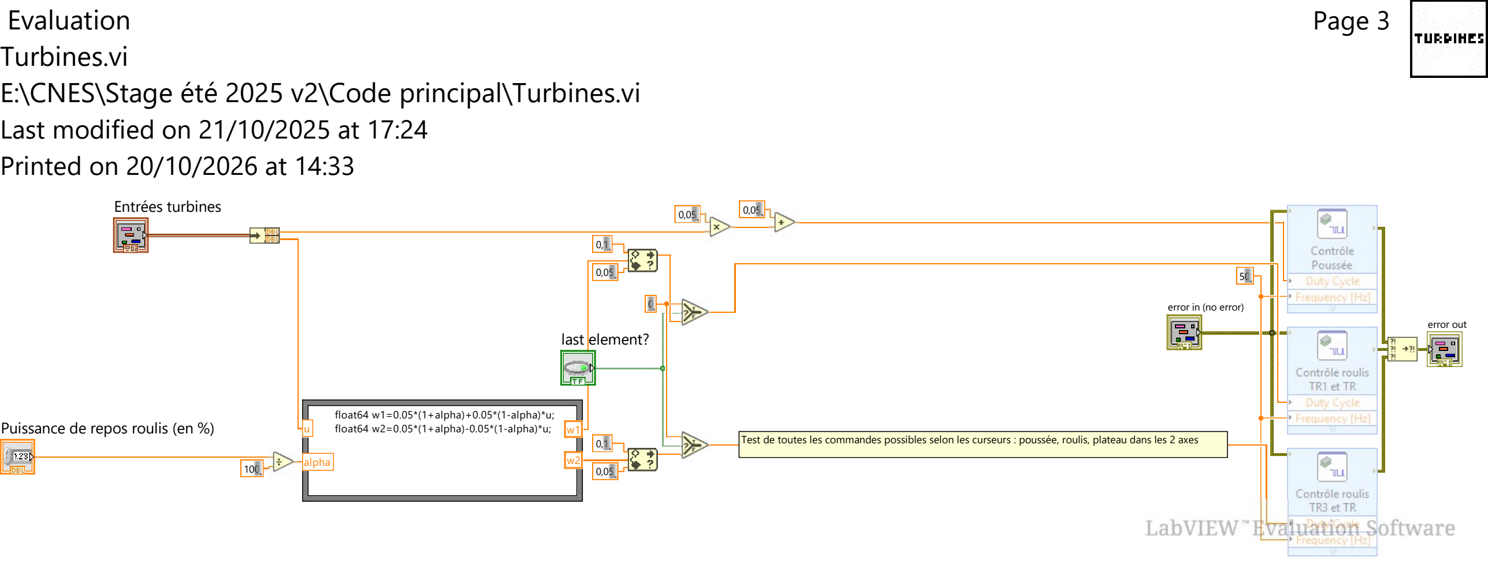
[picture p116: figure]
Printed on 20/10/2026 at 14:33; Page 3; error in (no error); error out; float64 w1=0.05*(1+alpha)+0.05*(1-alpha)*u; float64 w2=0.05*(1+alpha)-0.05*(1-alpha)*u;; alpha; last element?; Puissance de repos roulis (en %); Entrées turbines

Test de toutes les commandes possibles selon les curseurs : poussée, roulis, plateau dans les 2 axes
