Ahhj93/mini-apterros/docs/labview/Test Asservissement moteurs CC.pdf

Evaluation | Page 1
Test Asservissement moteurs CC.vi
E:\CNES\Stage été 2025 v2\Code principal\Test Asservissement moteurs CC.vi
Last modified on 23/09/2025 at 11:18
Printed on 20/10/2026 at 14:34
Test Asservissement moteurs CC.vi

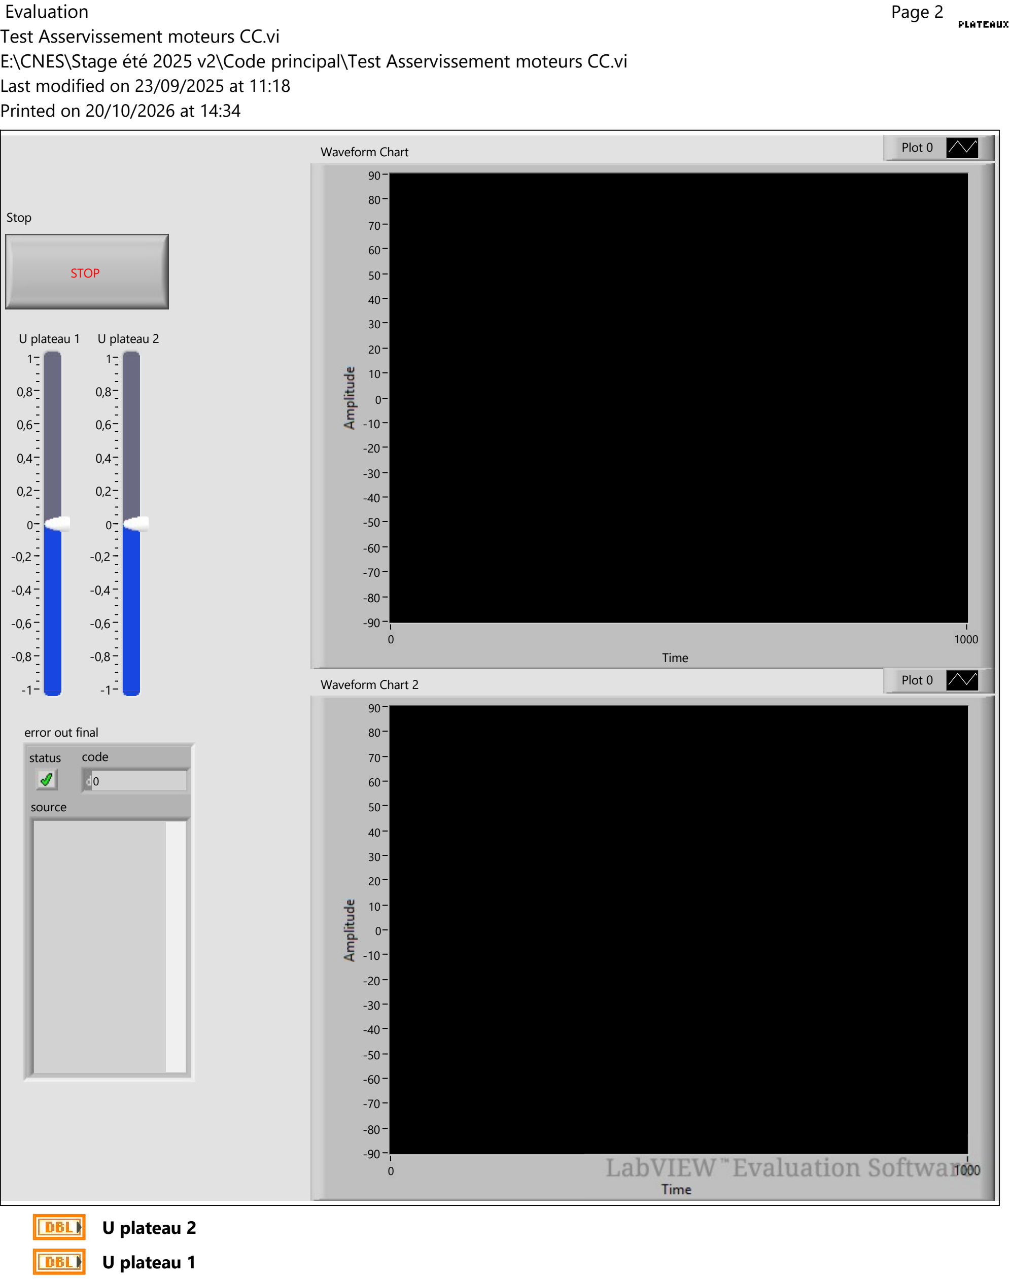
[picture p117: page 2]

Printed on 20/10/2026 at 14:34

Page 2

1

-1

-0,8

-0,6

-0,4

-0,2

0

0,2

0,4

0,6

0,8

U plateau 2
1

-1

-0,8

-0,6

-0,4

-0,2

0

0,2

0,4

0,6

0,8

U plateau 1

status
0

code

source

error out final

STOP

Stop

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
Time

0 1000

Waveform Chart | Plot 0

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
Time

0 1000

Waveform Chart 2 | Plot 0

U plateau 2
U plateau 1

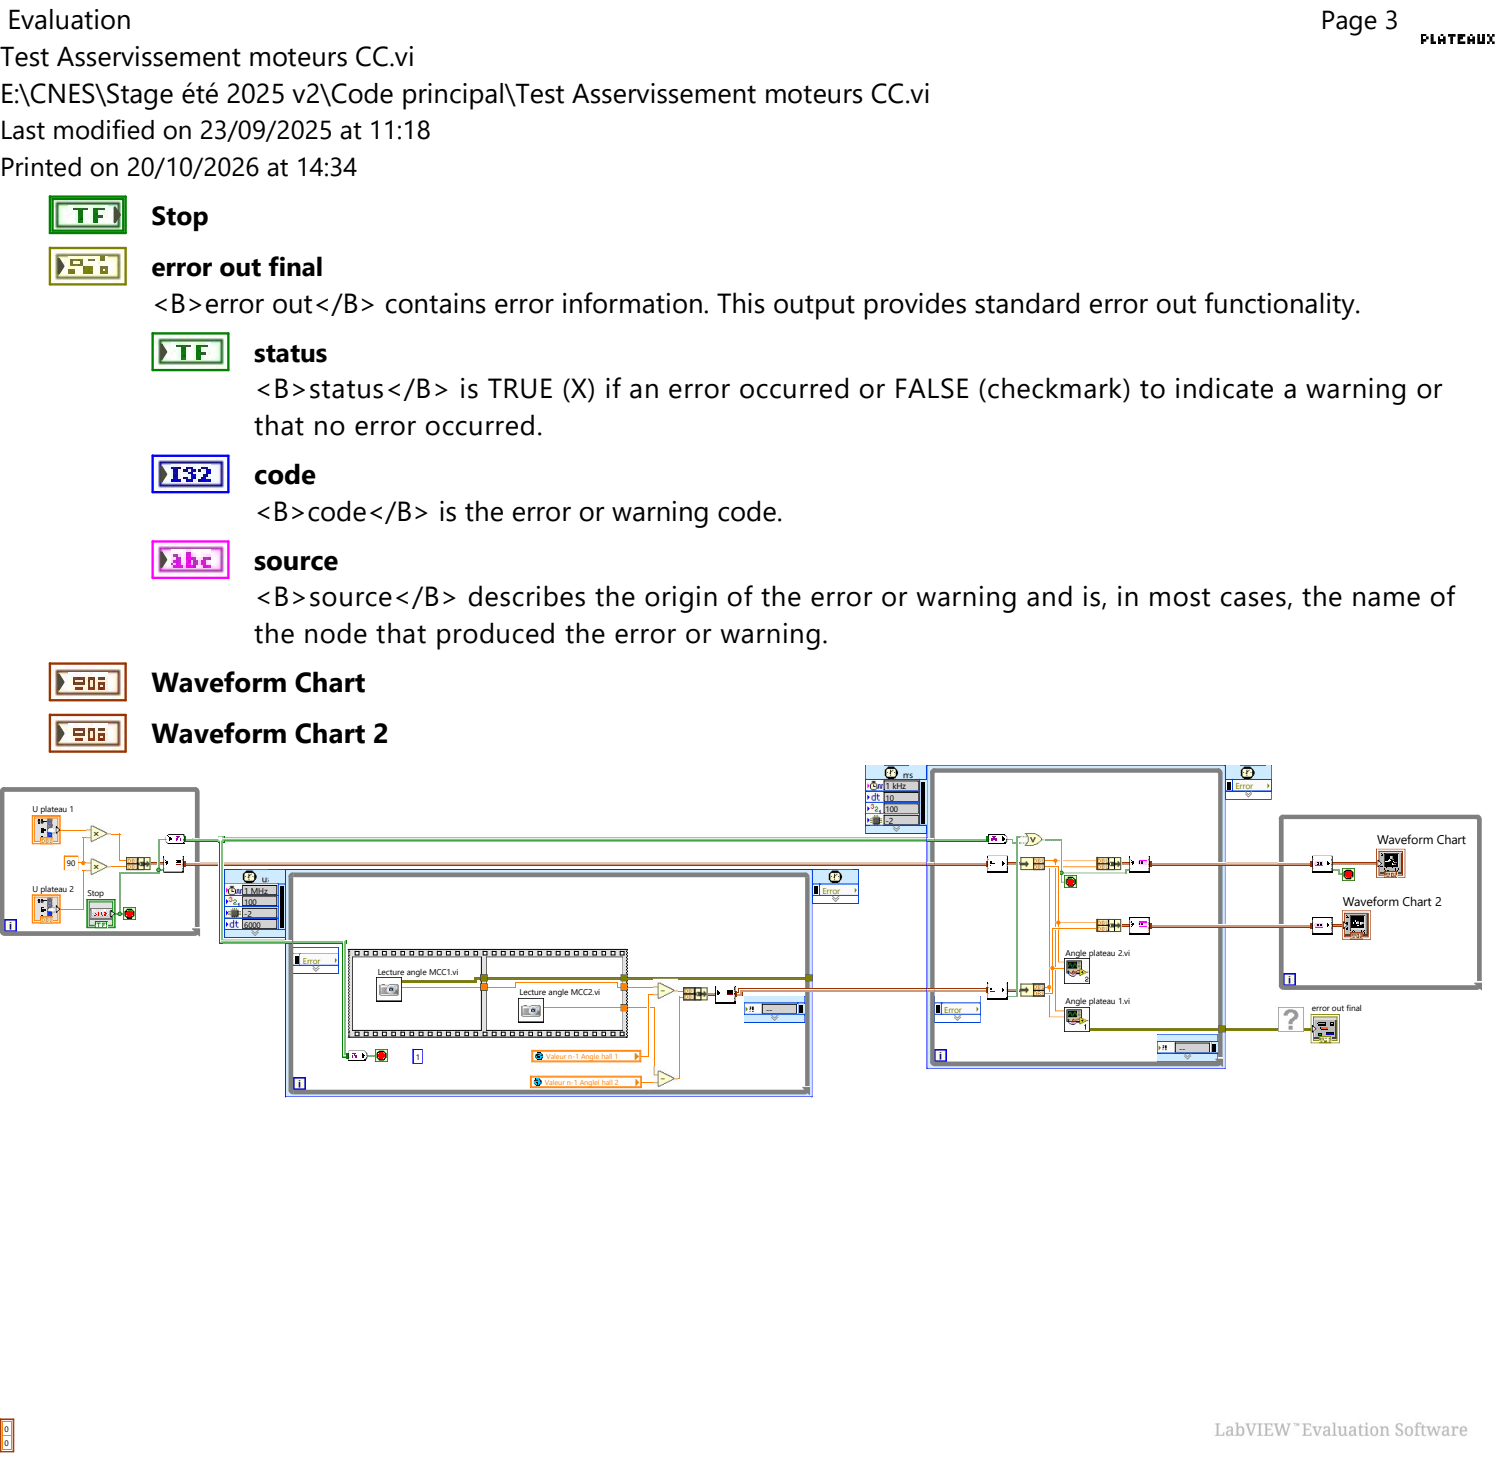
[picture p118: page 3]
Page 3; Error; U plateau 1; U plateau 2; Stop; Waveform Chart; Waveform Chart 2; us 1 MHz 100 -2 6000

Printed on 20/10/2026 at 14:34

Stop
error out final
<B>error out</B> contains error information. This output provides standard error out functionality.

status
<B>status</B> is TRUE (X) if an error occurred or FALSE (checkmark) to indicate a warning or
that no error occurred.
code
<B>code</B> is the error or warning code.
source
<B>source</B> describes the origin of the error or warning and is, in most cases, the name of
the node that produced the error or warning.
Waveform Chart
Waveform Chart 2

ms ms
1 kHz | Error

Angle plateau 2.vi

Lecture angle MCC1.vi

Lecture angle MCC2.vi

Angle plateau 1.vi

Valeur n-1 Angle hall 1

Valeur n-1 Anglel hall 2
