Ahhj93/mini-apterros/docs/labview/Test Capteurs Hall 2.pdf

Evaluation
Test Capteur Hall 2.vi
E:\CNES\Stage été 2025 v2\Code principal\Test Capteur Hall 2.vi Last modified on 25/06/2025 at 10:36
Printed on 20/10/2026 at 14:44

Page 1

Test Capteur Hall 2.vi

0

status code

STOP

Stop

status
0

code

source

error out final

Stop
error out 2
<B>error out</B> passes error or warning information out of a VI to be used by other VIs.

Right-click the <B>error out</B> indicator on the front panel and select <B>Explain Error</B> or <B>Explain Warning</B> from the shortcut menu for more information about the error.
status
code
source
error out final
<B>error out</B> contains error information. This output provides standard error out functionality. status
<B>status</B> is TRUE (X) if an error occurred or FALSE (checkmark) to indicate a warning or that no error occurred.
code
<B>code</B> is the error or warning code.

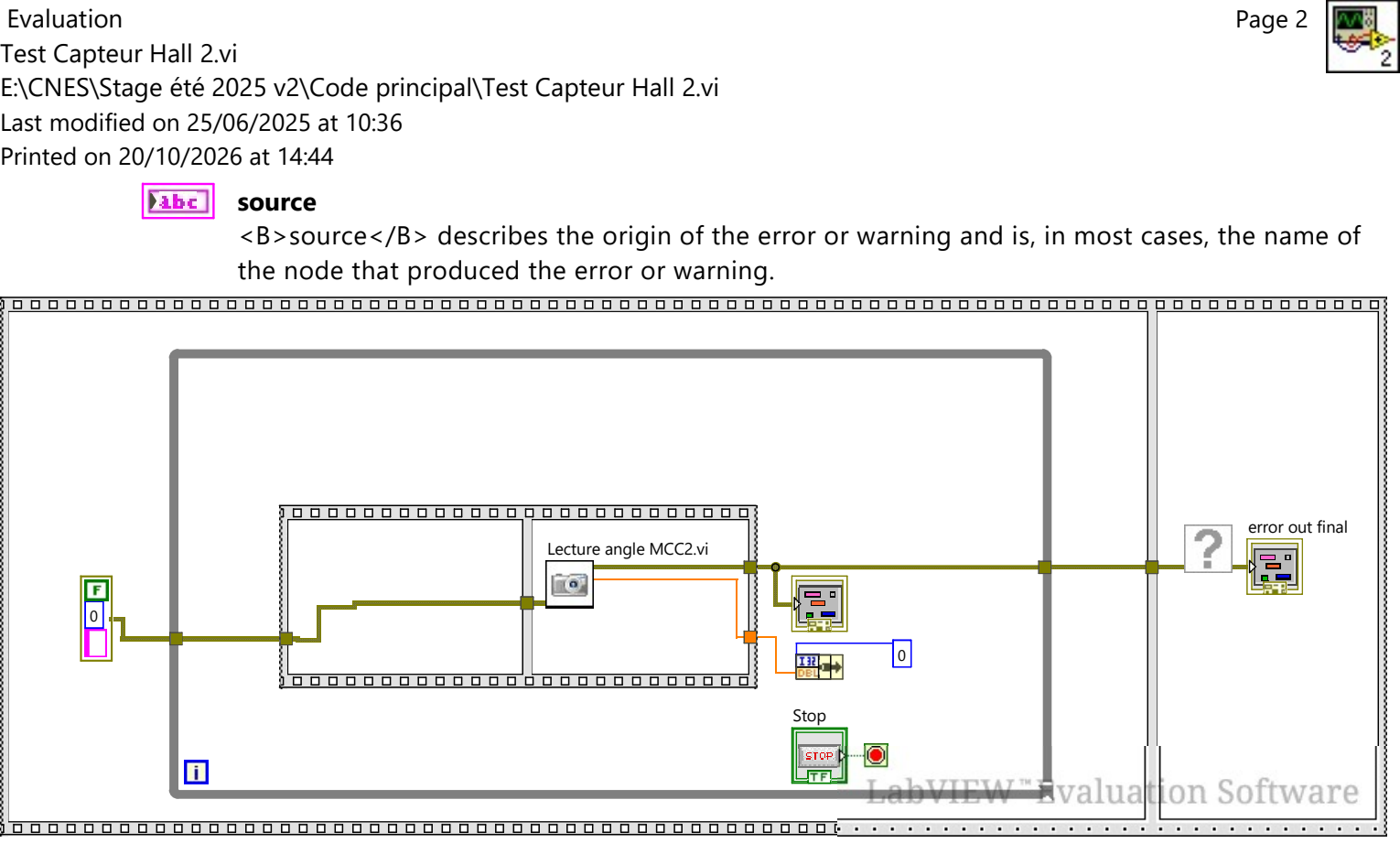
[picture p119: figure]
Evaluation Test Capteur Hall 2.vi; Last modified on 25/06/2025 at 10:36 Printed on 20/10/2026 at 14:44; Page 2; source; Lecture angle MCC2.vi; Stop; error out final

E:\CNES\Stage été 2025 v2\Code principal\Test Capteur Hall 2.vi

<B>source</B> describes the origin of the error or warning and is, in most cases, the name of the node that produced the error or warning.
