Ahhj93/mini-apterros/docs/labview/Test Capteurs Hall avec Initialisation.pdf

Evaluation
Test Capteurs Halls Avec Initialisation.vi
E:\CNES\Stage été 2025 v2\Code principal\Test Capteurs Halls Avec Initialisation.vi Last modified on 23/09/2025 at 11:41
Printed on 20/10/2026 at 14:38

Page 1

Test Capteurs Halls Avec Initialisation.vi

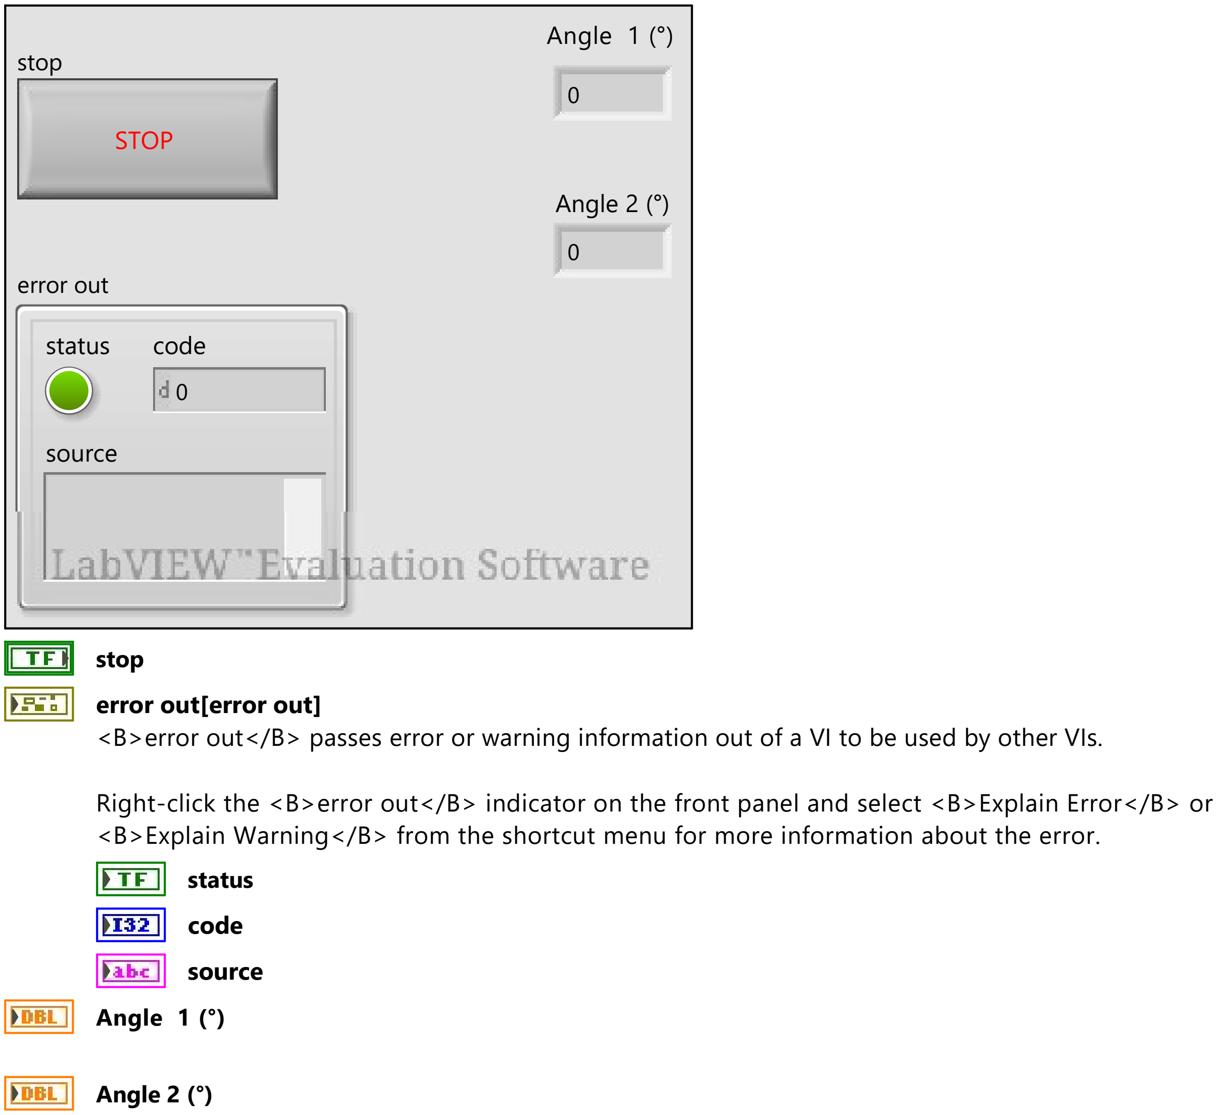
[picture p120: figure]
code; source; status; error out; Angle 1 (°); Angle 2 (°); STOP; stop; stop error out[error out]; status code source

<B>error out</B> passes error or warning information out of a VI to be used by other VIs.

Right-click the <B>error out</B> indicator on the front panel and select <B>Explain Error</B> or <B>Explain Warning</B> from the shortcut menu for more information about the error.

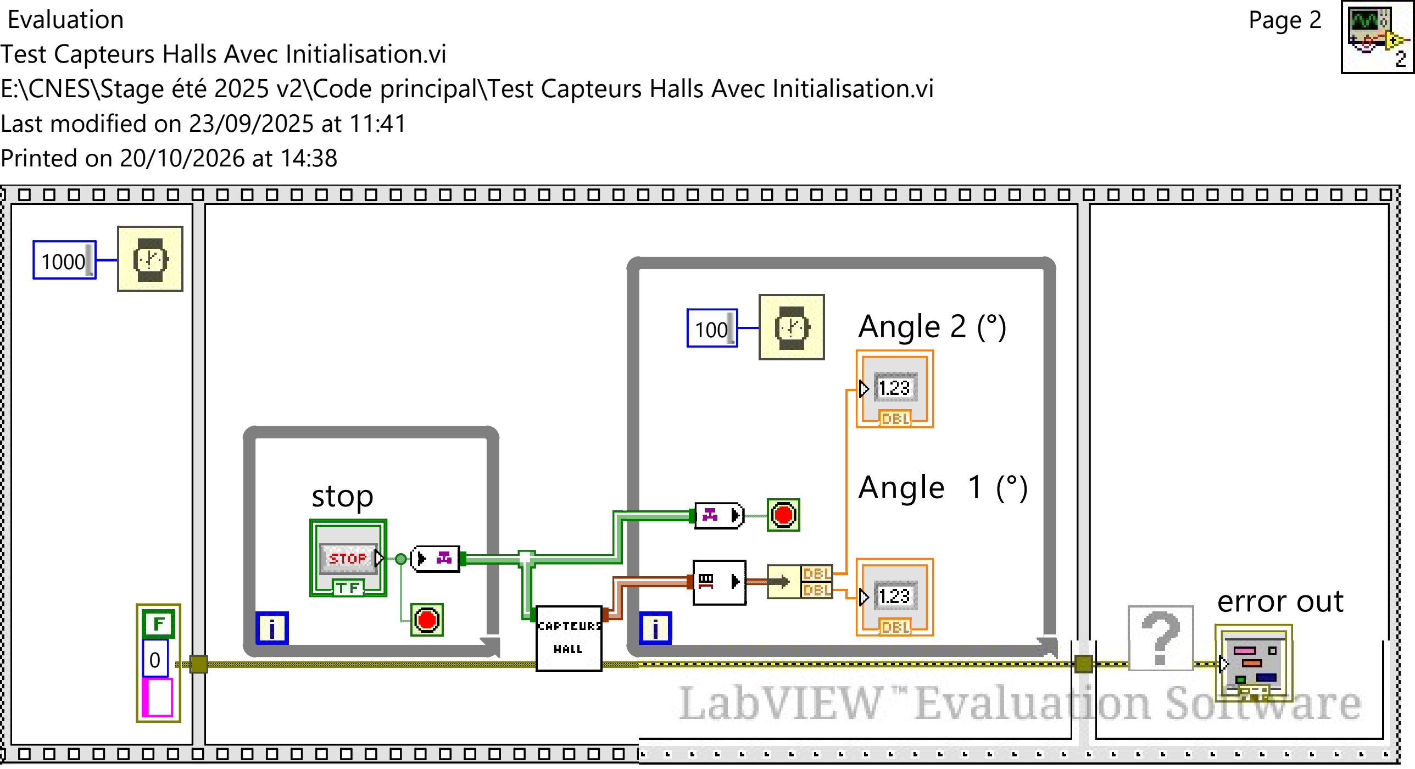
[picture p121: figure]
Evaluation Test Capteurs Halls Avec Initialisation.vi; Last modified on 23/09/2025 at 11:41 Printed on 20/10/2026 at 14:38; Page 2; stop; Angle 1 (°); 100 Angle 2 (°); error out

E:\CNES\Stage été 2025 v2\Code principal\Test Capteurs Halls Avec Initialisation.vi
