Ahhj93/mini-apterros/docs/labview/Test Capteurs Hall.pdf

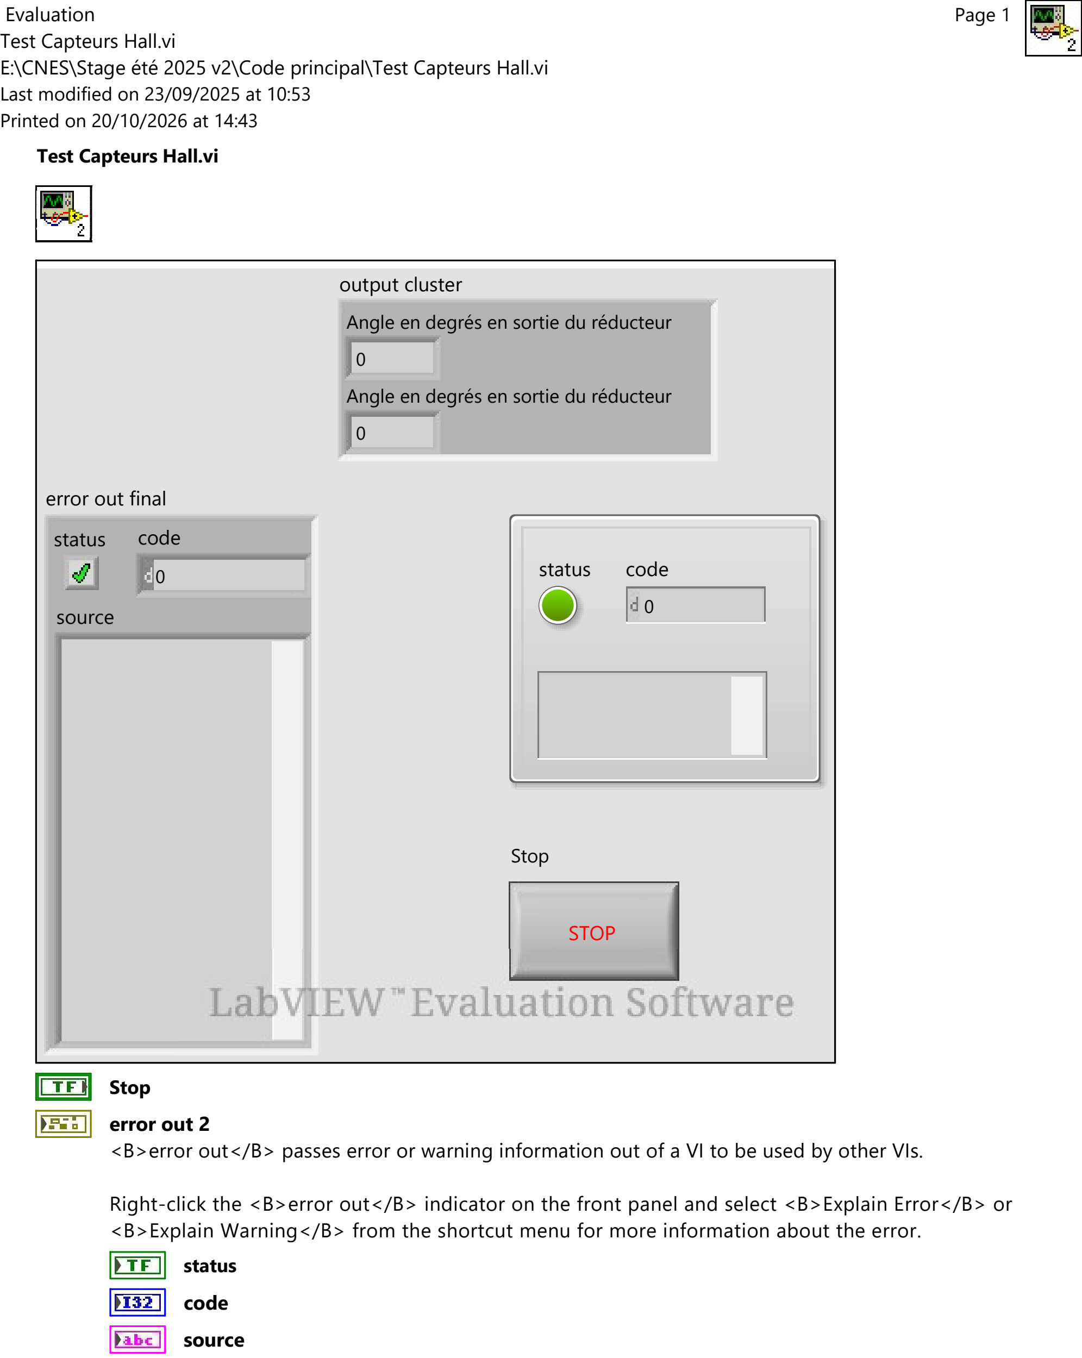
[picture p122: page 1]

Evaluation
Test Capteurs Hall.vi
E:\CNES\Stage été 2025 v2\Code principal\Test Capteurs Hall.vi Last modified on 23/09/2025 at 10:53
Printed on 20/10/2026 at 14:43

Page 1

Test Capteurs Hall.vi

0

status code

STOP

Stop

status
0

code

source

error out final

0

Angle en degrés en sortie du réducteur

0

Angle en degrés en sortie du réducteur

output cluster

Stop
error out 2
<B>error out</B> passes error or warning information out of a VI to be used by other VIs.

Right-click the <B>error out</B> indicator on the front panel and select <B>Explain Error</B> or <B>Explain Warning</B> from the shortcut menu for more information about the error.
status
code
source

Evaluation
Test Capteurs Hall.vi
E:\CNES\Stage été 2025 v2\Code principal\Test Capteurs Hall.vi Last modified on 23/09/2025 at 10:53
Printed on 20/10/2026 at 14:43

Page 2

error out final
<B>error out</B> contains error information. This output provides standard error out functionality. status
<B>status</B> is TRUE (X) if an error occurred or FALSE (checkmark) to indicate a warning or that no error occurred.
code
<B>code</B> is the error or warning code.
source
<B>source</B> describes the origin of the error or warning and is, in most cases, the name of the node that produced the error or warning.
output cluster
Angle en degrés en sortie du réducteur
Angle en degrés en sortie du réducteur

Lecture angle MCC1.vi

Lecture angle MCC2.vi

Stop

output cluster ⁰

error out final
