Ahhj93/mini-apterros/docs/labview/Test IMU v2.pdf

Evaluation
Test IMU v2.vi
E:\CNES\Stage été 2025 v2\Code principal\Test IMU v2.vi Last modified on 23/09/2025 at 11:33
Printed on 20/10/2026 at 14:36

Page 1

Test IMU v2.vi

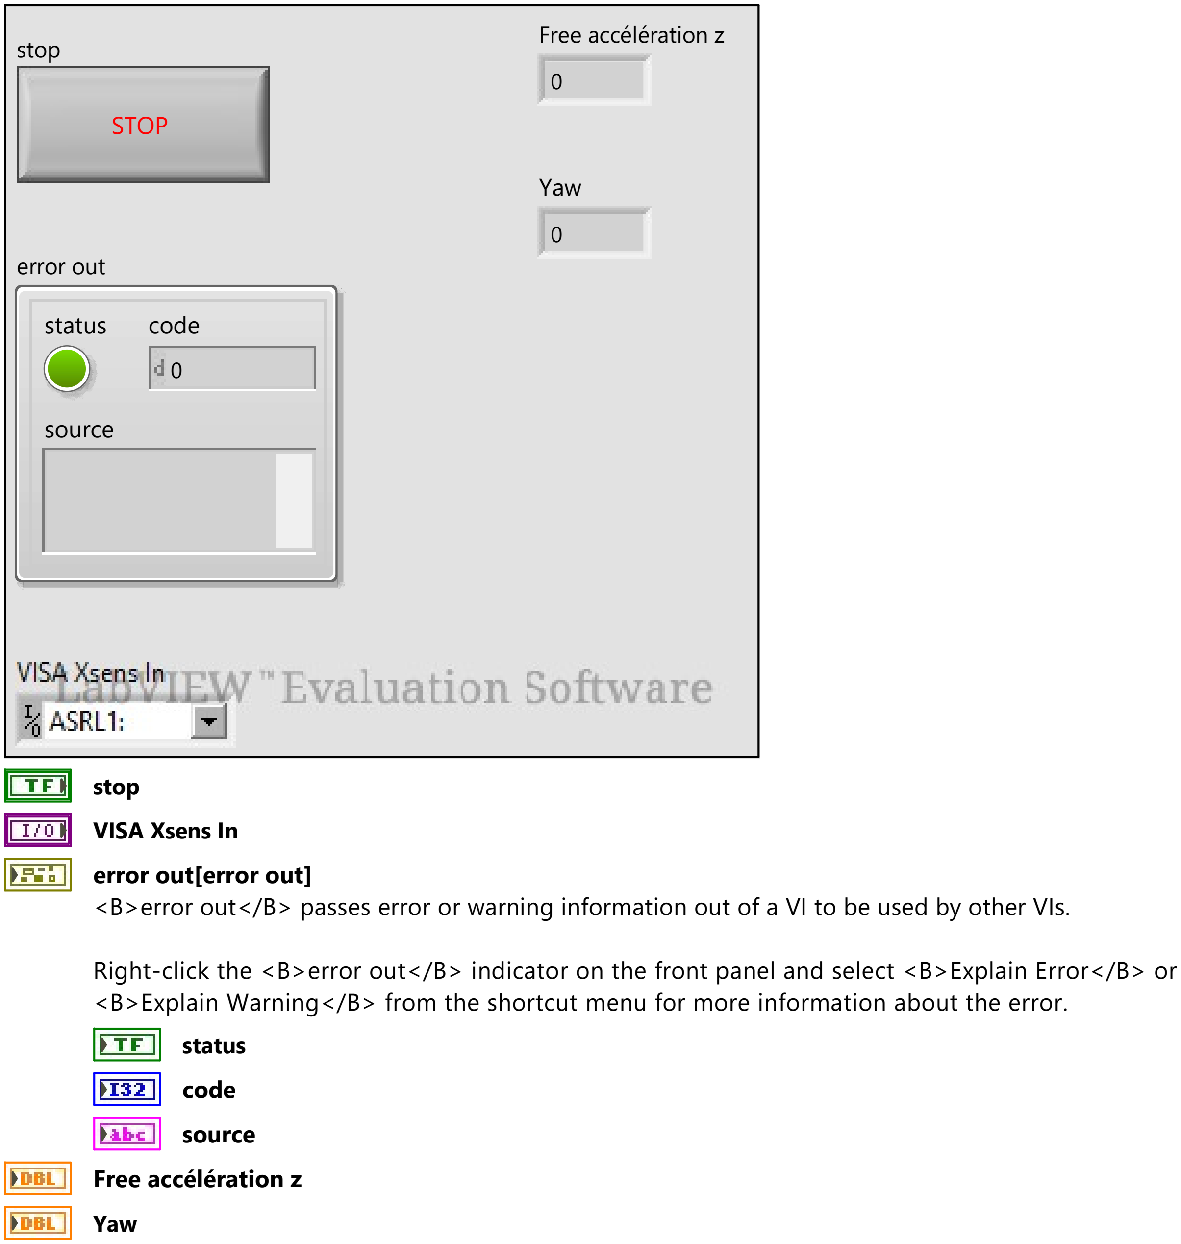
[picture p124: figure]
code; source; status; error out; Free accélération z; Yaw; STOP; stop; ASRL1:; VISA Xsens In; VISA Xsens In error out[error out]; status code source Free accélération z

<B>error out</B> passes error or warning information out of a VI to be used by other VIs.

Right-click the <B>error out</B> indicator on the front panel and select <B>Explain Error</B> or <B>Explain Warning</B> from the shortcut menu for more information about the error.

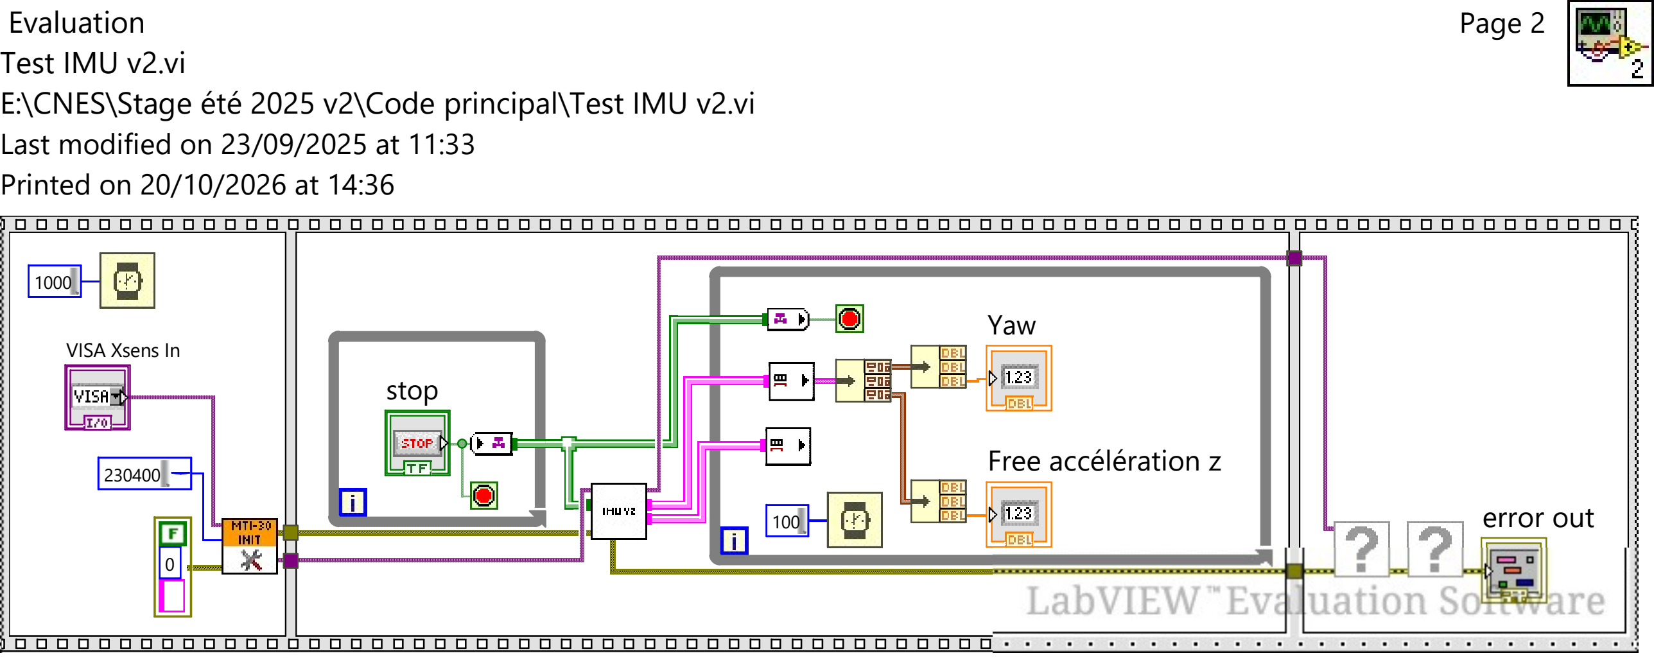
[picture p125: figure]
Printed on 20/10/2026 at 14:36; Page 2; VISA Xsens In; stop; Free accélération z; Yaw; 100 error out

Printed on 20/10/2026 at 14:36

Page 3

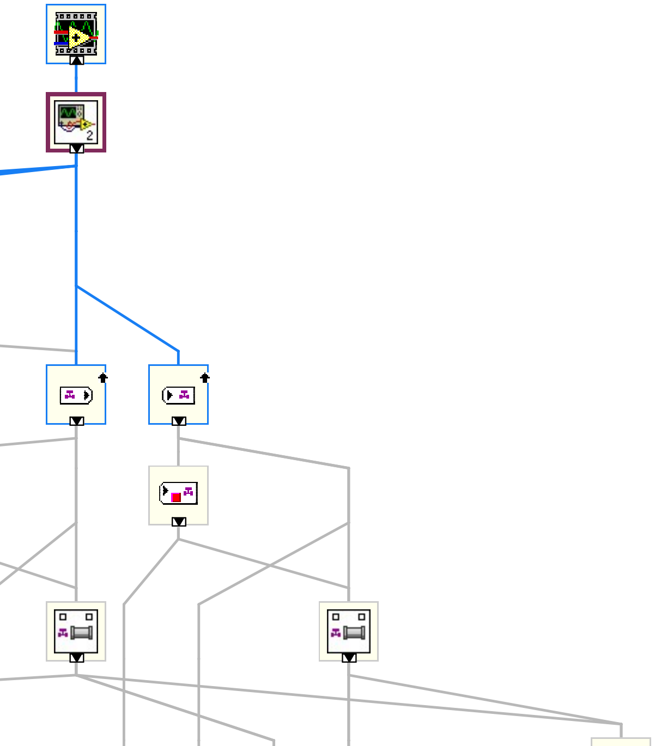
[picture p126: figure]

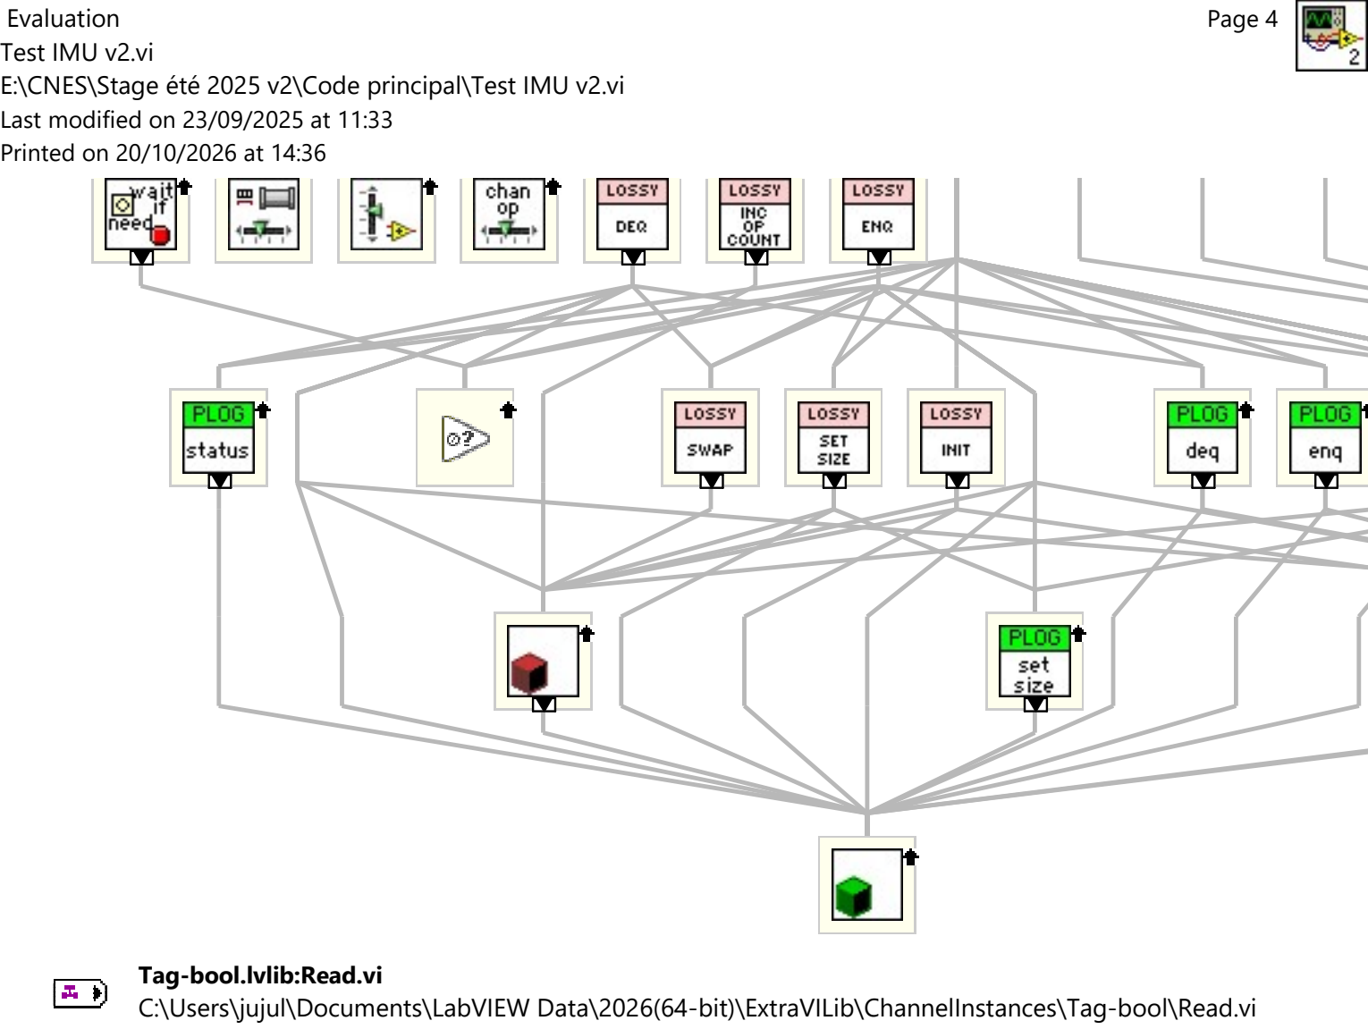
[picture p127: figure]
Printed on 20/10/2026 at 14:36; Page 4; Tag-bool.lvlib:Read.vi C:\Users\jujul\Documents\LabVIEW Data\2026(64-bit)\ExtraVILib\ChannelInstances\Tag-bool\Read.vi

Lossy Stream-c(c(dbl,dbl,dbl),c(dbl,dbl,dbl),c(dbl,dbl,dbl)).lvlib:Read.vi C:\Users\jujul\Documents\LabVIEW Data\2026(64-bit)\ExtraVILib\ChannelInstances\Lossy Stream-c(c(dbl,dbl,dbl),c(dbl,dbl,dbl),c(dbl,dbl,dbl))\Read.vi
Initialisation Xsens.vi
E:\CNES\Stage été 2025 v2\Code principal\Initialisation Xsens.vi
Tag-bool.lvlib:Write.vi
C:\Users\jujul\Documents\LabVIEW Data\2026(64-bit)\ExtraVILib\ChannelInstances\Tag-bool\Write.vi IMU v2.vi
E:\CNES\Stage été 2025 v2\Code principal\IMU v2.vi
"Test IMU v2.vi History"
Current Revision: 41

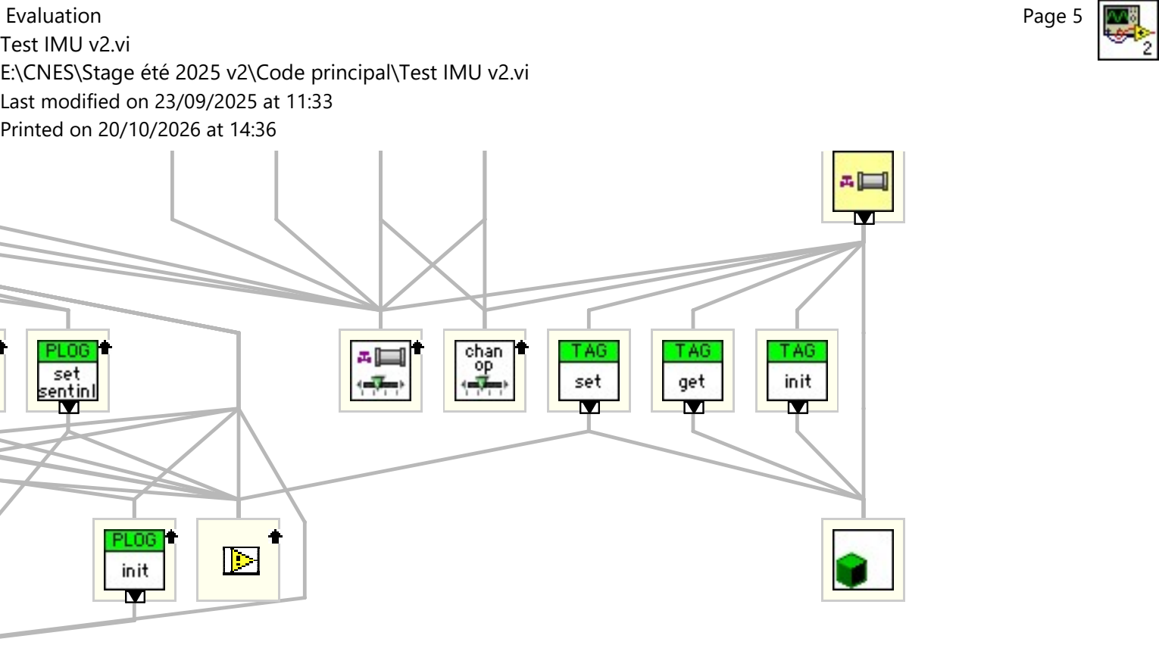
[picture p128: figure]
Printed on 20/10/2026 at 14:36; Page 5
