Ahhj93/mini-apterros/docs/labview/Test Lidars v2.pdf

Evaluation
Test Lidars v2.vi
E:\CNES\Stage été 2025 v2\Code principal\Test Lidars v2.vi Last modified on 23/09/2025 at 11:19
Printed on 20/10/2026 at 14:35

Page 1

Test Lidars v2.vi

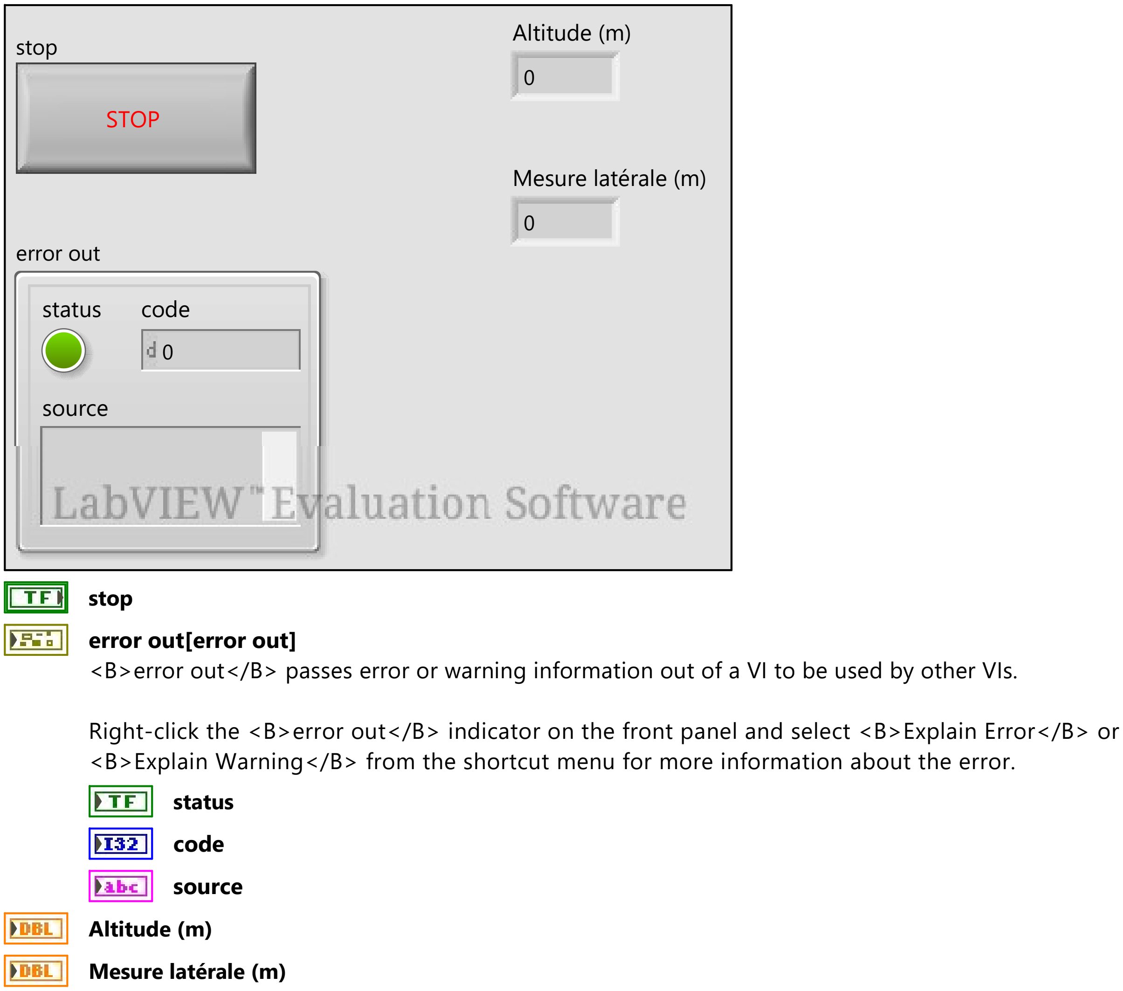
[picture p129: figure]
code; source; status; error out; Altitude (m); Mesure latérale (m); STOP; stop; stop error out[error out]; status code source

<B>error out</B> passes error or warning information out of a VI to be used by other VIs.

Right-click the <B>error out</B> indicator on the front panel and select <B>Explain Error</B> or <B>Explain Warning</B> from the shortcut menu for more information about the error.

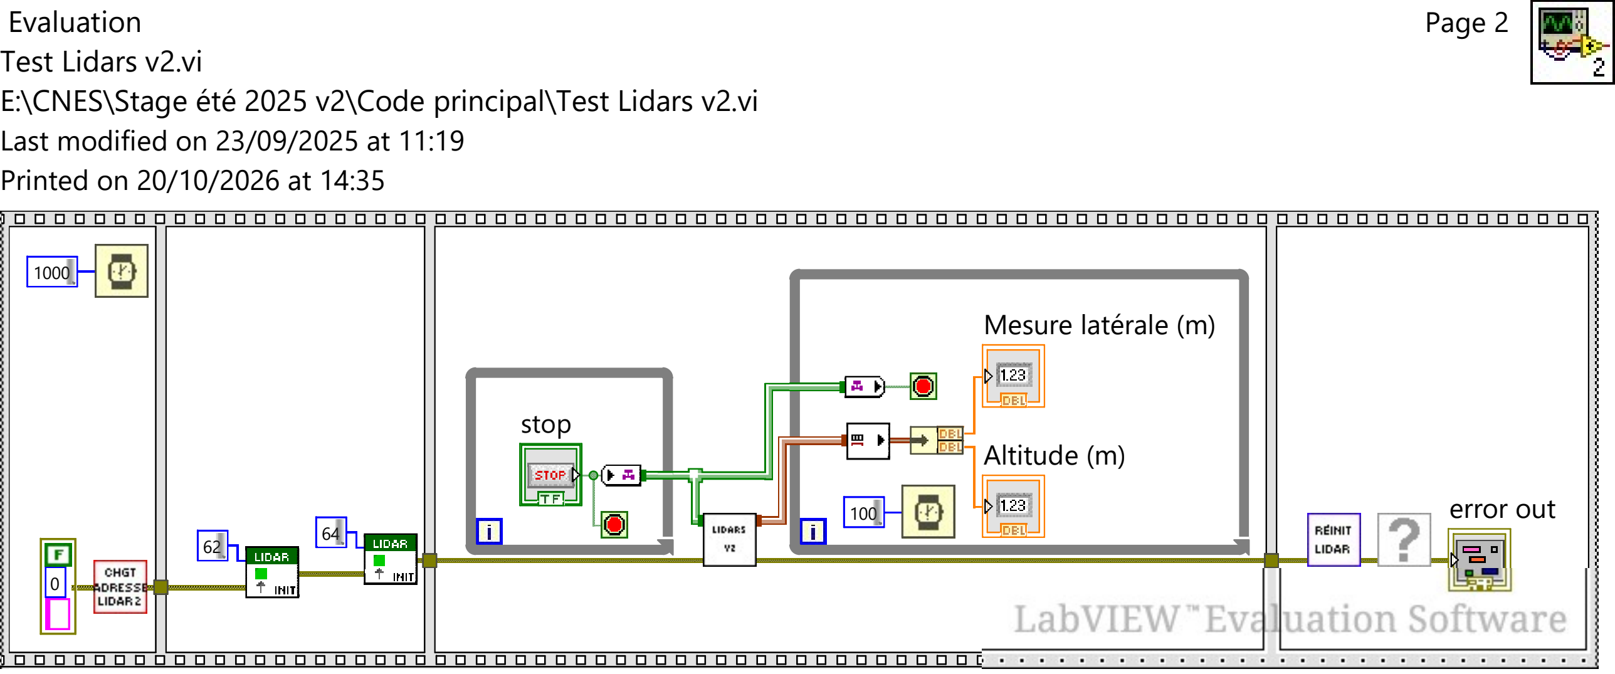
[picture p130: figure]
Evaluation Test Lidars v2.vi; Last modified on 23/09/2025 at 11:19 Printed on 20/10/2026 at 14:35; Page 2; stop; Altitude (m); Mesure latérale (m); 100 error out

E:\CNES\Stage été 2025 v2\Code principal\Test Lidars v2.vi
