Ahhj93/mini-apterros/docs/labview/Test vitesse MCC1.pdf

Evaluation
Test vitesse MCC1.vi
E:\CNES\Stage été 2025 v2\Code principal\Test vitesse MCC1.vi Last modified on 12/02/2025 at 12:36
Printed on 20/10/2026 at 14:35

Page 1

Test vitesse MCC1.vi

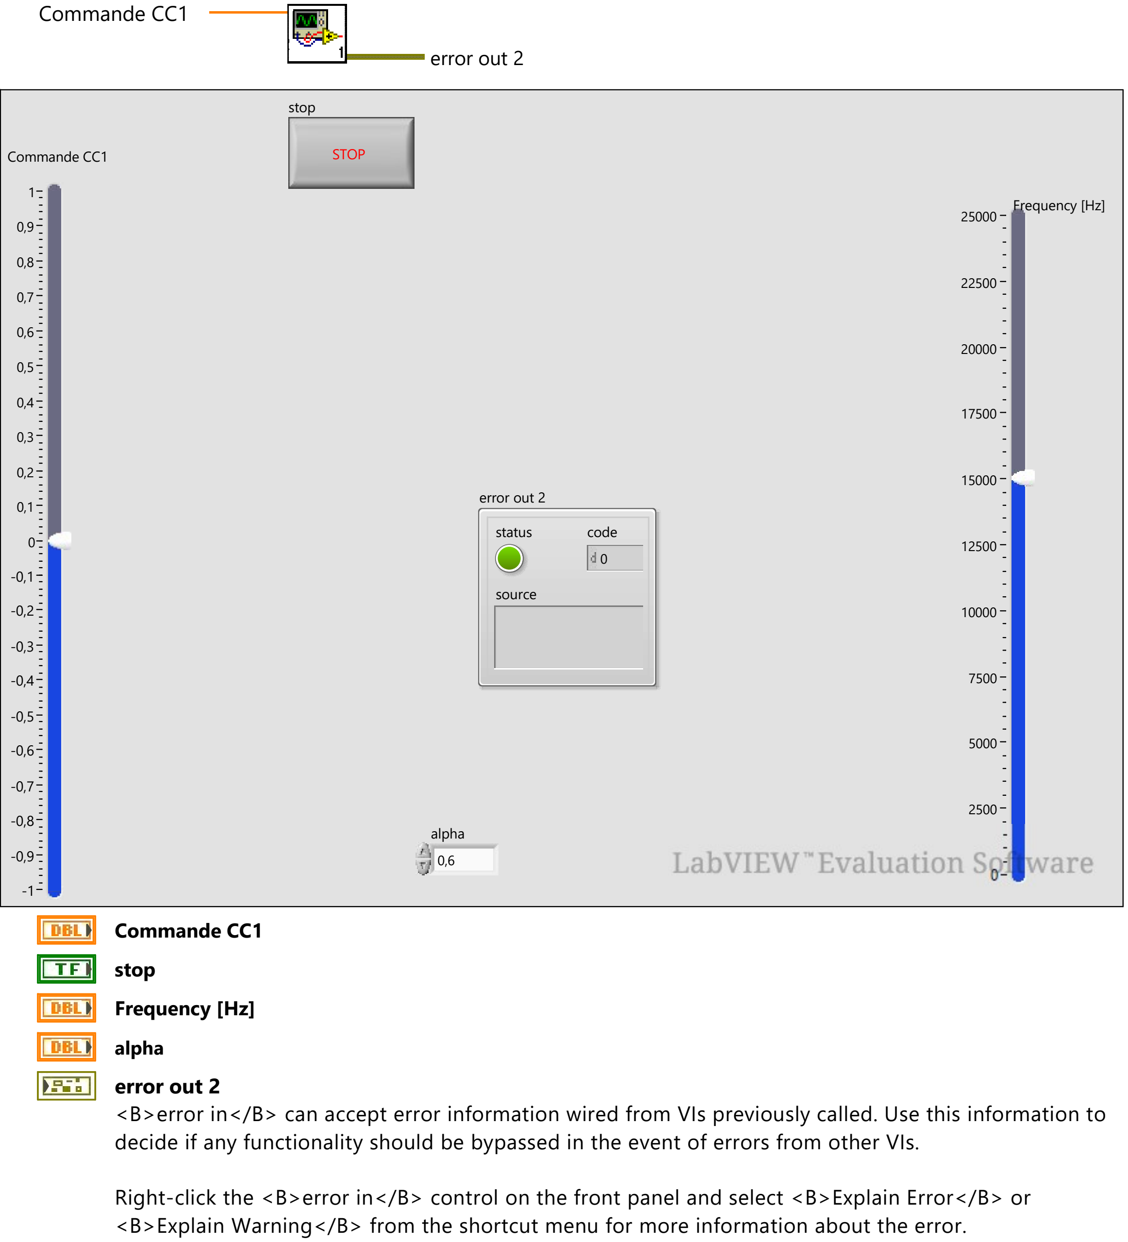
[picture p131: figure]
error out 2; Commande CC1; code; source; status; STOP; stop; Frequency [Hz]; alpha; alpha error out 2

<B>error in</B> can accept error information wired from VIs previously called. Use this information to decide if any functionality should be bypassed in the event of errors from other VIs.

Right-click the <B>error in</B> control on the front panel and select <B>Explain Error</B> or <B>Explain Warning</B> from the shortcut menu for more information about the error.

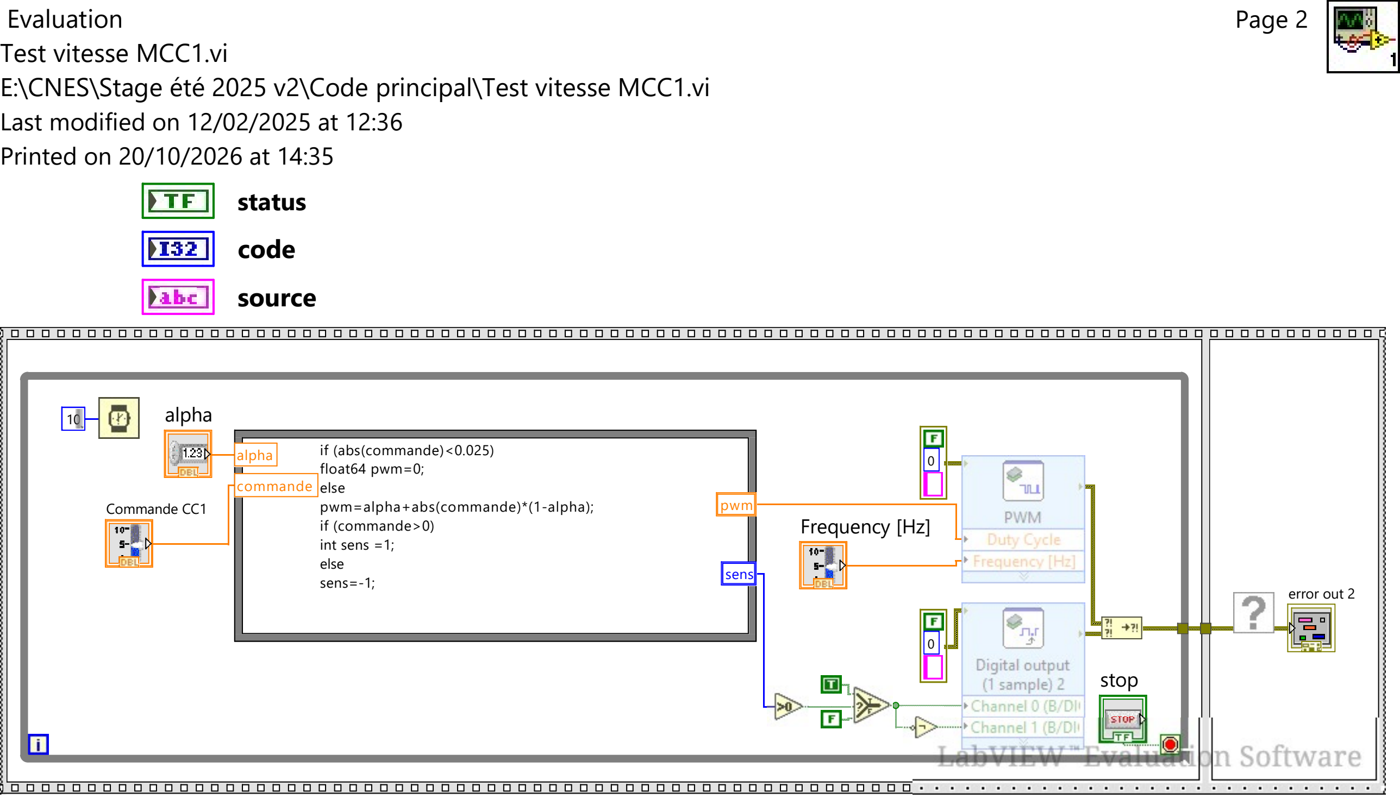
[picture p132: figure]
Evaluation Test vitesse MCC1.vi; Last modified on 12/02/2025 at 12:36 Printed on 20/10/2026 at 14:35; Page 2; status code source; Commande CC1; stop; Frequency [Hz]; alpha; if (abs(commande)<0.025) float64 pwm=0; else pwm=alpha+abs(commande)*(1-alpha); if (commande>0) int sens =1; else; sens=-1;; sens; pwm; commande; error out 2

E:\CNES\Stage été 2025 v2\Code principal\Test vitesse MCC1.vi
