Ahhj93/mini-apterros/src/hardware/old_pcb/PERSEUS_V9.kicad_pcb

## KiCad design src/hardware/old_pcb/PERSEUS_V9.kicad_pcb (2026-10-20, an earlier design)

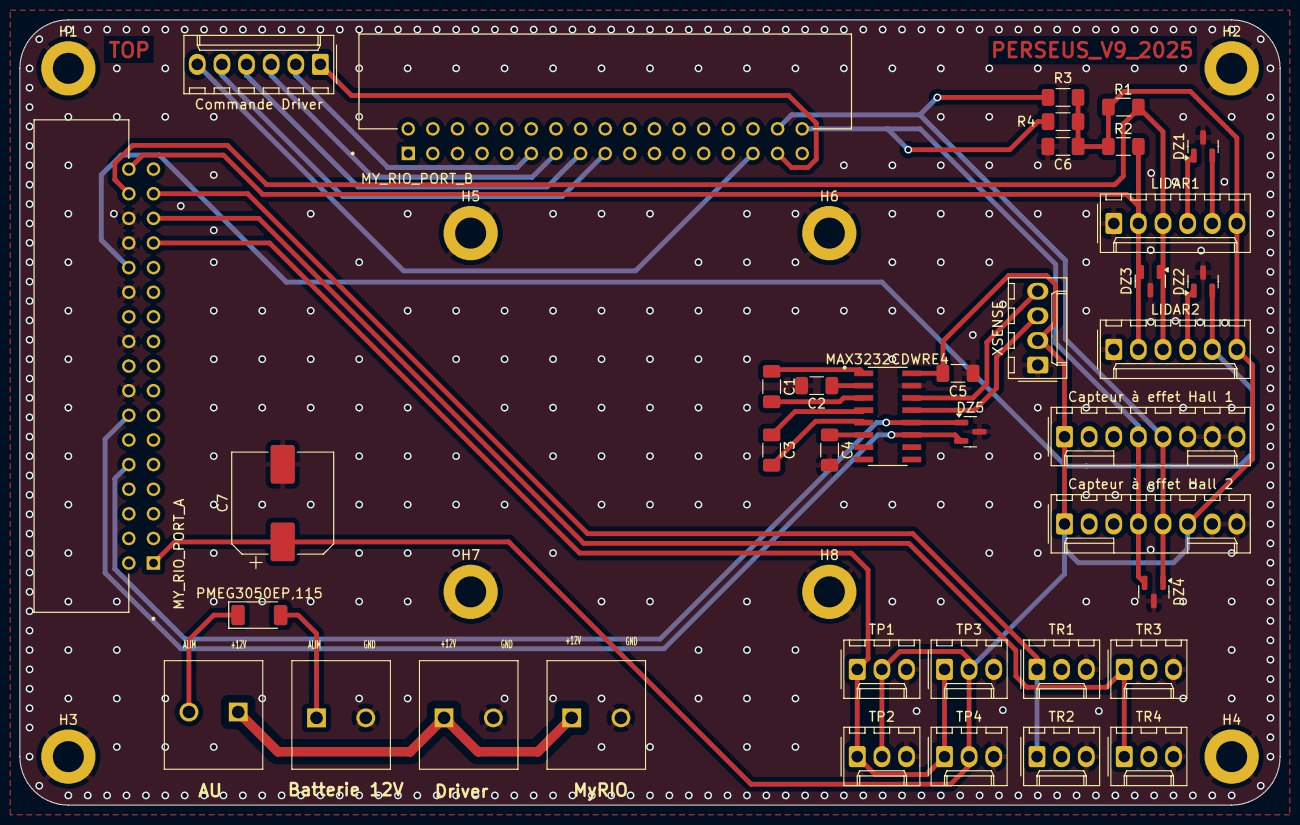
[picture p135: board PERSEUS_V9.kicad_pcb from above]

Board: 2 copper layers, 130.0 x 81.0 mm, 46 parts (0 on the bottom side), 32 nets.

Parts:
AU: RELAIS; 1711725
Batterie 12V: BATTERIE; 1711725
C1: 0.047 uF; C_1206_3216Metric_Pad1.33x1.80mm_HandSolder
C2, C3, C4: 0.033 uF; C_1206_3216Metric_Pad1.33x1.80mm_HandSolder
C5: 0.1 uF; C_1206_3216Metric_Pad1.33x1.80mm_HandSolder
C6: 10uF; C_1206_3216Metric_Pad1.33x1.80mm_HandSolder
C7: 680 uF; CP_Elec_10x10
Capteur à effet Hall 1: Capteur à effet Hall 1; Molex_KK-254_AE-6410-08A_1x08_P2.54mm_Vertical
Capteur à effet Hall 2: Capteur à effet Hall 2; Molex_KK-254_AE-6410-08A_1x08_P2.54mm_Vertical
Commande Driver: Conn_01x06; Molex_KK-254_AE-6410-06A_1x06_P2.54mm_Vertical
DZ1, DZ2, DZ3, DZ4, DZ5: VHW; SOT-23
Driver: MOTEUR_CC; 1711725
H1, H2, H3, H4, H5, H6, H7, H8: MountingHole_Pad; MountingHole_3.2mm_M3_DIN965_Pad
LIDAR1: LIDAR_I2C; Molex_KK-254_AE-6410-06A_1x06_P2.54mm_Vertical
LIDAR2: LIDAR2_I2C; Molex_KK-254_AE-6410-06A_1x06_P2.54mm_Vertical
MAX3232CDWRE4: MAX3232CDWRE4; SOIC127P600X175-16N
MY_RIO_PORT_A: MY_RIO_PORT_A; TE_103311-7
MY_RIO_PORT_B: MY_RIO_PORT_B; TE_103311-7
MyRIO: MY_RIO; 1711725
PMEG3050EP,115: PMEG3050EP,115; D_SOD-128
R1, R2, R3, R4: 4.7k; R_1206_3216Metric_Pad1.30x1.75mm_HandSolder
TP1: TP1; Molex_KK-254_AE-6410-03A_1x03_P2.54mm_Vertical
TP2: TP2; Molex_KK-254_AE-6410-03A_1x03_P2.54mm_Vertical
TP3: TP3; Molex_KK-254_AE-6410-03A_1x03_P2.54mm_Vertical
TP4: TP4; Molex_KK-254_AE-6410-03A_1x03_P2.54mm_Vertical
TR1: TR1; Molex_KK-254_AE-6410-03A_1x03_P2.54mm_Vertical
TR2: TR2; Molex_KK-254_AE-6410-03A_1x03_P2.54mm_Vertical
TR3: TR3; Molex_KK-254_AE-6410-03A_1x03_P2.54mm_Vertical
TR4: TR4; Molex_KK-254_AE-6410-03A_1x03_P2.54mm_Vertical
XSENSE: XSENSE; Molex_KK-254_AE-6410-04A_1x04_P2.54mm_Vertical

Connections:
+5V: C5.2, C6.1, C7.1, Capteur à effet Hall 1.1, Capteur à effet Hall 2.1, Capteur à effet Hall 2.6, LIDAR1.6, LIDAR2.6, MAX3232CDWRE4.16 (VCC), MY_RIO_PORT_A.1, R1.1, R2.1, R3.1, R4.1, TP1.2, TP2.2, TP3.2, TP4.2, XSENSE.2
/+12V: AU.1, Driver.1, MyRIO.1
GND: Batterie 12V.2, C2.2, C4.2, C5.1, C6.2, C7.2, Capteur à effet Hall 1.6, Capteur à effet Hall 1.7, Capteur à effet Hall 1.8, Capteur à effet Hall 2.7, Capteur à effet Hall 2.8, DZ1.3 (A), DZ2.3 (A), DZ3.3 (A), DZ4.3 (A), DZ5.3 (A), Driver.2, H1.1, H2.1, H3.1, H4.1, H5.1, H6.1, H7.1, H8.1, LIDAR1.1, LIDAR2.1, MAX3232CDWRE4.15 (GND), MY_RIO_PORT_A.16, MY_RIO_PORT_A.20, MY_RIO_PORT_A.24, MY_RIO_PORT_A.28, MY_RIO_PORT_A.30, MyRIO.2, TP1.3, TP2.3, TP3.3, TP4.3, TR1.3, TR2.3, TR3.3, TR4.3, XSENSE.1
I2C_SDA: DZ3.2 (K), LIDAR1.2, LIDAR2.2, MY_RIO_PORT_A.34, R2.2
I2C_SDA_B: Capteur à effet Hall 1.4, Capteur à effet Hall 2.4, DZ4.2 (K), MY_RIO_PORT_B.34, R4.2
I2C_SDL: DZ3.1 (K), LIDAR1.3, LIDAR2.3, MY_RIO_PORT_A.32, R1.2
I2C_SDL_B: Capteur à effet Hall 1.5, Capteur à effet Hall 2.5, DZ4.1 (K), MY_RIO_PORT_B.32, R3.2
LIDAR2_4: DZ2.1 (K), LIDAR2.4
LIDAR2_5: DZ2.2 (K), LIDAR2.5, MY_RIO_PORT_A.26
LIDAR_4: DZ1.1 (K), LIDAR1.4
LIDAR_5: DZ1.2 (K), LIDAR1.5
unnamed: C1.1, MAX3232CDWRE4.1 (C1+)
unnamed: C1.2, MAX3232CDWRE4.3 (C1-)
unnamed: C3.1, MAX3232CDWRE4.4 (C2+)
unnamed: C3.2, MAX3232CDWRE4.5 (C2-)
unnamed: C2.1, MAX3232CDWRE4.2 (V+)
unnamed: C4.1, MAX3232CDWRE4.6 (V-)
unnamed: AU.2, PMEG3050EP,115.1
unnamed: Batterie 12V.1, PMEG3050EP,115.2
OUTPUT_1: Commande Driver.2, MY_RIO_PORT_B.11
OUTPUT_2: Commande Driver.3, MY_RIO_PORT_B.13
OUTPUT_3: Commande Driver.4, MY_RIO_PORT_B.15
OUTPUT_4: Commande Driver.5, MY_RIO_PORT_B.17
PWM_MOT_1: Commande Driver.1, MY_RIO_PORT_B.31
PWM_MOT_2: Commande Driver.6, MY_RIO_PORT_B.29
PWM_OPTO: MY_RIO_PORT_A.27, TP1.1, TP2.1, TP3.1, TP4.1
PWM_ROULIS_1: MY_RIO_PORT_A.31, TR1.1, TR2.1
PWM_ROULIS_2: MY_RIO_PORT_A.29, TR3.1, TR4.1
RX_3232: MAX3232CDWRE4.14 (DOUT1), XSENSE.4
TX_3232: MAX3232CDWRE4.13 (RIN1), XSENSE.3
UART_RX: DZ5.1 (K), MAX3232CDWRE4.12 (ROUT1), MY_RIO_PORT_A.10
UART_TX: DZ5.2 (K), MAX3232CDWRE4.11 (DIN1), MY_RIO_PORT_A.14
