Ahhj93/mini-apterros/(commit log)

2026-09-26 docs: organiser la documentation du projet
2026-10-06 feat: add pwm c source code
2026-10-11 feat: implement PWM control and synchronization for Jetson Nano
2026-10-15 feat: add PWM control implementation and update Makefile
2026-10-15 feat: ajouter les fichiers binaires pwm.o et control.cgi
2026-10-17 feat: improve comments and documentation in pinmux.c and pwm.c
2026-10-20 feat: add main_pwm implementation and stop_pwm function to PWM control
2026-10-20 feat: add lidar sensor reading functionality
2026-10-20 refractor: change folder pcb
2026-10-20 feat: add LIDAR sensor functionality and update web interface for real-time data display
2026-10-20 feat: add pcb
2026-10-21 feat: implement PWM and LIDAR functionality with supporting scripts and Makefiles
2026-10-21 refactor: update pwm_permissions comments for clarity
2026-10-23 ci: build control.cgi and sensors.cgi for the Jetson Nano
    Compile both CGI scripts on an arm64 runner inside an Ubuntu 18.04
    container, so they match the Jetson Nano architecture and glibc, then
    commit them in src/jetson-nano/website/cgi-bin. The sync workflow can
    now be dispatched so the jetson-nano branch picks up the new binaries.
    Claude-Session: https://claude.ai/code/session_013f7X9Q65Ckyc6cVLp6c5Xe
2026-10-23 build: update control.cgi and sensors.cgi
2026-10-23 ci: synchronize jetson-nano from main only
    Pushes to other branches no longer overwrite the jetson-nano branch,
    and the CGI build only dispatches the synchronization on main.
    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
